Minh-Nguyen-CEAA/Optimal-Control-Of-A-Pesticide-Spray-Robot-Operating-In-A-Greenhouse/Data Calib/data2x2/UWB Noise Distribution.png

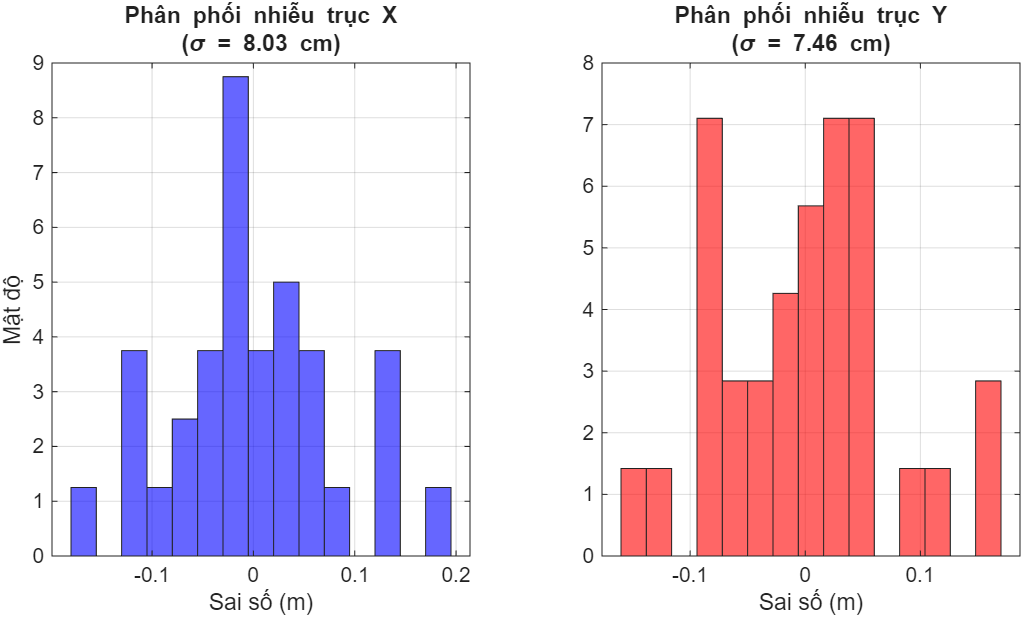
Data Calib/data2x2/UWB Noise Distribution.png
