Minh-Nguyen-CEAA/Optimal-Control-Of-A-Pesticide-Spray-Robot-Operating-In-A-Greenhouse/Slide.pdf

## ĐẠI HỌC QUỐC GIA THÀNH PHỐ HỒ CHÍ MINH TRƯỜNG ĐẠI HỌC BÁCH KHOA

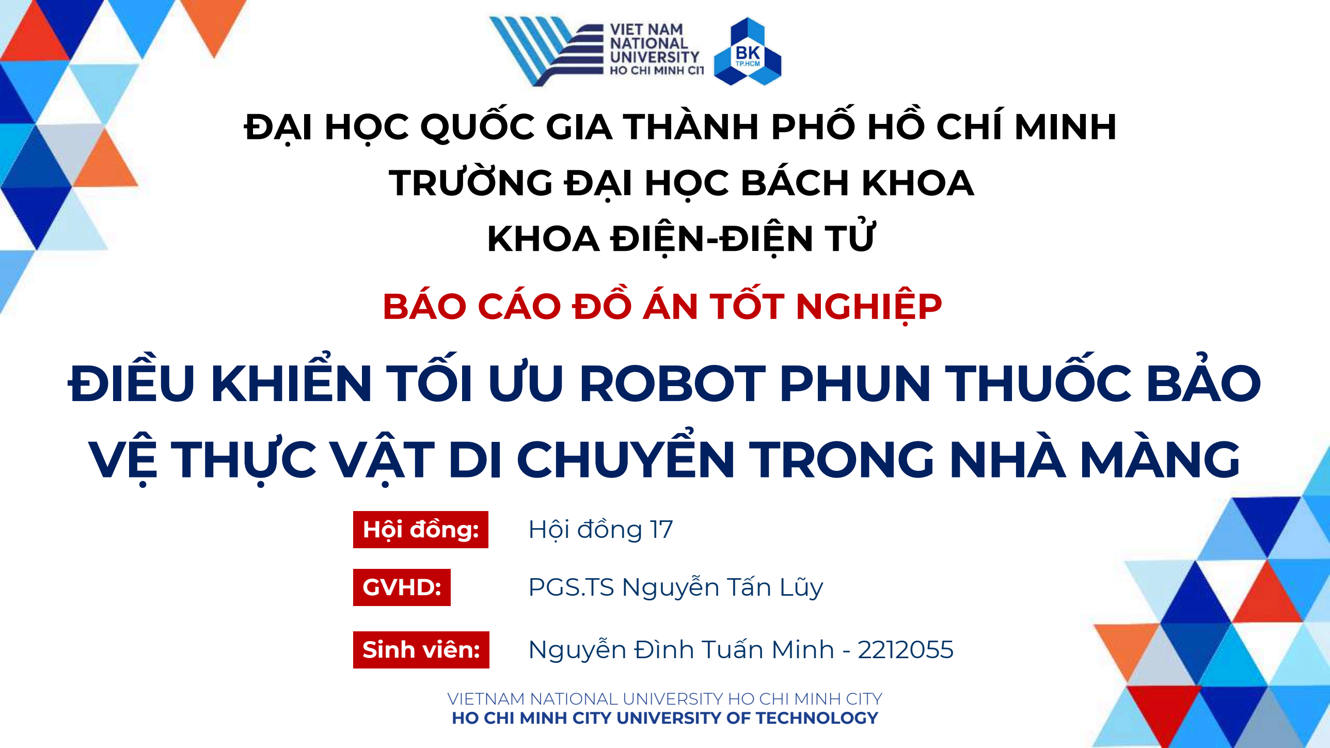
[picture p74: page 1]

VIETNAM NATIONAL UNIVERSITY HO CHI MINH CITY HO CHI MINH CITY UNIVERSITY OF TECHNOLOGY

# ĐIỀU KHIỂN TỐI ƯU ROBOT PHUN THUỐC BẢO VỆ THỰC VẬT DI CHUYỂN TRONG NHÀ MÀNG

## BÁO CÁO ĐỒ ÁN TỐT NGHIỆP

Sinh viên:

GVHD:

Nguyễn Đình Tuấn Minh - 2212055

PGS.TS Nguyễn Tấn Lũy

Hội đồng: Hội đồng 17

## KHOA ĐIỆN-ĐIỆN TỬ

## MỤC LỤC

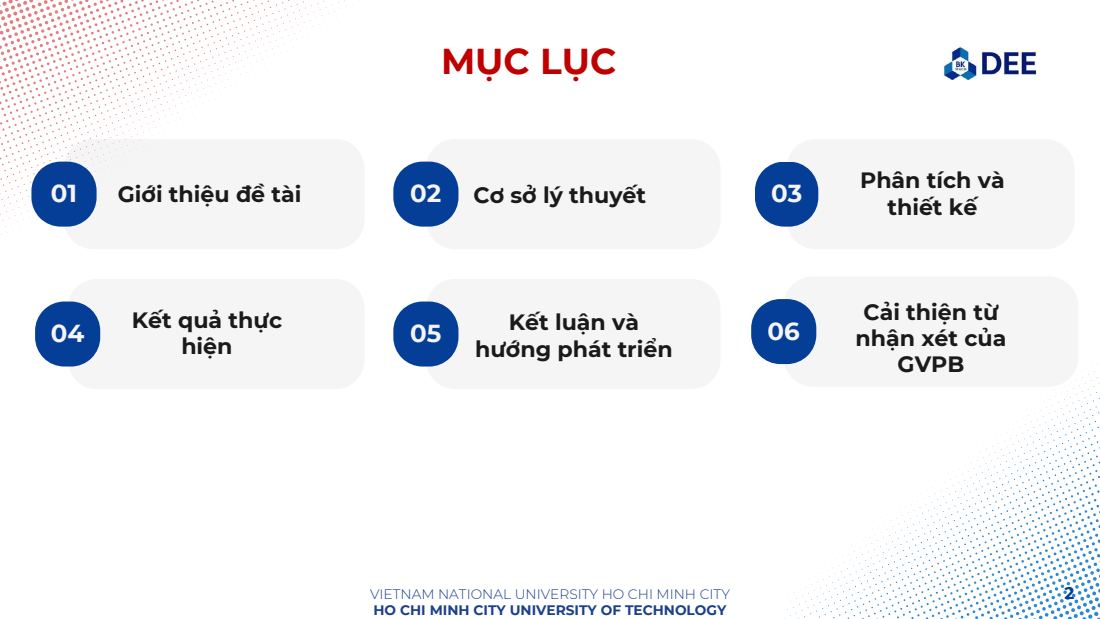
[picture p75: page 2]
Giới thiệu đề tài; Cơ sở lý thuyết; thiết kế

Phân tích và

Cải thiện từ
nhận xét của
GVPB

Kết quả thực
hiện

Kết luận và
hướng phát triển

VIETNAM NATIONAL UNIVERSITY HO CHI MINH CITY
HO CHI MINH CITY UNIVERSITY OF TECHNOLOGY

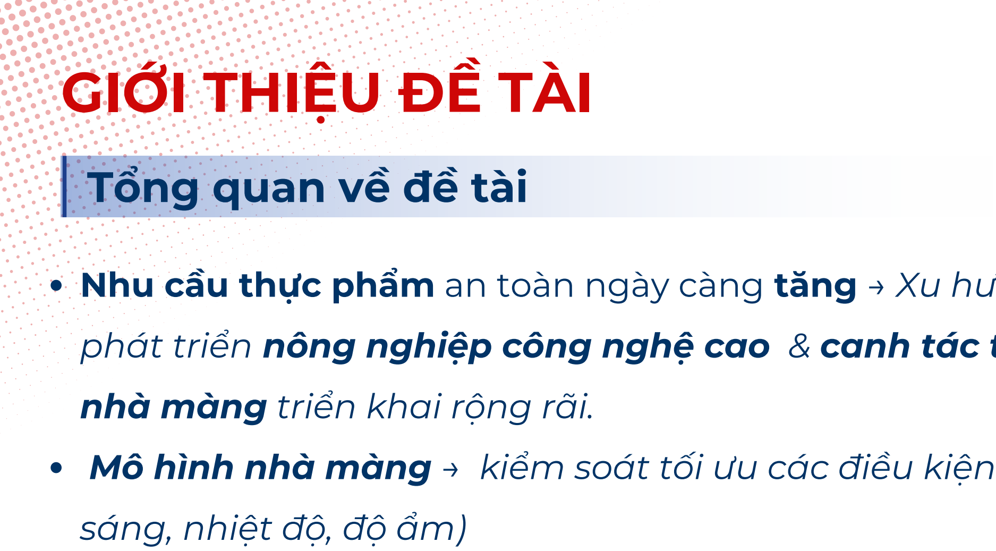
[picture p76: figure]
GIỚI THIỆU ĐỀ TÀI; nhà màng triển khai rộng rãi.; sáng, nhiệt độ, độ ẩm); Tổng quan về đề tài
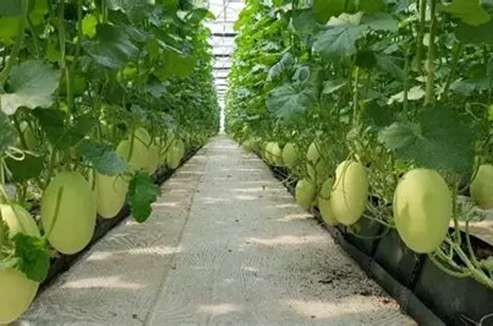
[picture p77: figure]

Nhu cầu thực phẩm an toàn ngày càng tăng → Xu hướng phát triển nông nghiệp công nghệ cao & canh tác trong

Mô hình nhà màng → kiểm soát tối ưu các điều kiện (ánh

Tăng năng suất và hạn chế sâu bệnh.
Thực trạng: công đoạn phun thuốc vẫn được thực hiện thủ công hoặc bán tự động
Tăng nguy cơ ngộ độc, bệnh,... cho người lao động

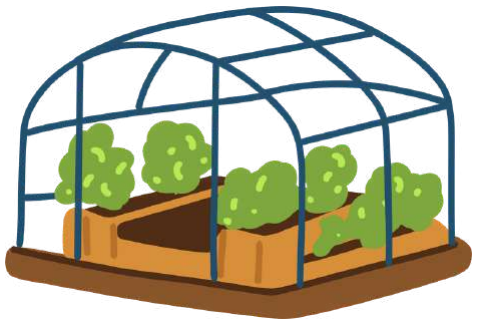
[picture p78: figure]
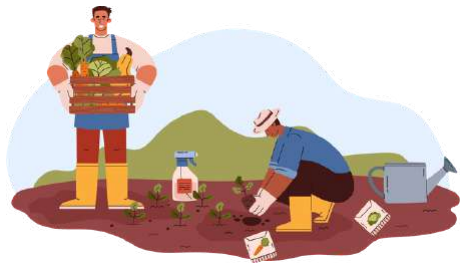
[picture p79: figure]

3

Hình 1. Mô hình nông nghiệp nhà màng tại Việt Nam
2-3lâ
̀
n
tỉ lệ công nhân trong
nhà màng bệnh so với
ngoài trời

30-50%

Tiết kiệm lượng thuốc

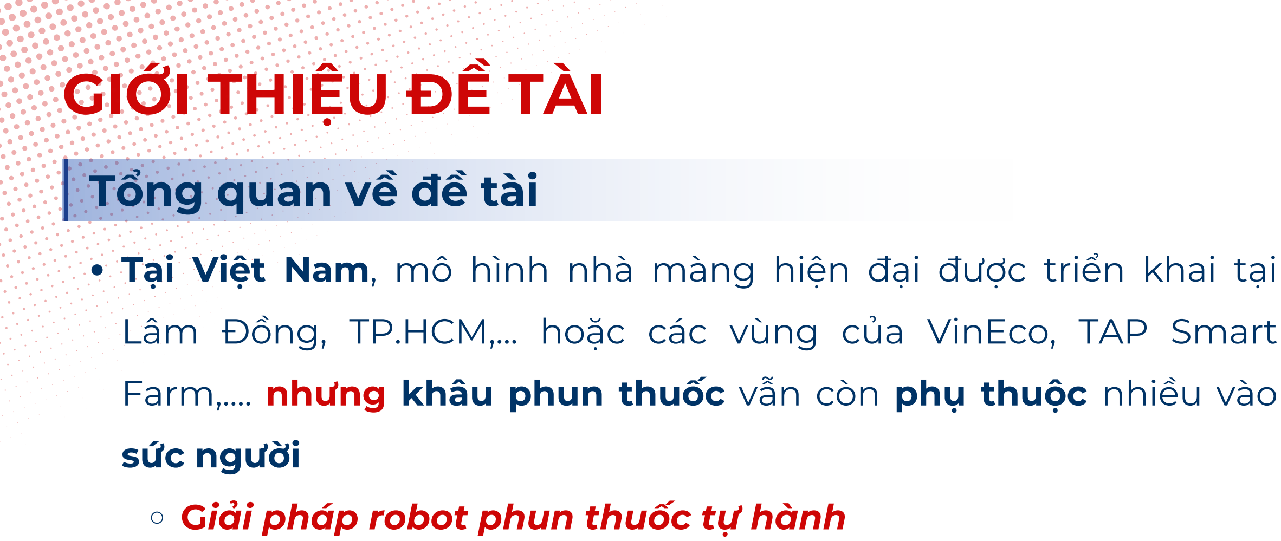
[picture p80: figure]
GIỚI THIỆU ĐỀ TÀI; Lâm Đồng, TP.HCM,... hoặc các; vùng của VinEco, TAP Smart; sức người Giải pháp robot phun thuốc tự hành; Tổng quan về đề tài

Tại Việt Nam, mô hình nhà màng hiện đại được triển khai tại

Farm,.... nhưng khâu phun thuốc vẫn còn phụ thuộc nhiều vào

Thách thức của robot trong nhà màng: Điều khiển và định vị chính xác khi tín hiệu GPS bị hạn chế và môi trường có nhiều nhiễu.

4

Hình 1. Mô hình nông nghiệp nhà màng tại Việt Nam

Đề tài tập trung xây dựng robot phun thuốc tự hành sử dụng kết hợp đa cảm biến (UWB, IMU, Encoder) và thuật toán Kalman mở rộng (EKF) nhằm nâng cao khả năng định vị và điều khiển.

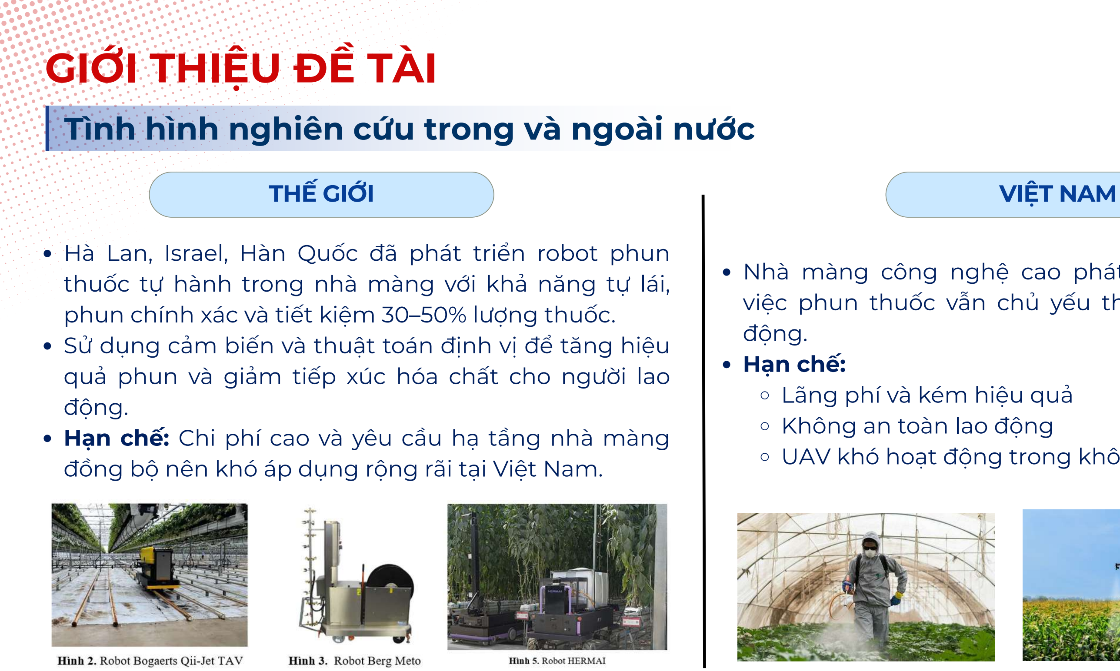
[picture p81: figure]
GIỚI THIỆU ĐỀ TÀI; THẾ GIỚI; VIỆT NAM; động. Hạn chế: Lãng phí và kém hiệu quả Không an toàn lao động; động.
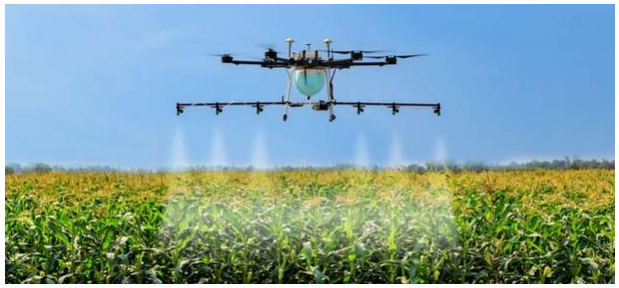
[picture p82: figure]
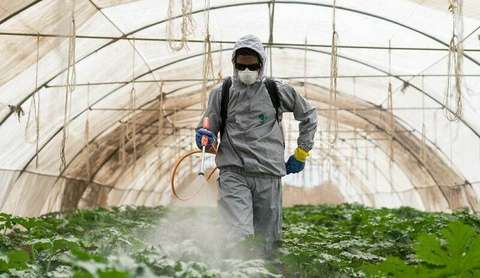
[picture p83: figure]

Nghiên cứu robot phun thuốc tự hành phù hợp điều kiện Việt Nam, ứng dụng thuật toán điều
khiển và định vị. | 5

Nhà màng công nghệ cao phát triển nhanh nhưng việc phun thuốc vẫn chủ yếu thủ công hoặc bán tự

UAV khó hoạt động trong không gian nhà màng.

Hà Lan, Israel, Hàn Quốc đã phát triển robot phun thuốc tự hành trong nhà màng với khả năng tự lái, phun chính xác và tiết kiệm 30–50% lượng thuốc.
Sử dụng cảm biến và thuật toán định vị để tăng hiệu quả phun và giảm tiếp xúc hóa chất cho người lao

Hạn chế: Chi phí cao và yêu cầu hạ tầng nhà màng đồng bộ nên khó áp dụng rộng rãi tại Việt Nam.

Tình hình nghiên cứu trong và ngoài nước

## GIỚI THIỆU ĐỀ TÀI

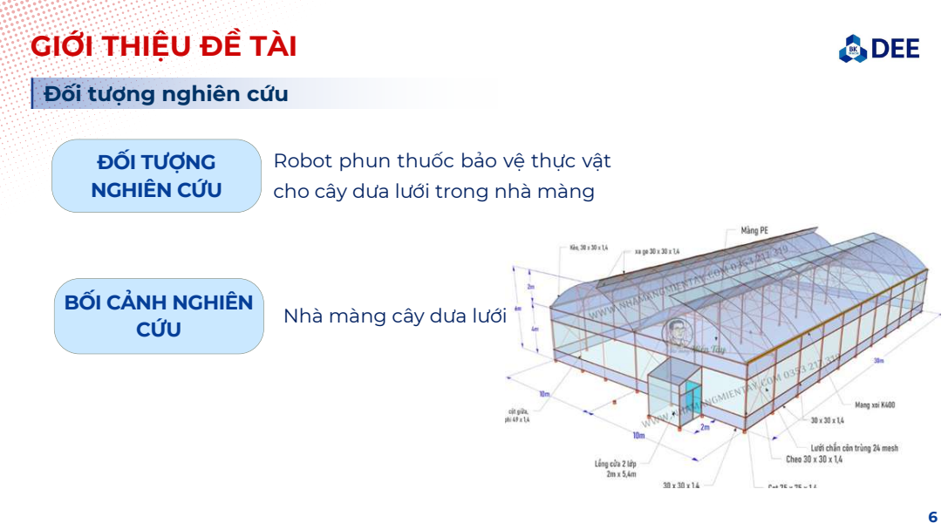
[picture p84: page 6]
ĐỐI TƯỢNG NGHIÊN CỨU

Đối tượng nghiên cứu

Robot phun thuốc bảo vệ thực vật
cho cây dưa lưới trong nhà màng

BỐI CẢNH NGHIÊN
CỨU

Nhà màng cây dưa lưới

## GIỚI THIỆU ĐỀ TÀI

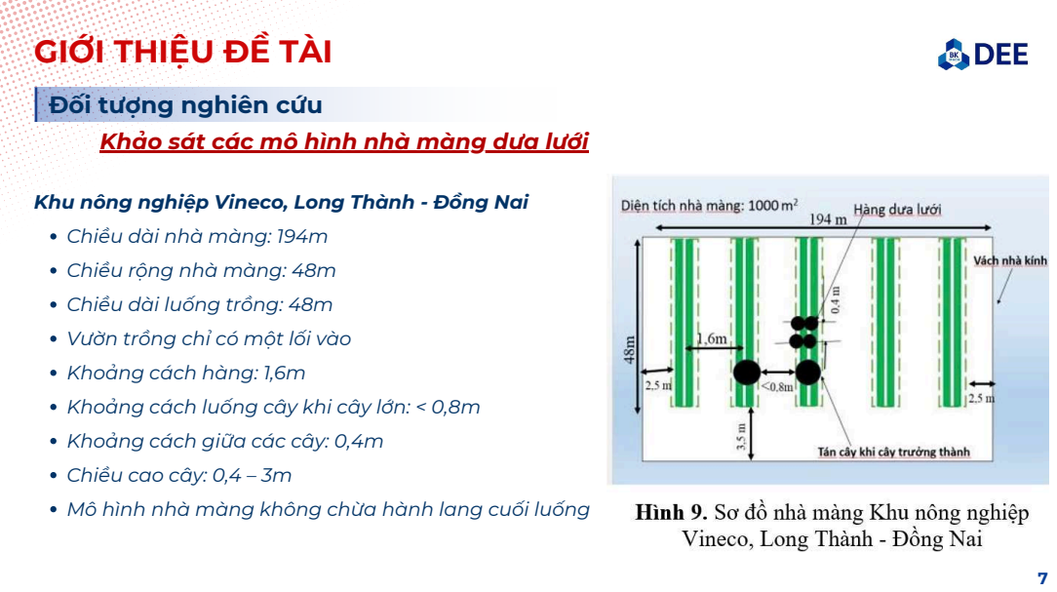
[picture p85: page 7]

Đối tượng nghiên cứu
Khảo sát các mô hình nhà màng dưa lưới

Khu nông nghiệp Vineco, Long Thành - Đồng Nai
Chiều dài nhà màng: 194m
Chiều rộng nhà màng: 48m
Chiều dài luống trồng: 48m
Vườn trồng chỉ có một lối vào
Khoảng cách hàng: 1,6m
Khoảng cách luống cây khi cây lớn: < 0,8m
Khoảng cách giữa các cây: 0,4m
Chiều cao cây: 0,4 – 3m
Mô hình nhà màng không chừa hành lang cuối luống

## GIỚI THIỆU ĐỀ TÀI

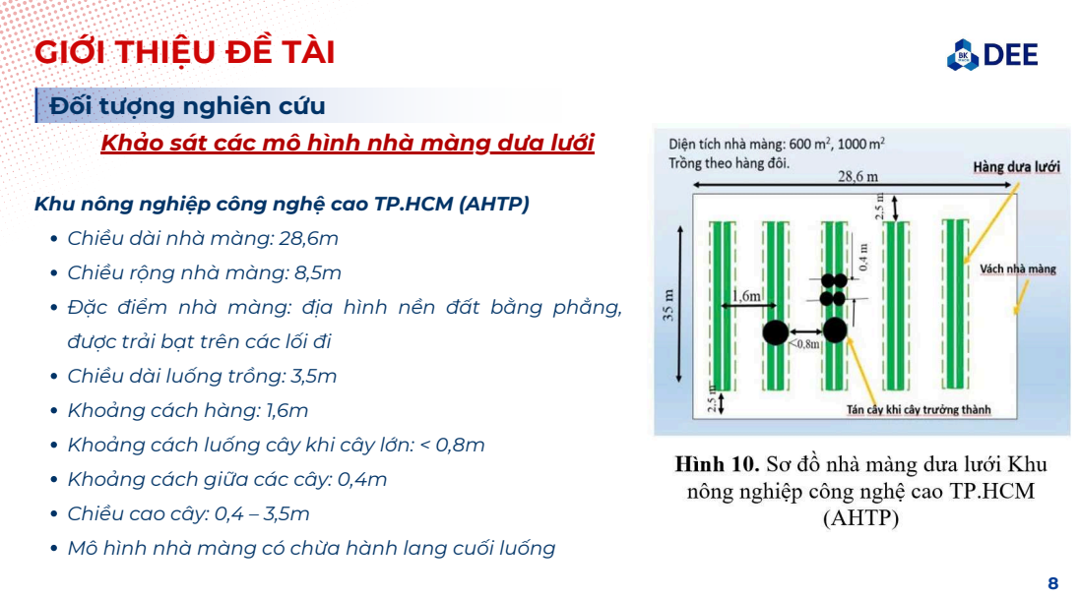
[picture p86: page 8]

Đối tượng nghiên cứu
Khảo sát các mô hình nhà màng dưa lưới

Khu nông nghiệp công nghệ cao TP.HCM (AHTP)
Chiều dài nhà màng: 28,6m
Chiều rộng nhà màng: 8,5m
Đặc điểm nhà màng: địa hình nền đất bằng phẳng,
được trải bạt trên các lối đi
Chiều dài luống trồng: 3,5m
Khoảng cách hàng: 1,6m
Khoảng cách luống cây khi cây lớn: < 0,8m
Khoảng cách giữa các cây: 0,4m
Chiều cao cây: 0,4 – 3,5m
Mô hình nhà màng có chừa hành lang cuối luống

## GIỚI THIỆU ĐỀ TÀI

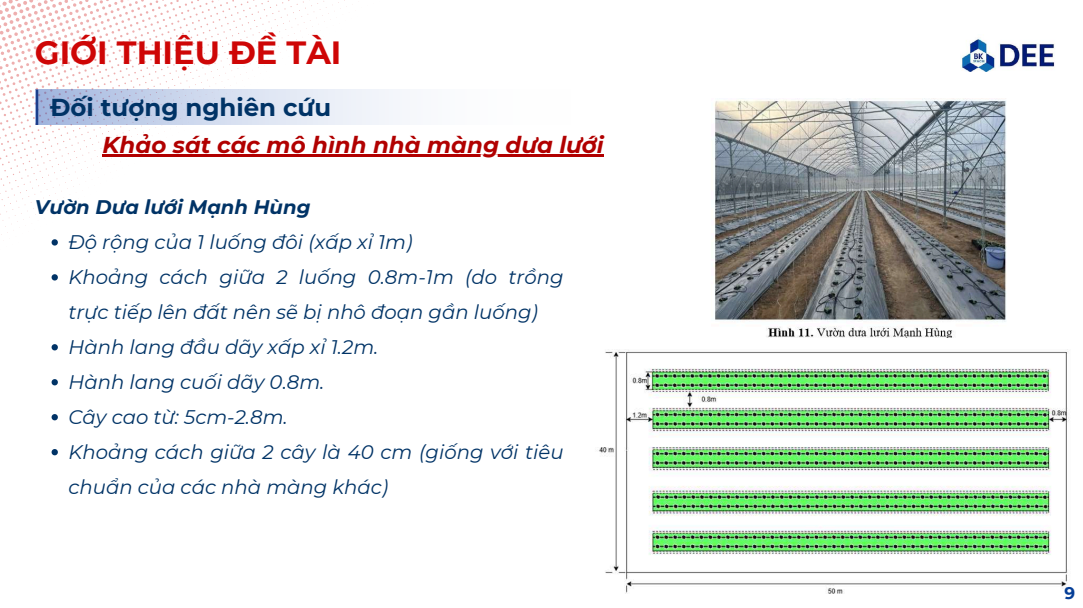
[picture p87: page 9]

Đối tượng nghiên cứu
Khảo sát các mô hình nhà màng dưa lưới

Vườn Dưa lưới Mạnh Hùng
Độ rộng của 1 luống đôi (xấp xỉ 1m)
Khoảng cách giữa 2 luống 0.8m-1m (do trồng
trực tiếp lên đất nên sẽ bị nhô đoạn gần luống)
Hành lang đầu dãy xấp xỉ 1.2m.
Hành lang cuối dãy 0.8m.
Cây cao từ: 5cm-2.8m.
Khoảng cách giữa 2 cây là 40 cm (giống với tiêu
chuẩn của các nhà màng khác)

## GIỚI THIỆU ĐỀ TÀI

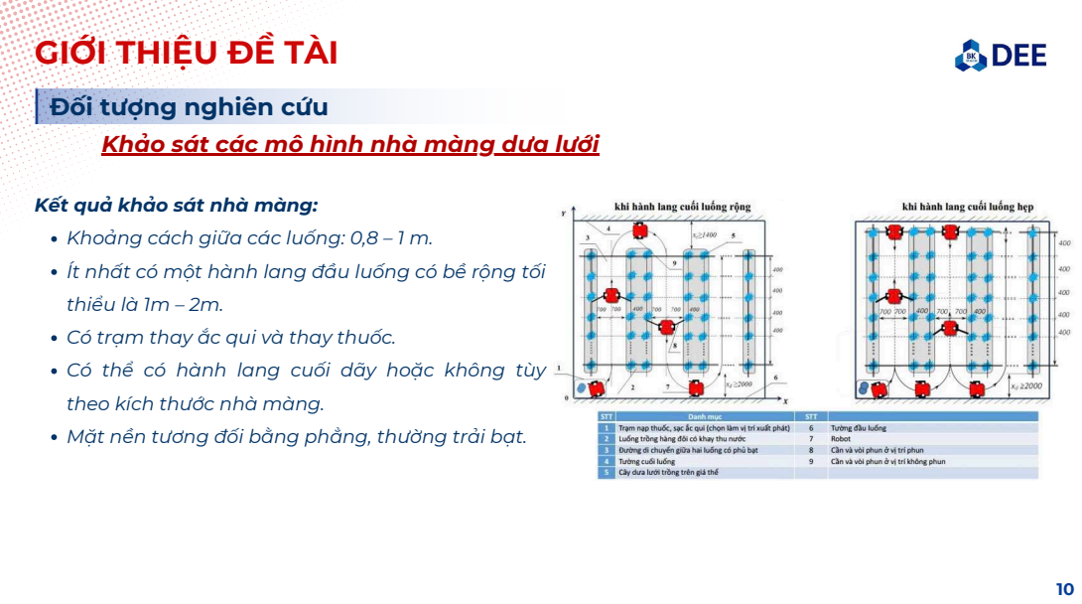
[picture p88: page 10]

Đối tượng nghiên cứu
Khảo sát các mô hình nhà màng dưa lưới

Kết quả khảo sát nhà màng:
Khoảng cách giữa các luống: 0,8 – 1 m.
Ít nhất có một hành lang đầu luống có bề rộng tối
thiểu là 1m – 2m.
Có trạm thay ắc qui và thay thuốc.
Có thể có hành lang cuối dãy hoặc không tùy
theo kích thước nhà màng.
Mặt nền tương đối bằng phẳng, thường trải bạt.

11

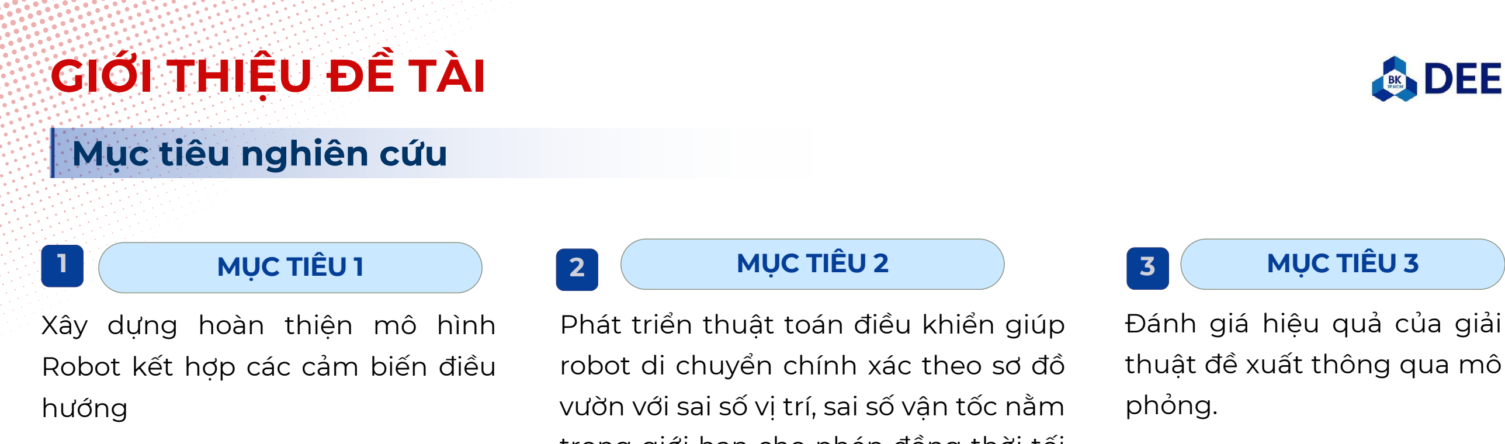
[picture p89: figure]
GIỚI THIỆU ĐỀ TÀI; Xây dựng hoàn thiện mô hình Robot kết hợp các cảm biến điều hướng; Phát triển thuật toán điều khiển giúp robot di chuyển chính xác theo sơ đồ; Đánh giá hiệu quả của giải thuật đề xuất thông qua mô phỏng.; MỤC TIÊU 1; MỤC TIÊU 2; MỤC TIÊU 3; Mục tiêu nghiên cứu

vườn với sai số vị trí, sai số vận tốc nằm trong giới hạn cho phép đồng thời tối ưu hóa năng lượng và bền vững.

4
Phát triển thuật toán định vị dựa trên tổng hợp dữ liệu cảm biến từ Encoder, IMU, UWB thông qua bộ lọc Kalman mở rộng (EKF) cho Robot.

5

Kết hợp bộ lọc EKF và giải thuật điều khiển và thực
nghiệm.
MỤC TIÊU 4 | MỤC TIÊU 5

## GIỚI THIỆU ĐỀ TÀI

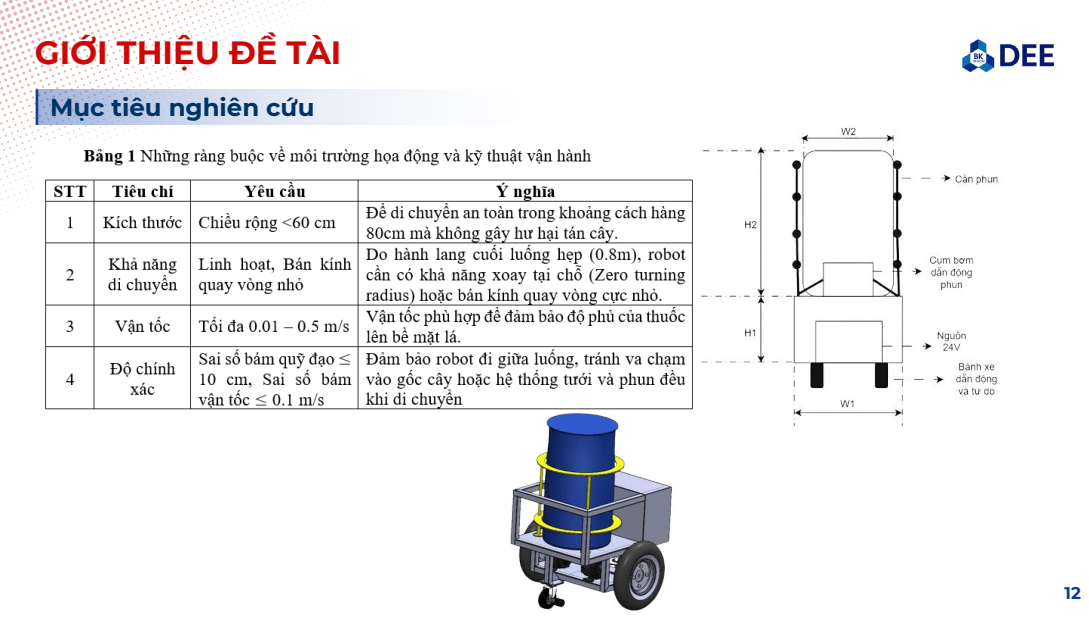
[picture p90: page 12]

Mục tiêu nghiên cứu

## GIỚI THIỆU ĐỀ TÀI

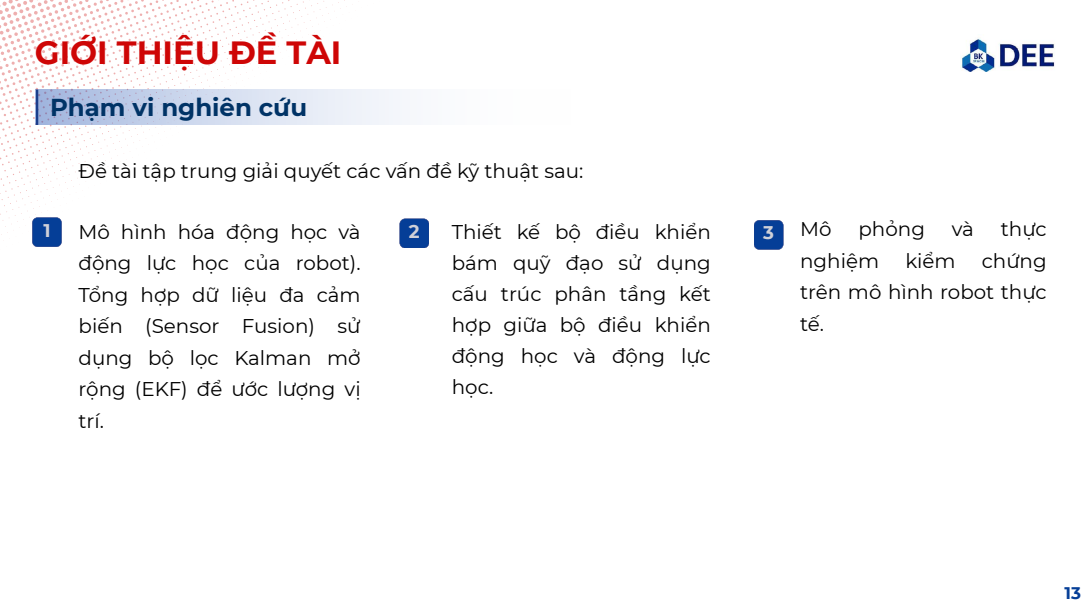
[picture p91: page 13]
Mô hình hóa động học và

Phạm vi nghiên cứu

Đề tài tập trung giải quyết các vấn đề kỹ thuật sau:

động lực học của robot).
Tổng hợp dữ liệu đa cảm
biến (Sensor Fusion) sử
dụng bộ lọc Kalman mở
rộng (EKF) để ước lượng vị
trí.

Thiết kế bộ điều khiển
bám quỹ đạo sử dụng
cấu trúc phân tầng kết
hợp giữa bộ điều khiển
động học và động lực
học.

Mô phỏng và thực
nghiệm kiểm chứng
trên mô hình robot thực

## MÔ HÌNH PHI TUYẾN WMR

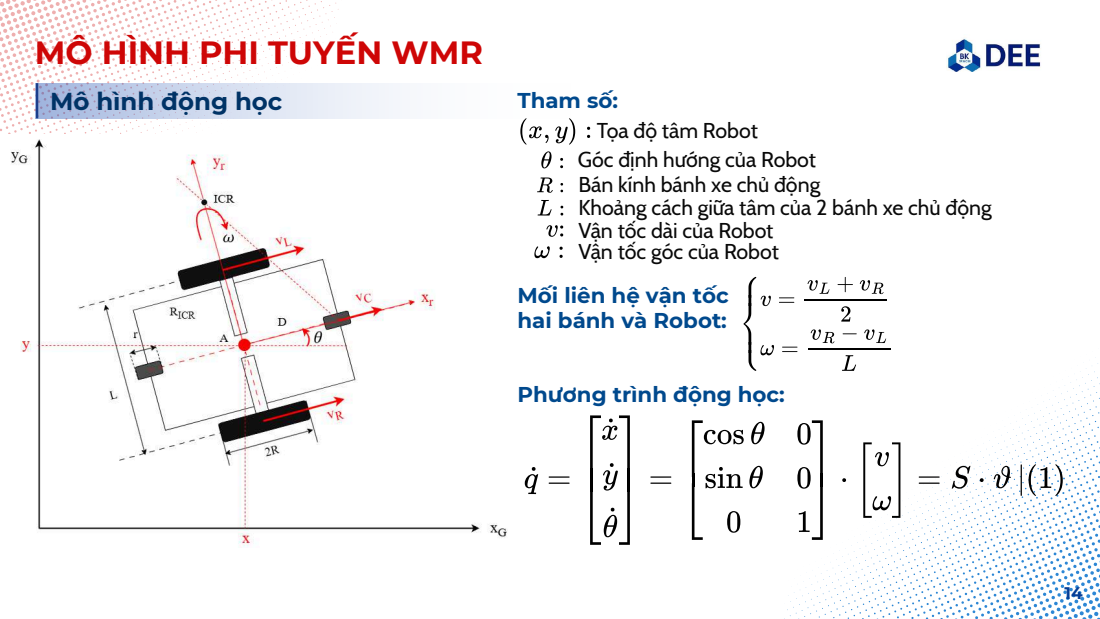
[picture p92: page 14]
Mô hình động học; Tham số:

Tọa độ tâm Robot
Góc định hướng của Robot
Bán kính bánh xe chủ động
Khoảng cách giữa tâm của 2 bánh xe chủ động
Vận tốc dài của Robot
Vận tốc góc của Robot
Mối liên hệ vận tốc
hai bánh và Robot:

Phương trình động học:

## MÔ HÌNH PHI TUYẾN WMR

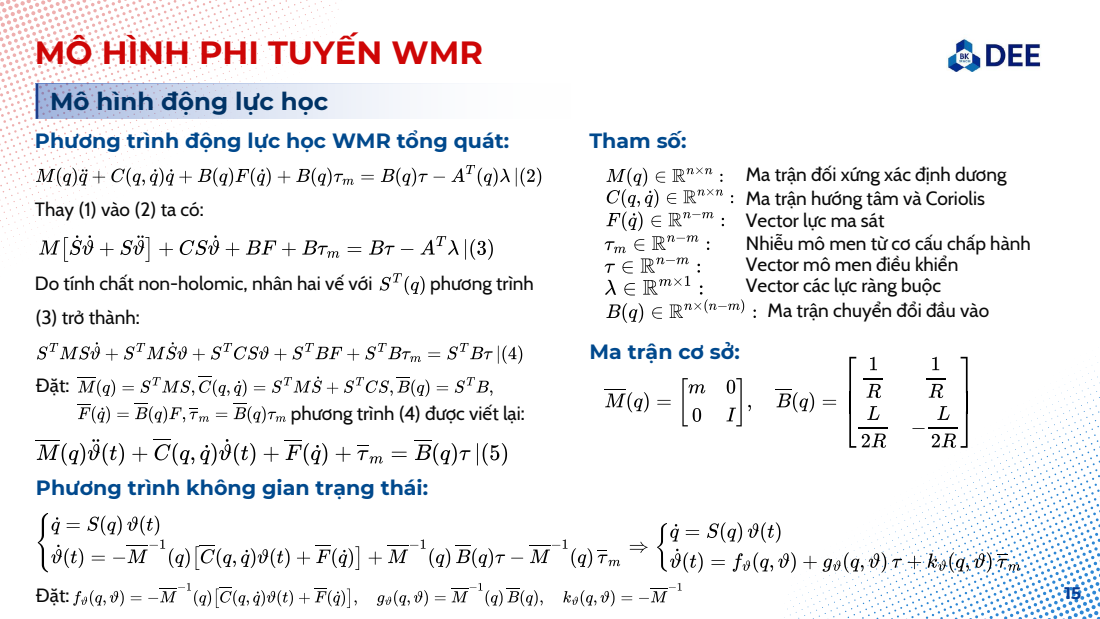
[picture p93: page 15]
Tham số:; phương trình; Đặt:

Mô hình động lực học
Phương trình động lực học WMR tổng quát:

Ma trận đối xứng xác định dương
Ma trận hướng tâm và Coriolis
Vector lực ma sát
Nhiễu mô men từ cơ cấu chấp hành
Vector mô men điều khiển
Vector các lực ràng buộc
Ma trận chuyển đổi đầu vào

Thay (1) vào (2) ta có:

Do tính chất non-holomic, nhân hai vế với
(3) trở thành:

Ma trận cơ sở:

phương trình (4) được viết lại:

Phương trình không gian trạng thái:

## BỘ ĐIỀU KHIỂN ĐỘNG HỌC KANAYAMAN

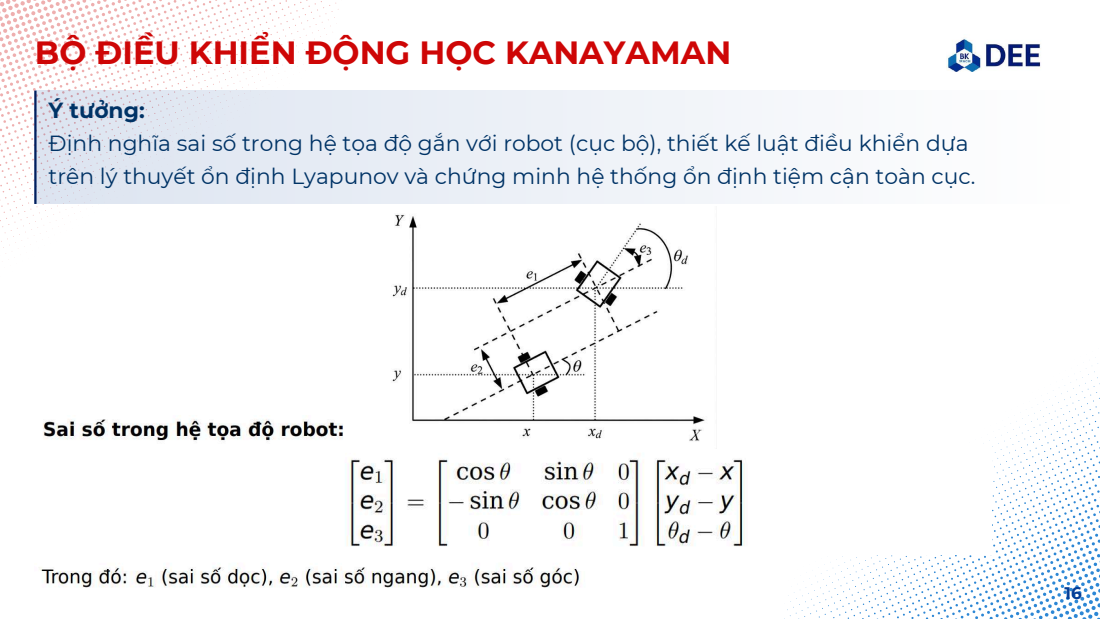
[picture p94: page 16]

Ý tưởng:
Định nghĩa sai số trong hệ tọa độ gắn với robot (cục bộ), thiết kế luật điều khiển dựa
trên lý thuyết ổn định Lyapunov và chứng minh hệ thống ổn định tiệm cận toàn cục.

## BỘ ĐIỀU KHIỂN ĐỘNG HỌC KANAYAMAN

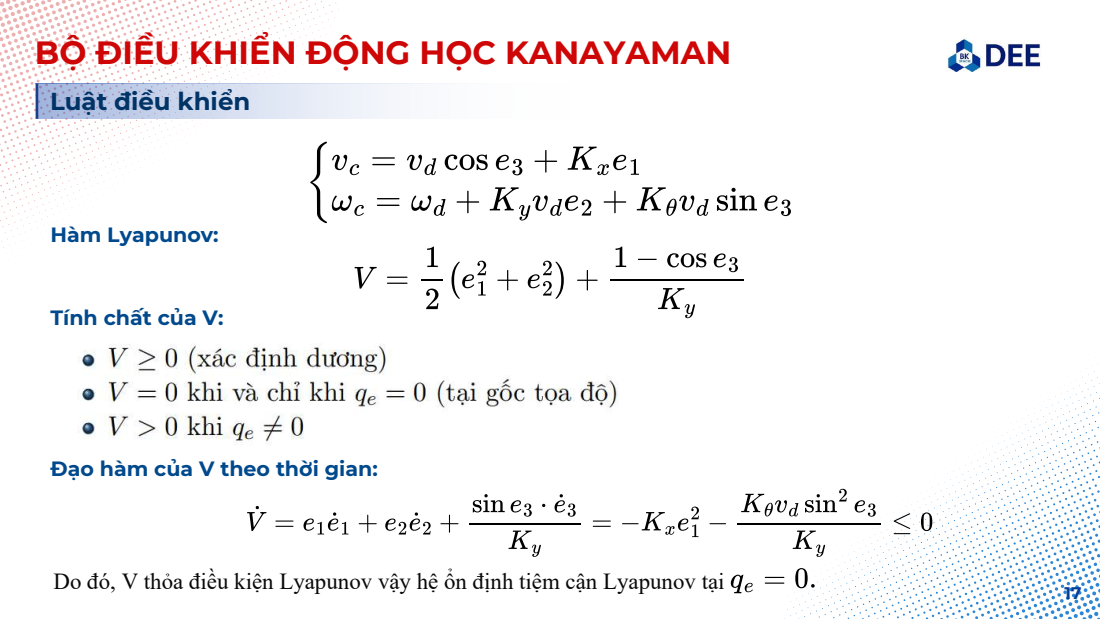
[picture p95: page 17]
Hàm Lyapunov:

Luật điều khiển

Tính chất của V:

Đạo hàm của V theo thời gian:

17 Do đó, V thỏa điều kiện Lyapunov vậy hệ ổn định tiệm cận Lyapunov tại

## HỌC CỦNG CỐ TRONG ĐIỀU KHIỂN THÍCH NGHI BỀN VỮNG

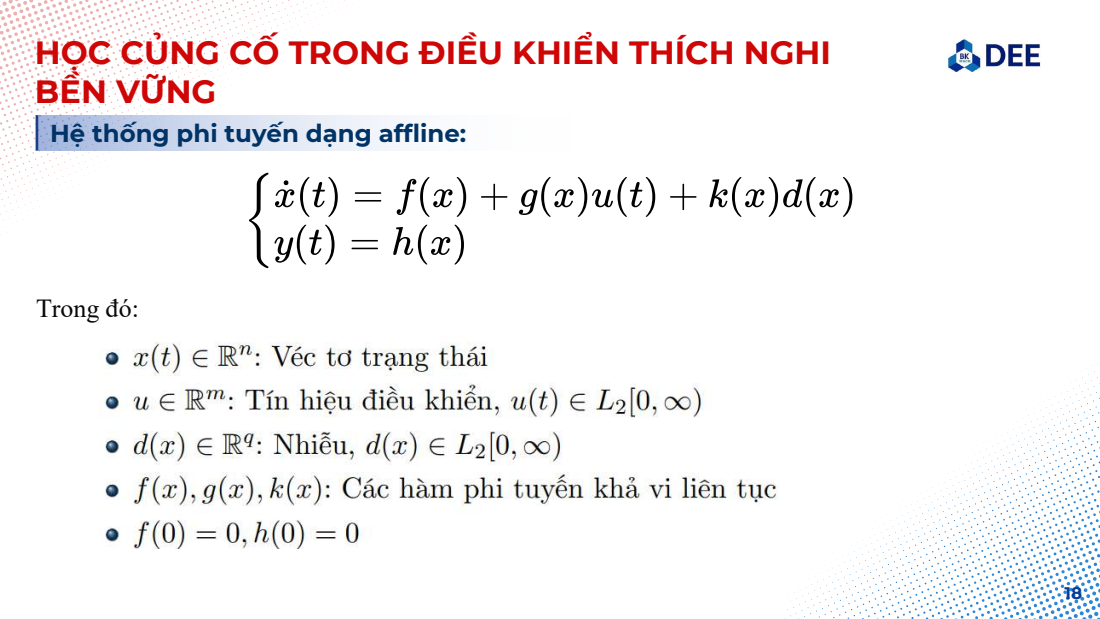
[picture p96: page 18]
Trong đó:

Hệ thống phi tuyến dạng affline:

## HỌC CỦNG CỐ TRONG ĐIỀU KHIỂN THÍCH NGHI BỀN VỮNG

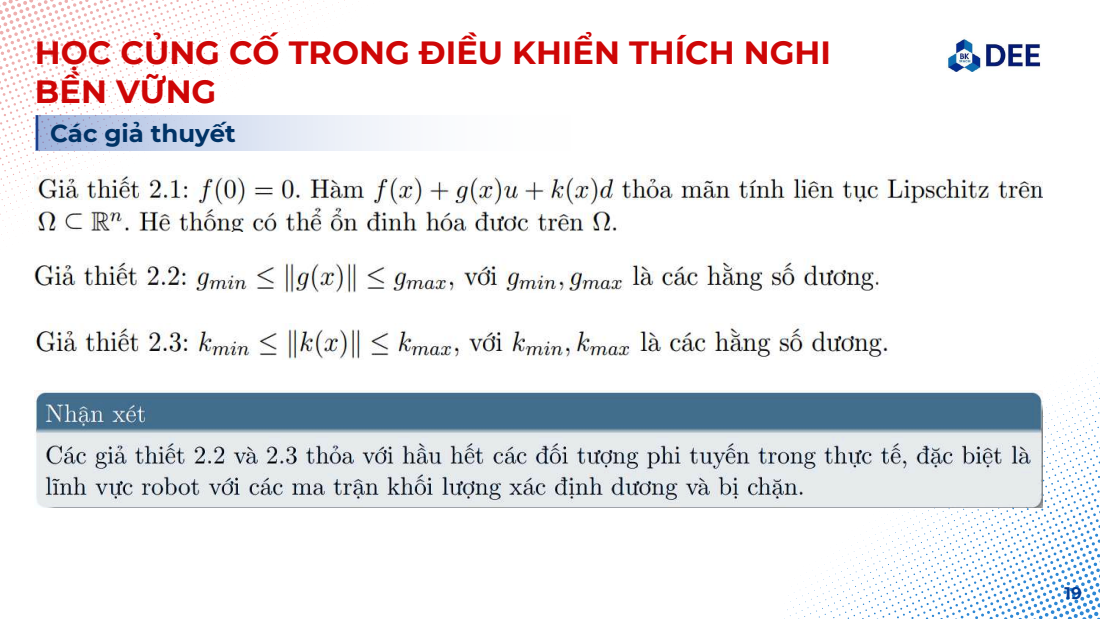
[picture p97: page 19]

Các giả thuyết

## HỌC CỦNG CỐ TRONG ĐIỀU KHIỂN THÍCH NGHI BỀN VỮNG

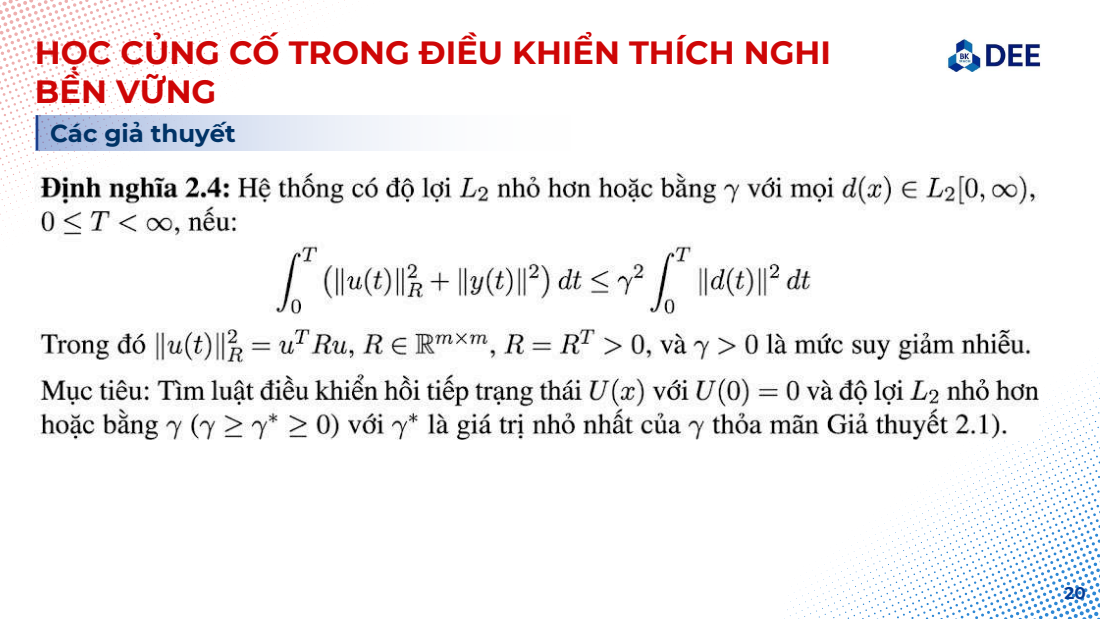
[picture p98: page 20]

Các giả thuyết

## HỌC CỦNG CỐ TRONG ĐIỀU KHIỂN THÍCH NGHI BỀN VỮNG

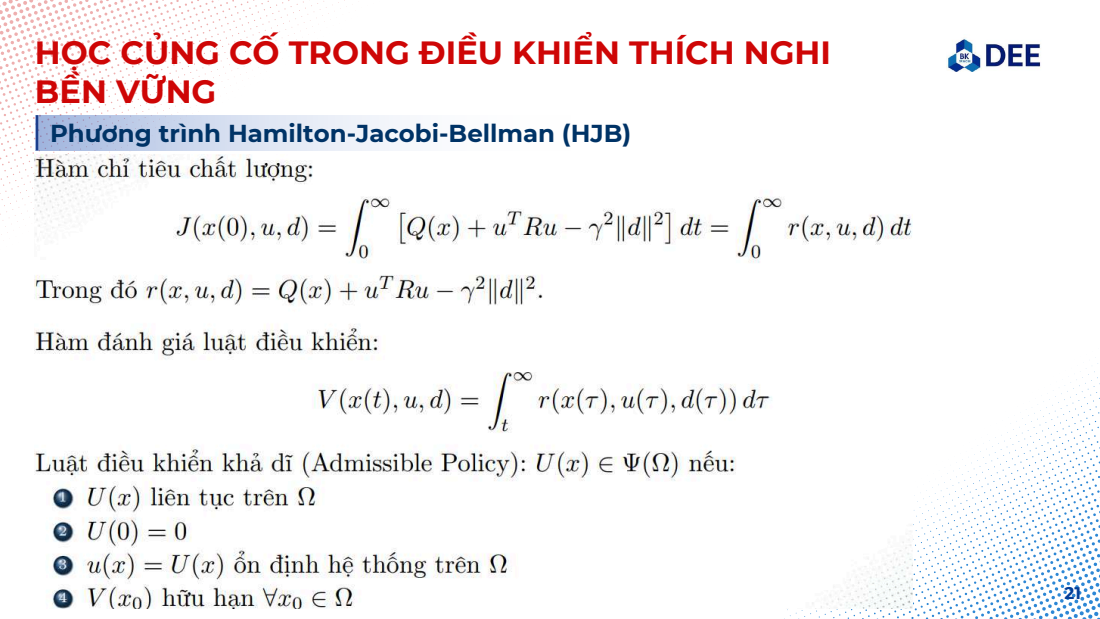
[picture p99: page 21]

Phương trình Hamilton-Jacobi-Bellman (HJB)

## HỌC CỦNG CỐ TRONG ĐIỀU KHIỂN THÍCH NGHI BỀN VỮNG

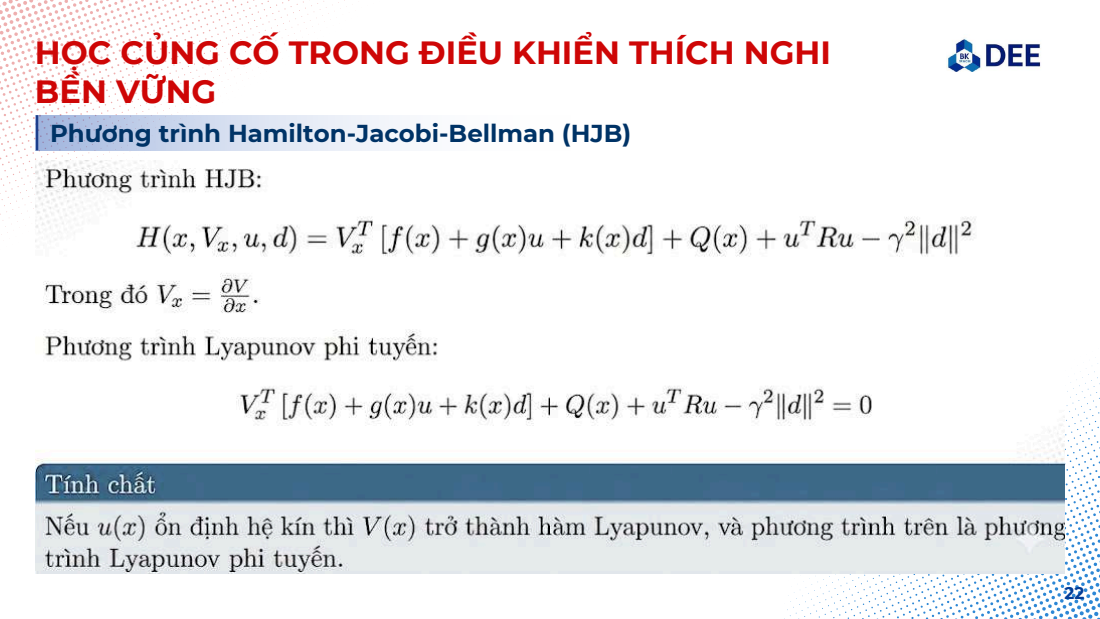
[picture p100: page 22]

Phương trình Hamilton-Jacobi-Bellman (HJB)

## HỌC CỦNG CỐ TRONG ĐIỀU KHIỂN THÍCH NGHI BỀN VỮNG

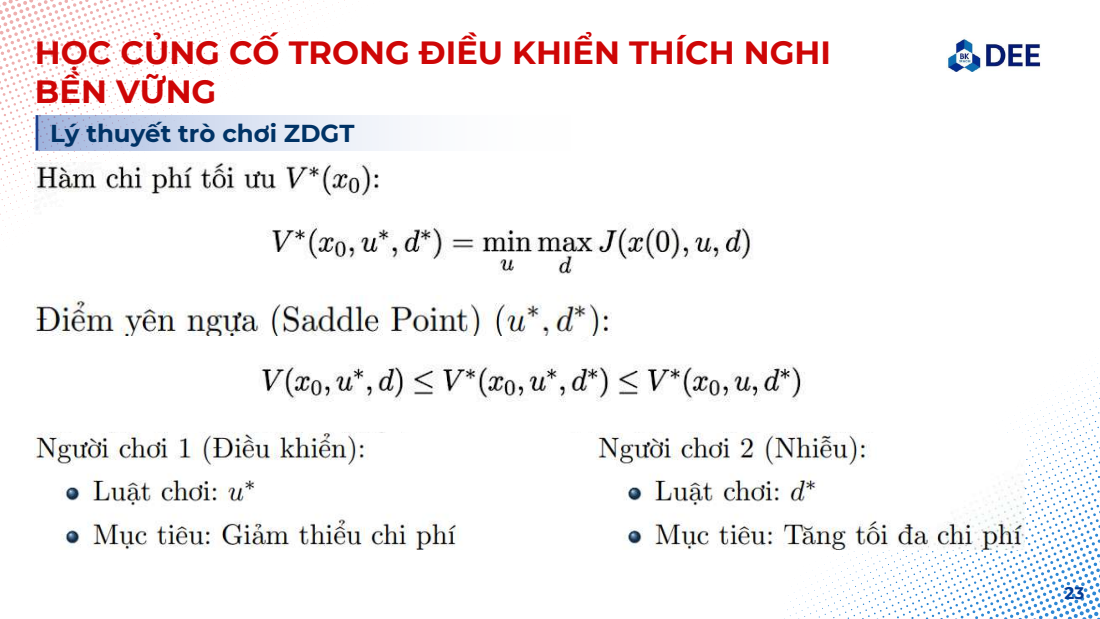
[picture p101: page 23]

Lý thuyết trò chơi ZDGT

## HỌC CỦNG CỐ TRONG ĐIỀU KHIỂN THÍCH NGHI BỀN VỮNG

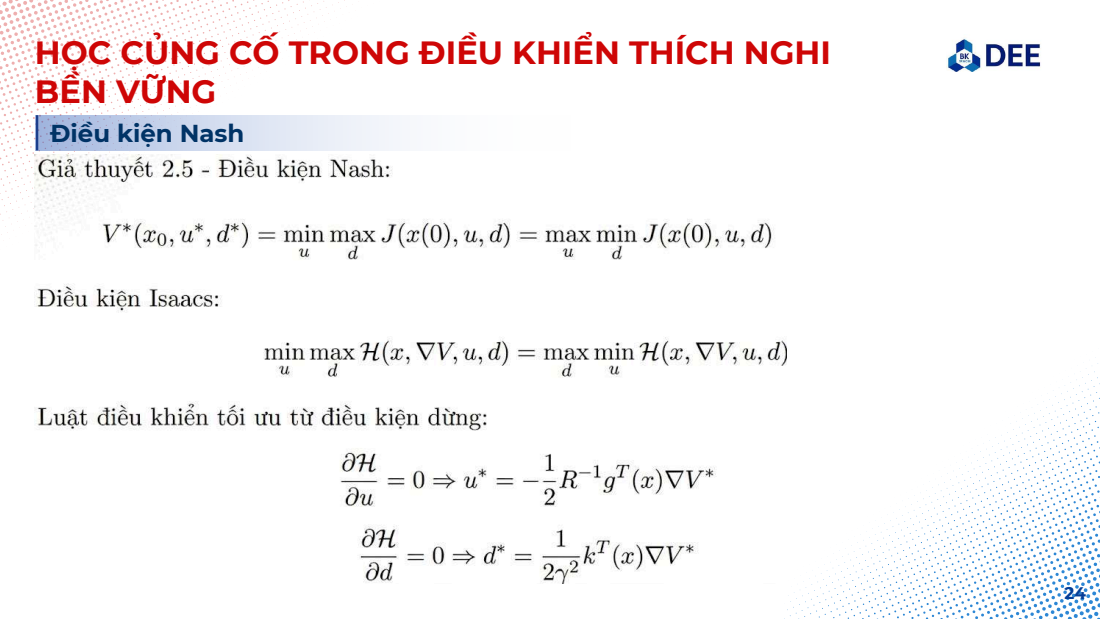
[picture p102: page 24]

Điều kiện Nash

## HỌC CỦNG CỐ TRONG ĐIỀU KHIỂN THÍCH NGHI BỀN VỮNG

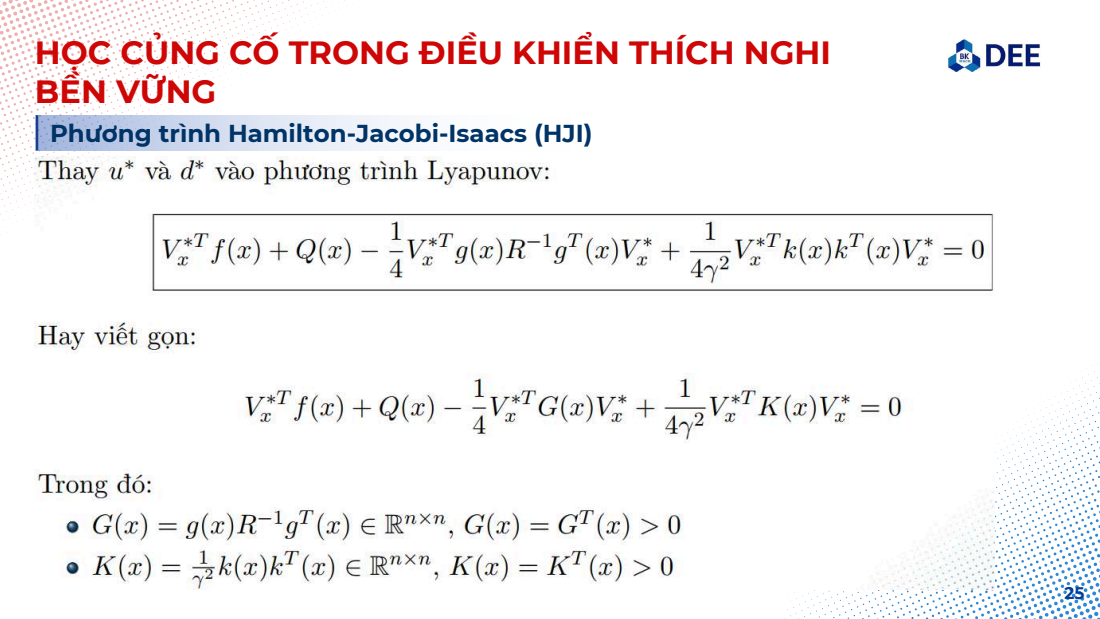
[picture p103: page 25]

Phương trình Hamilton-Jacobi-Isaacs (HJI)

## HỌC CỦNG CỐ TRONG ĐIỀU KHIỂN THÍCH NGHI BỀN VỮNG

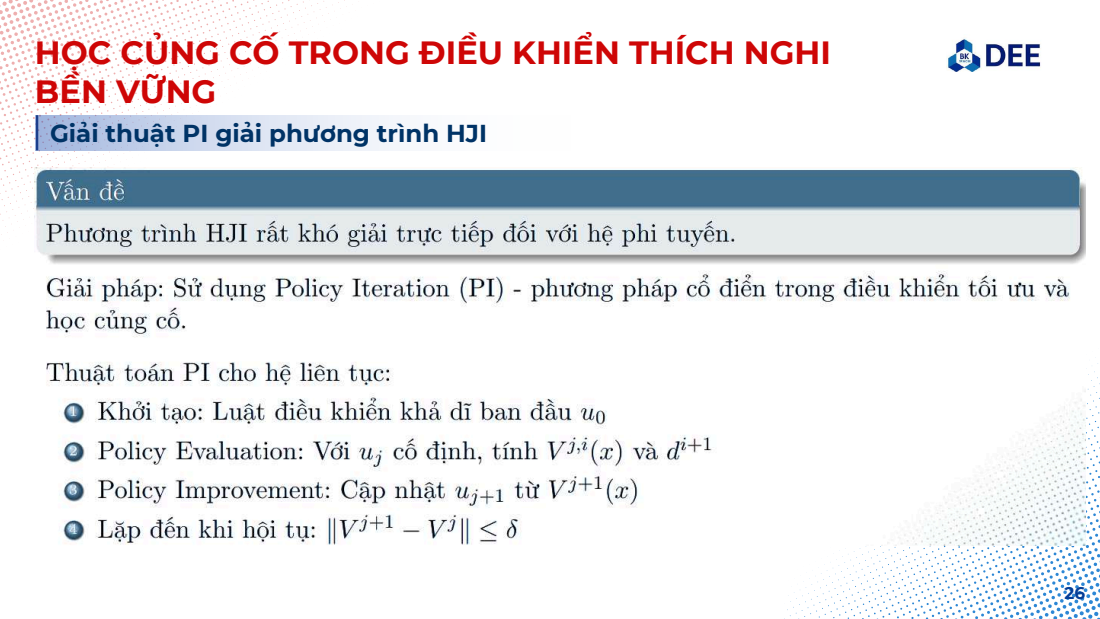
[picture p104: page 26]

Giải thuật PI giải phương trình HJI

## HỌC CỦNG CỐ TRONG ĐIỀU KHIỂN THÍCH NGHI BỀN VỮNG

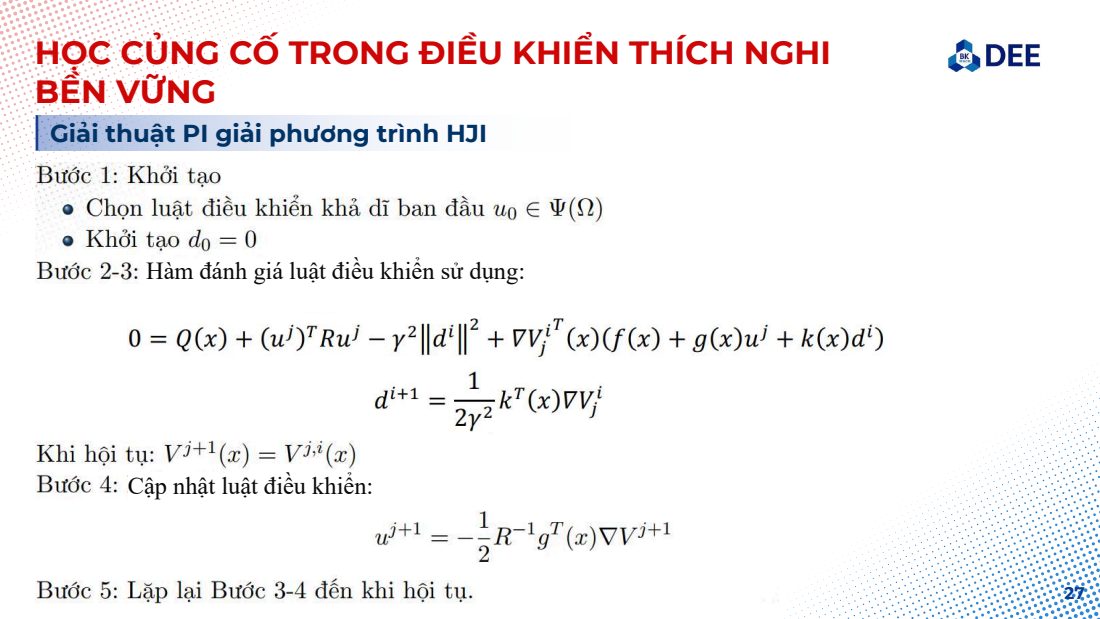
[picture p105: page 27]

Giải thuật PI giải phương trình HJI

Hàm đánh giá luật điều khiển sử dụng:

Cập nhật luật điều khiển:

## HỌC CỦNG CỐ TRONG ĐIỀU KHIỂN THÍCH NGHI BỀN VỮNG

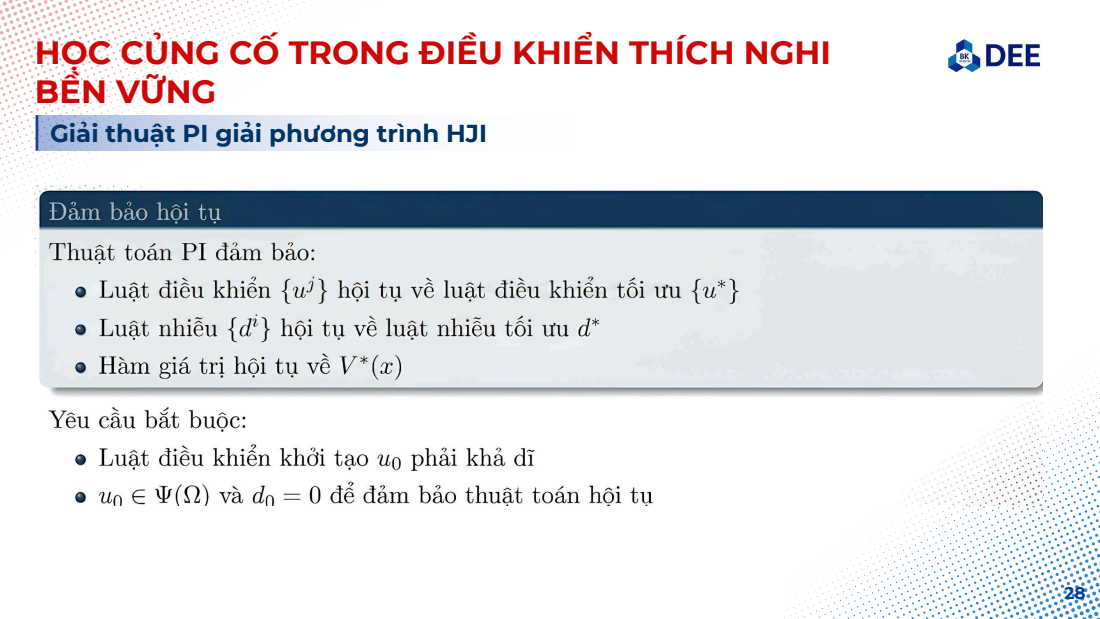
[picture p106: page 28]

Giải thuật PI giải phương trình HJI

## HỌC CỦNG CỐ TRONG ĐIỀU KHIỂN THÍCH NGHI BỀN VỮNG

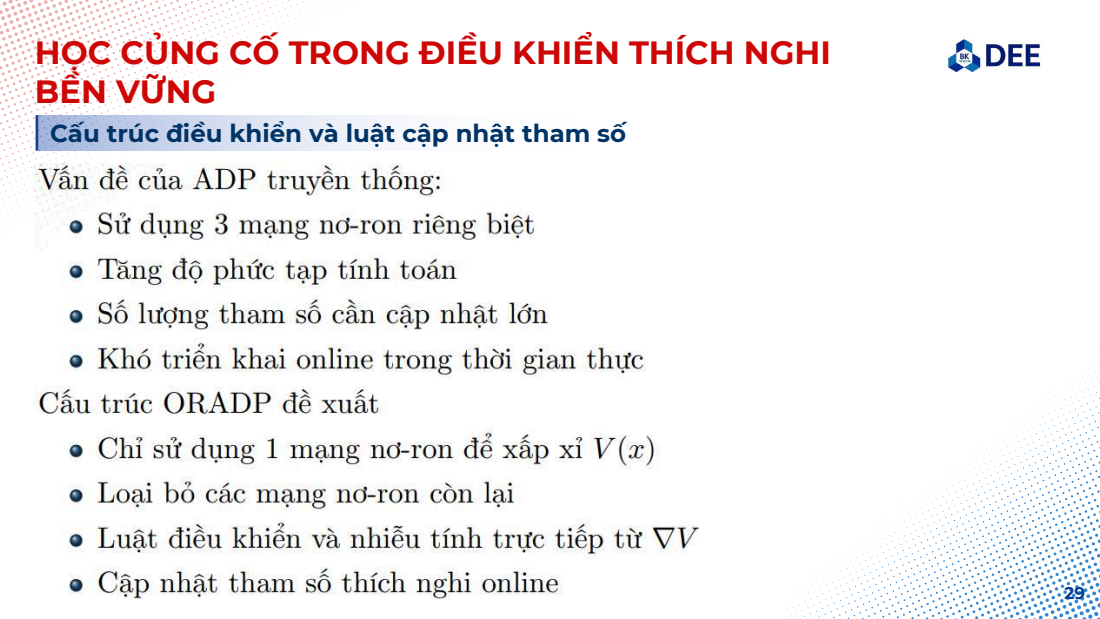
[picture p107: page 29]
sau

Cấu trúc điều khiển và luật cập nhật tham số

## HỌC CỦNG CỐ TRONG ĐIỀU KHIỂN THÍCH NGHI BỀN VỮNG

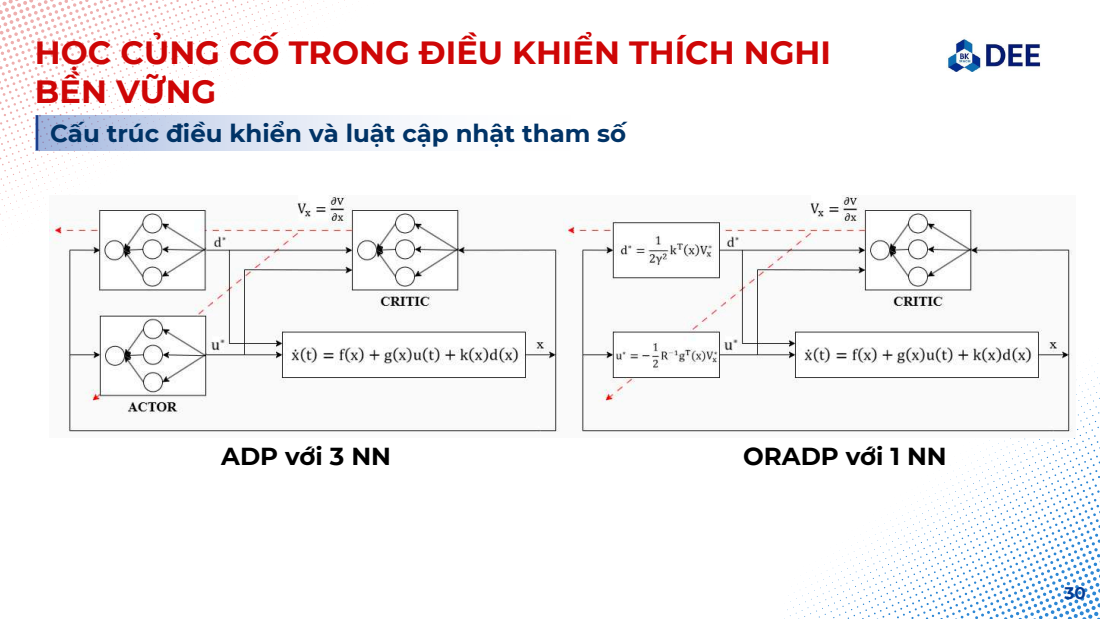
[picture p108: page 30]
ADP với 3 NN; ORADP với 1 NN

Cấu trúc điều khiển và luật cập nhật tham số

## HỌC CỦNG CỐ TRONG ĐIỀU KHIỂN THÍCH NGHI BỀN VỮNG

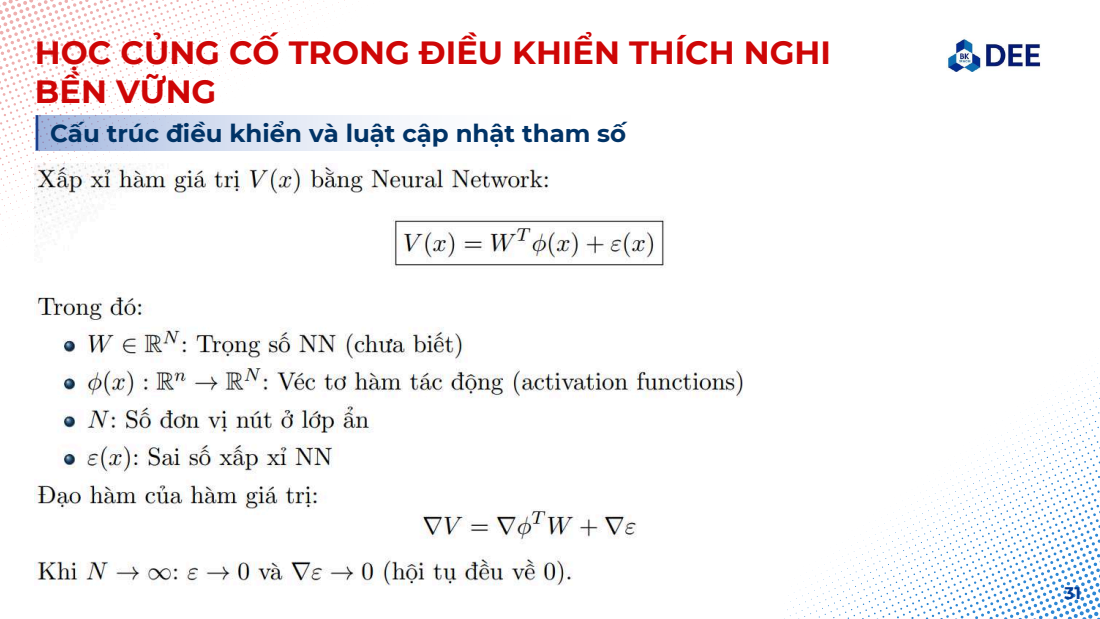
[picture p109: page 31]

Cấu trúc điều khiển và luật cập nhật tham số

## HỌC CỦNG CỐ TRONG ĐIỀU KHIỂN THÍCH NGHI BỀN VỮNG

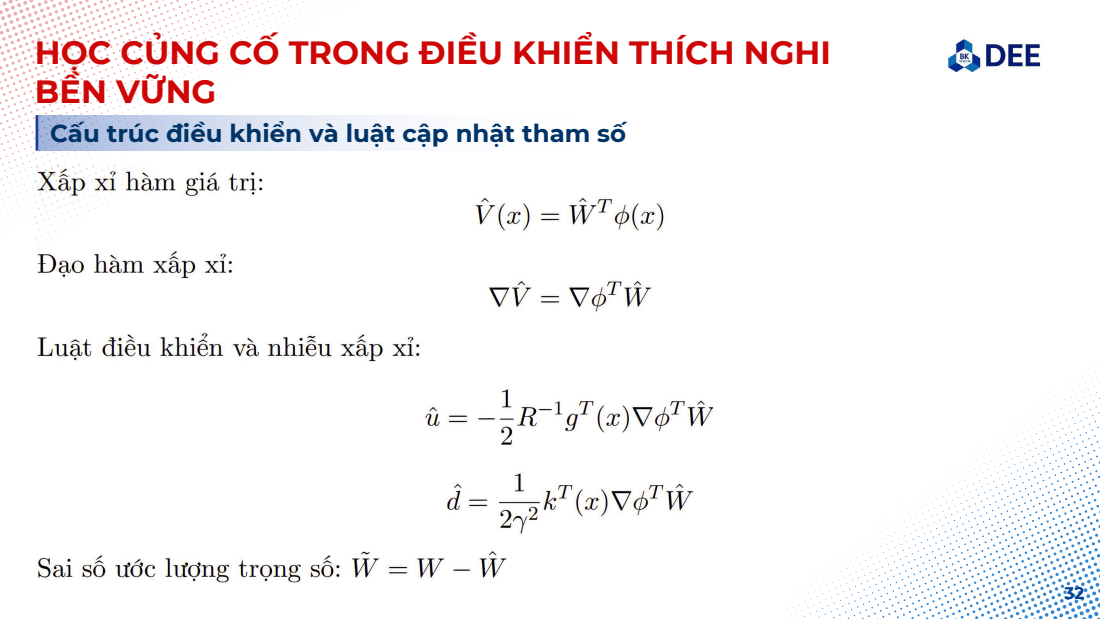
[picture p110: page 32]

Cấu trúc điều khiển và luật cập nhật tham số

## HỌC CỦNG CỐ TRONG ĐIỀU KHIỂN THÍCH NGHI BỀN VỮNG

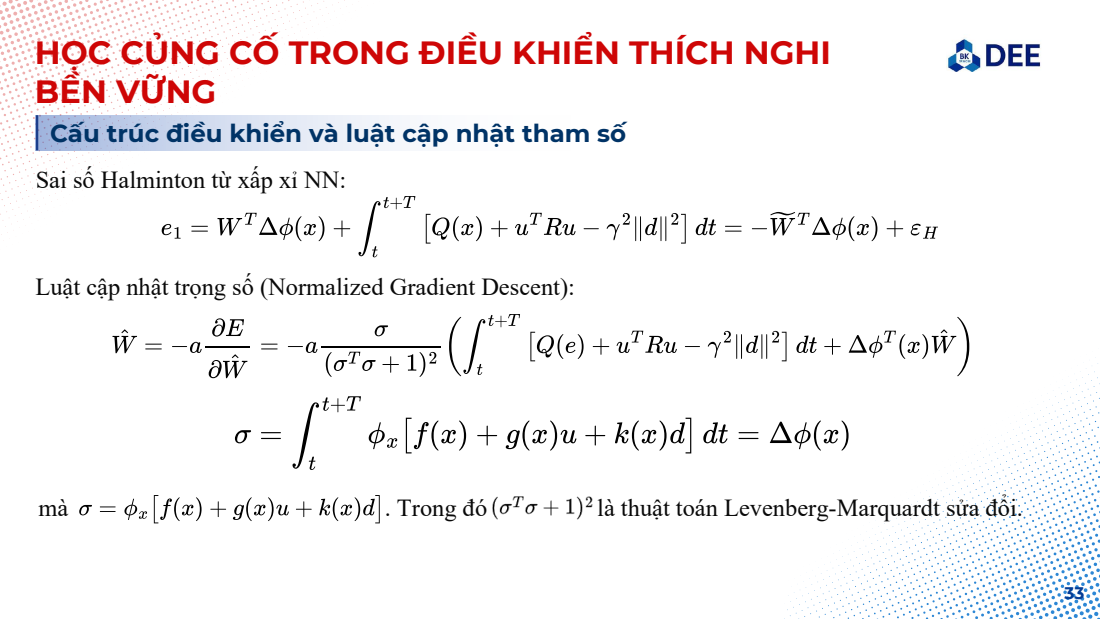
[picture p111: page 33]
. Trong đó; là thuật toán Levenberg-Marquardt sửa đổi.

Cấu trúc điều khiển và luật cập nhật tham số
Sai số Halminton từ xấp xỉ NN:

Luật cập nhật trọng số (Normalized Gradient Descent):

## HỌC CỦNG CỐ TRONG ĐIỀU KHIỂN THÍCH NGHI BỀN VỮNG

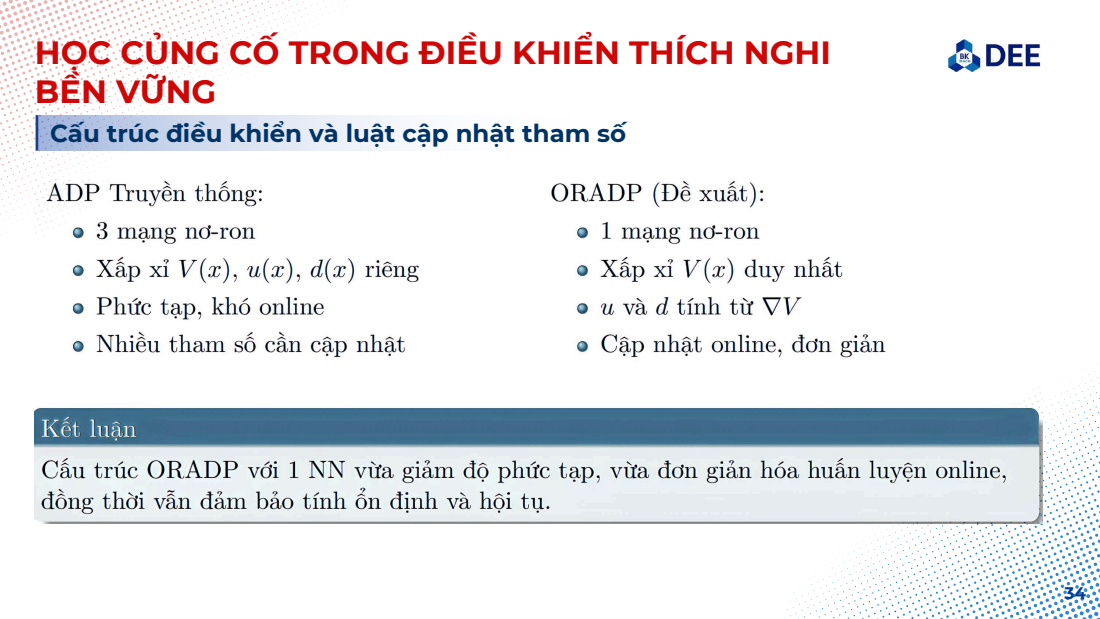
[picture p112: page 34]

Cấu trúc điều khiển và luật cập nhật tham số

## BỘ LỌC KALMAN MỞ RỘNG (EKF)

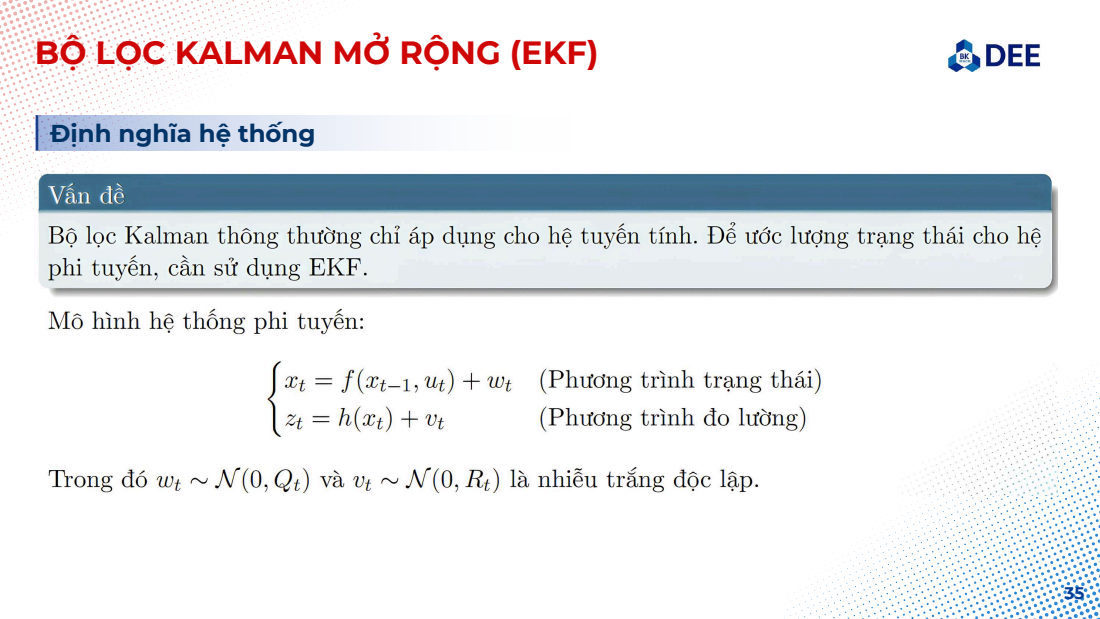
[picture p113: page 35]

Định nghĩa hệ thống

## BỘ LỌC KALMAN MỞ RỘNG (EKF)

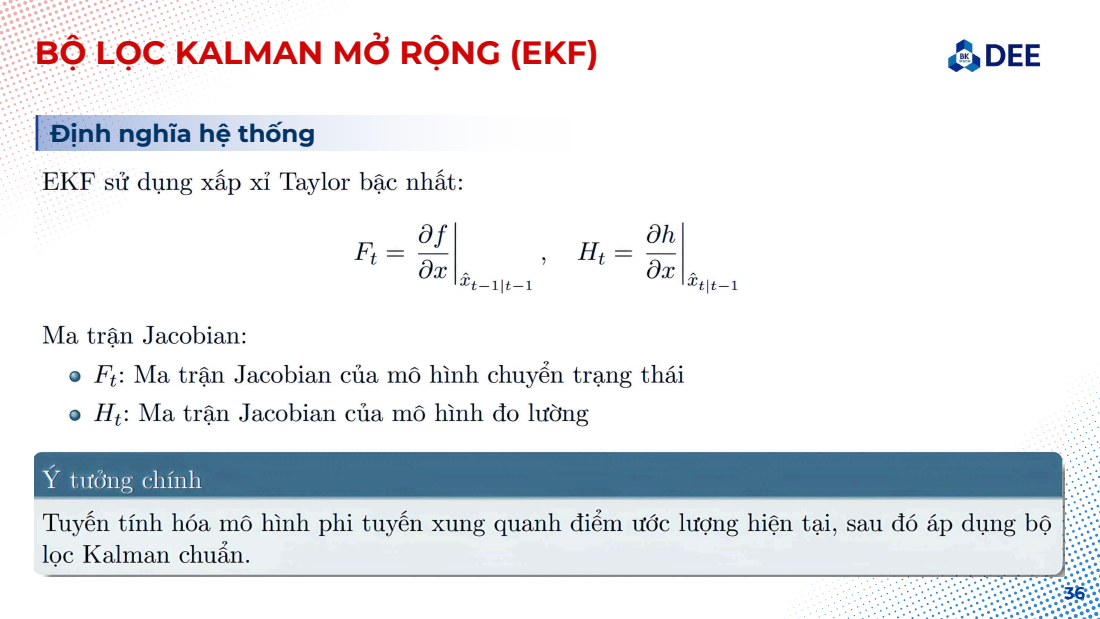
[picture p114: page 36]

Định nghĩa hệ thống

## BỘ LỌC KALMAN MỞ RỘNG (EKF)

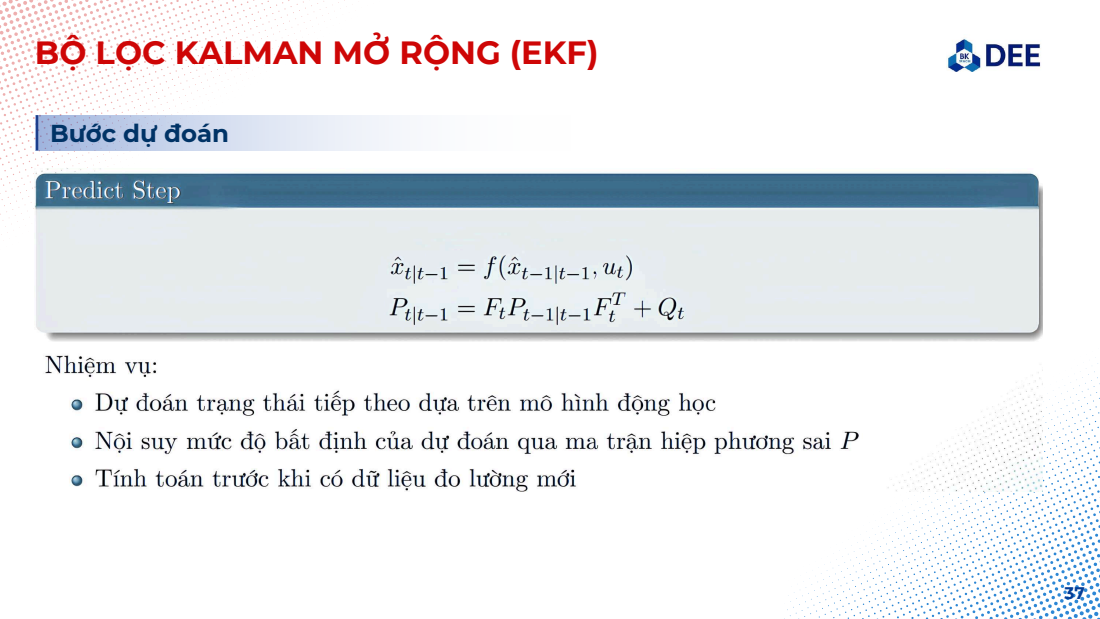
[picture p115: page 37]

Bước dự đoán

## BỘ LỌC KALMAN MỞ RỘNG (EKF)

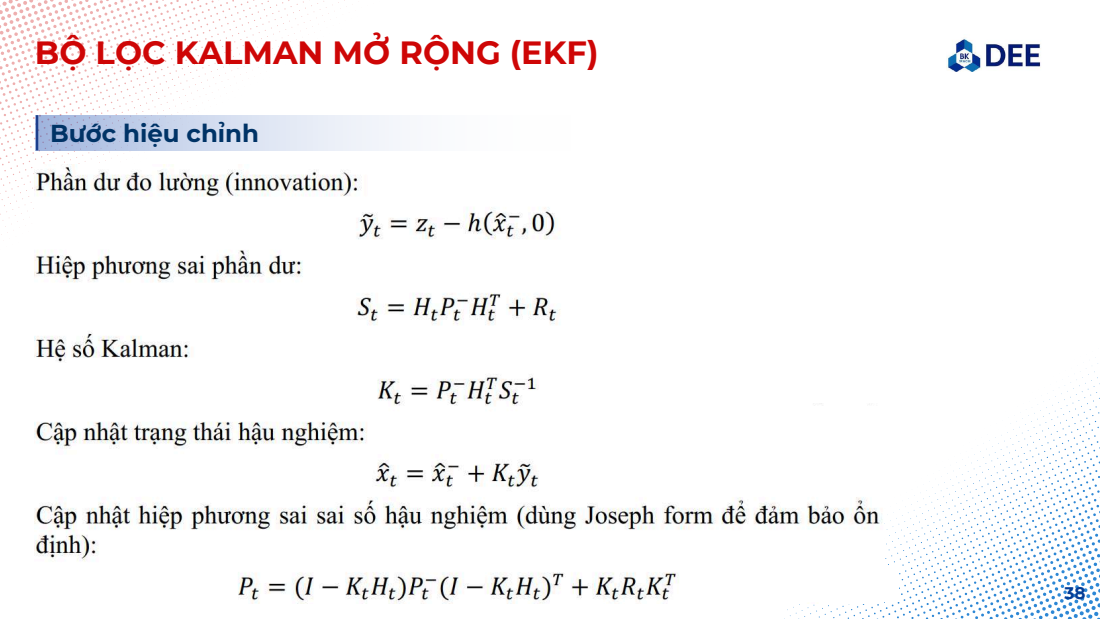
[picture p116: page 38]

Bước hiệu chỉnh

## THIẾT KẾ VÀ PHÂN TÍCH

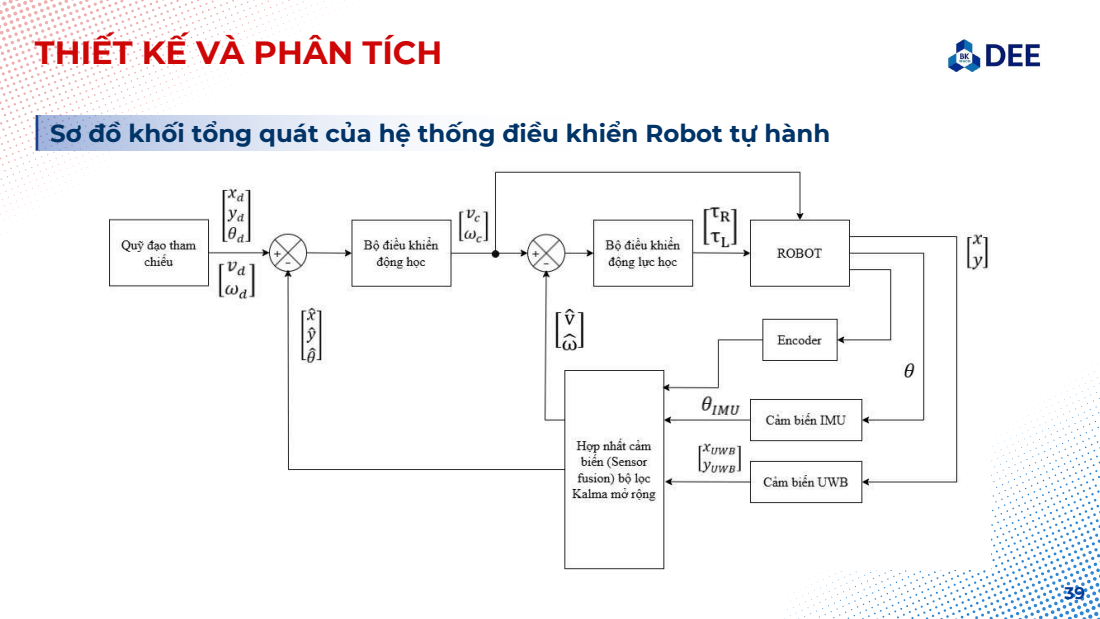
[picture p117: page 39]

Sơ đồ khối tổng quát của hệ thống điều khiển Robot tự hành

## THIẾT KẾ VÀ PHÂN TÍCH

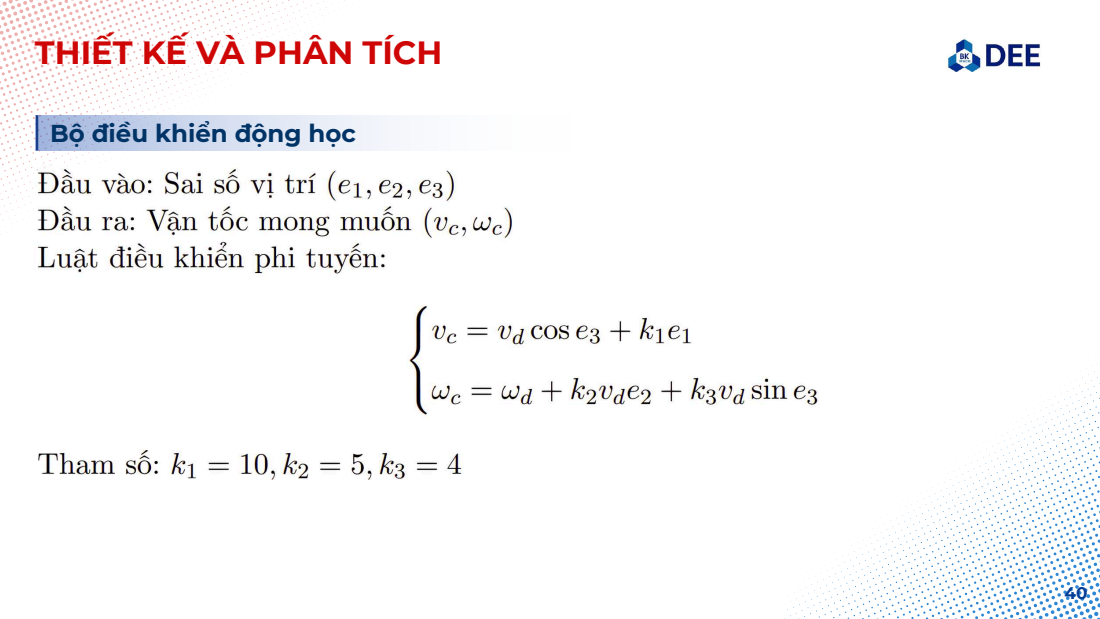
[picture p118: page 40]

Bộ điều khiển động học

## THIẾT KẾ VÀ PHÂN TÍCH

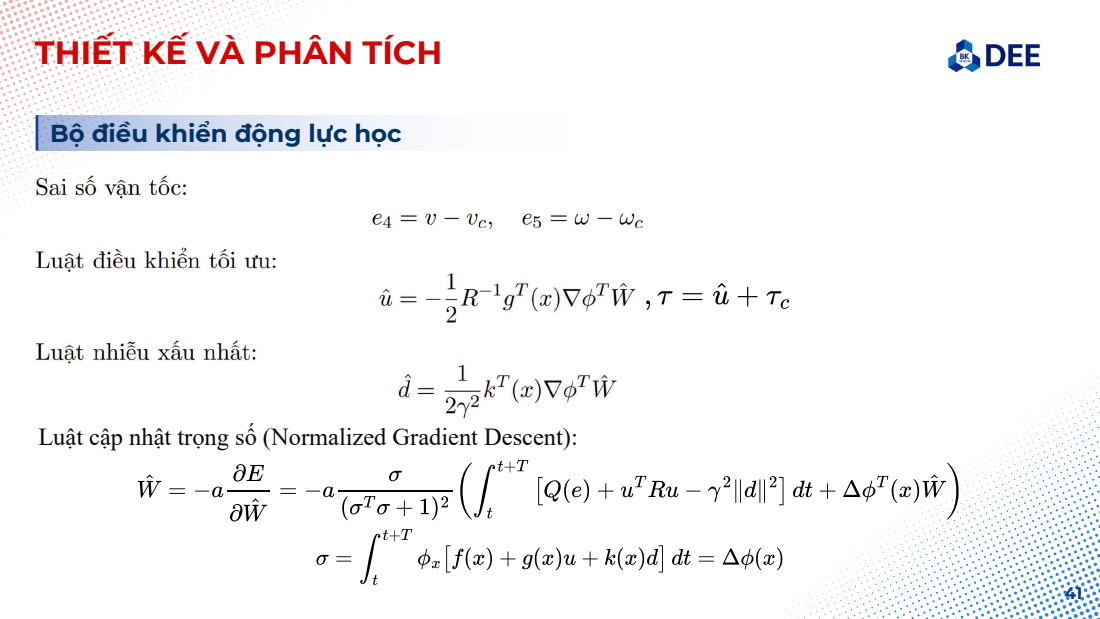
[picture p119: page 41]

Bộ điều khiển động lực học

Luật cập nhật trọng số (Normalized Gradient Descent):

## THIẾT KẾ VÀ PHÂN TÍCH

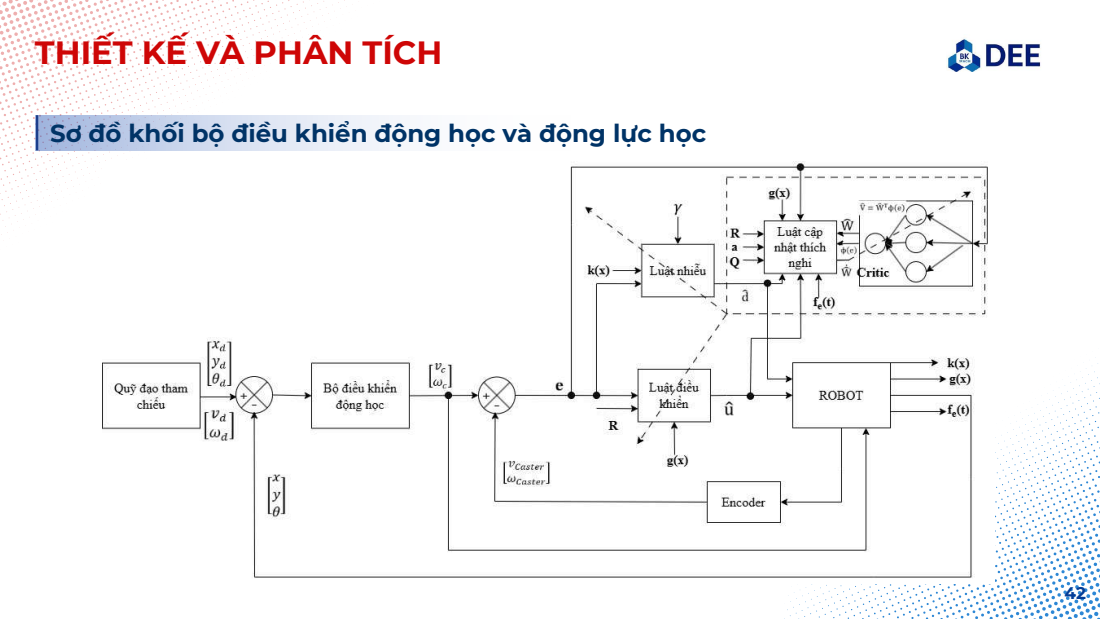
[picture p120: page 42]

Sơ đồ khối bộ điều khiển động học và động lực học

## THIẾT KẾ VÀ PHÂN TÍCH

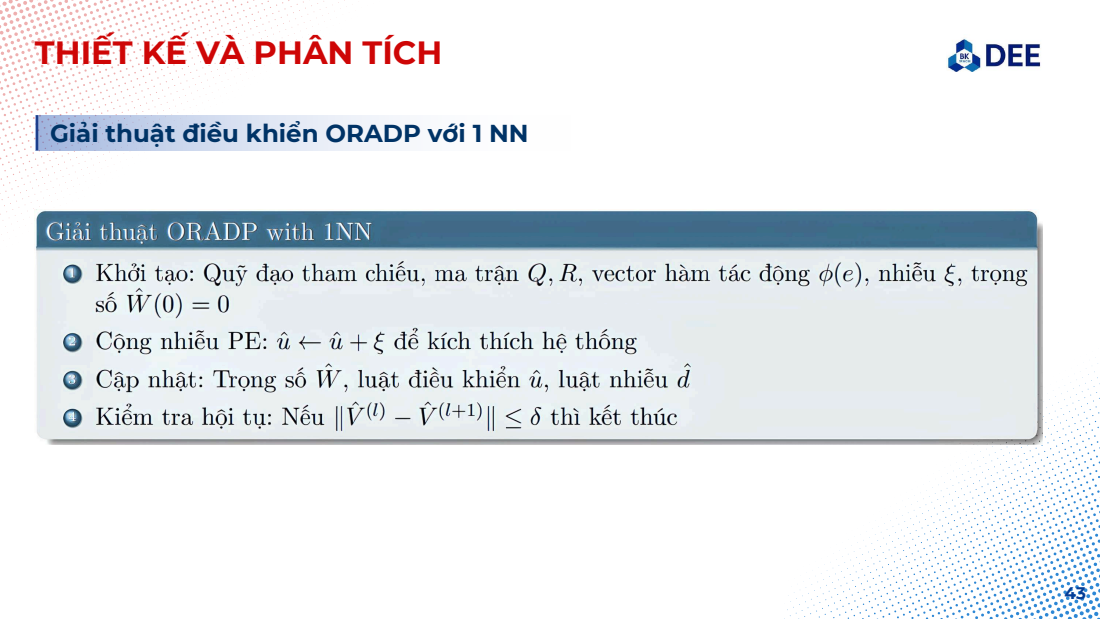
[picture p121: page 43]

Giải thuật điều khiển ORADP với 1 NN

## THIẾT KẾ VÀ PHÂN TÍCH

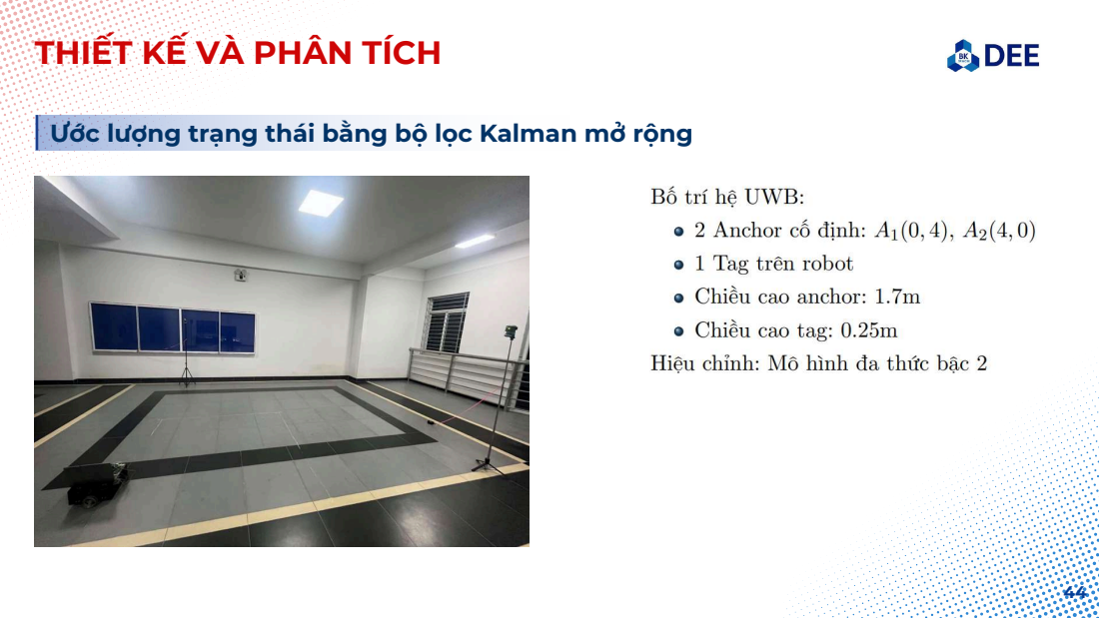
[picture p122: page 44]

Ước lượng trạng thái bằng bộ lọc Kalman mở rộng

## THIẾT KẾ VÀ PHÂN TÍCH

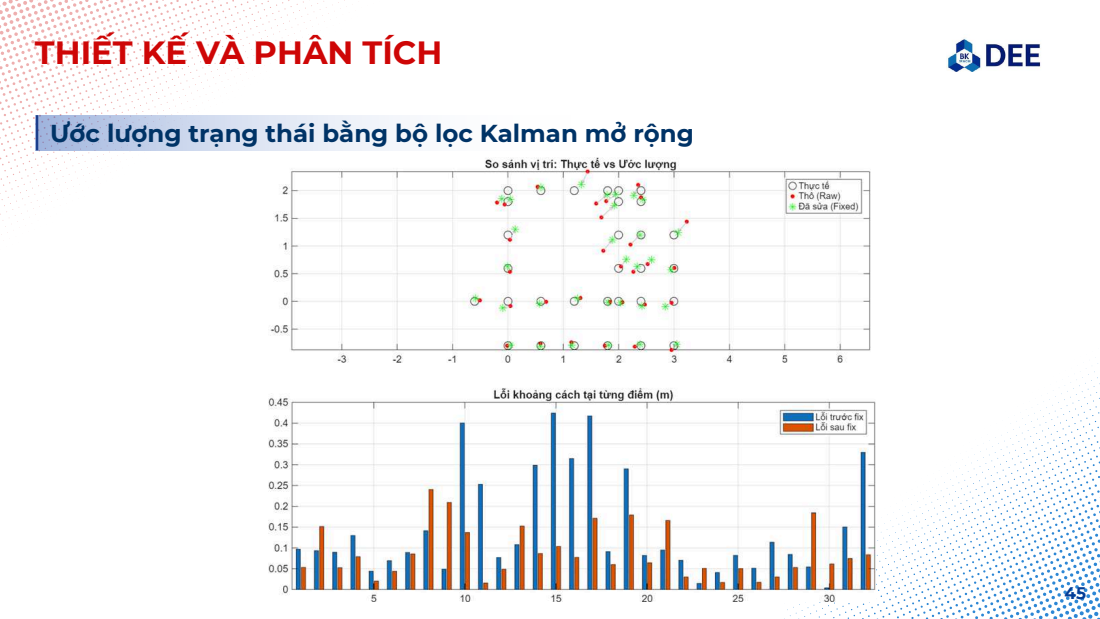
[picture p123: page 45]

Ước lượng trạng thái bằng bộ lọc Kalman mở rộng

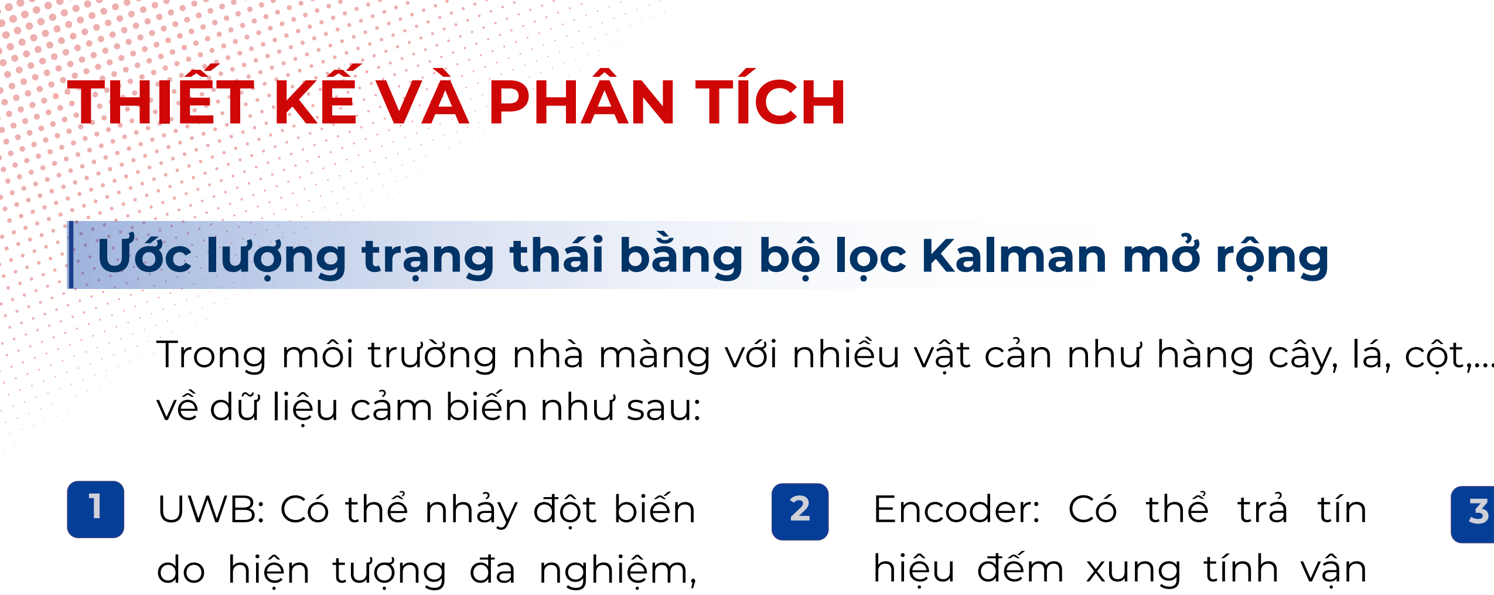
[picture p124: figure]
THIẾT KẾ VÀ PHÂN TÍCH; Encoder: Có thể trả tín hiệu đếm xung tính vận; UWB: Có thể nhảy đột biến; do hiện tượng đa nghiệm,; về dữ liệu cảm biến như sau:

Ước lượng trạng thái bằng bộ lọc Kalman mở rộng

46

tốc sai khi bánh xe trượt
trên bề mặt nhà màng
(bề mặt bạt phủ trên đất
ẩm, lá rụng, dễ trơn sau
khi mưa).

che khuất bởi các vật cản
gây nhiễu, mất tín hiệu tạm thời.

Trong môi trường nhà màng với nhiều vật cản như hàng cây, lá, cột,…điều này gây ra các vấn đề

Cảm biến vận tốc góc:
Có thể nhảy (vọt lố) do
phần cứng, va chạm hay
do rung động cơ học
trong quá trình di
chuyển.

## THIẾT KẾ VÀ PHÂN TÍCH

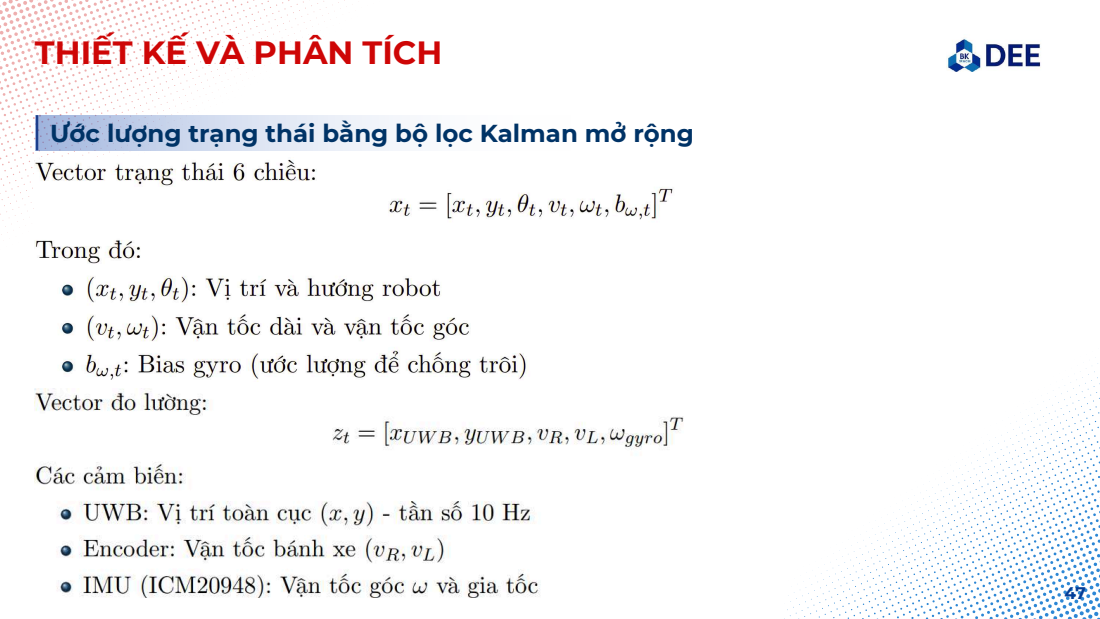
[picture p125: page 47]

Ước lượng trạng thái bằng bộ lọc Kalman mở rộng

## BỘ LỌC KALMAN MỞ RỘNG (EKF)

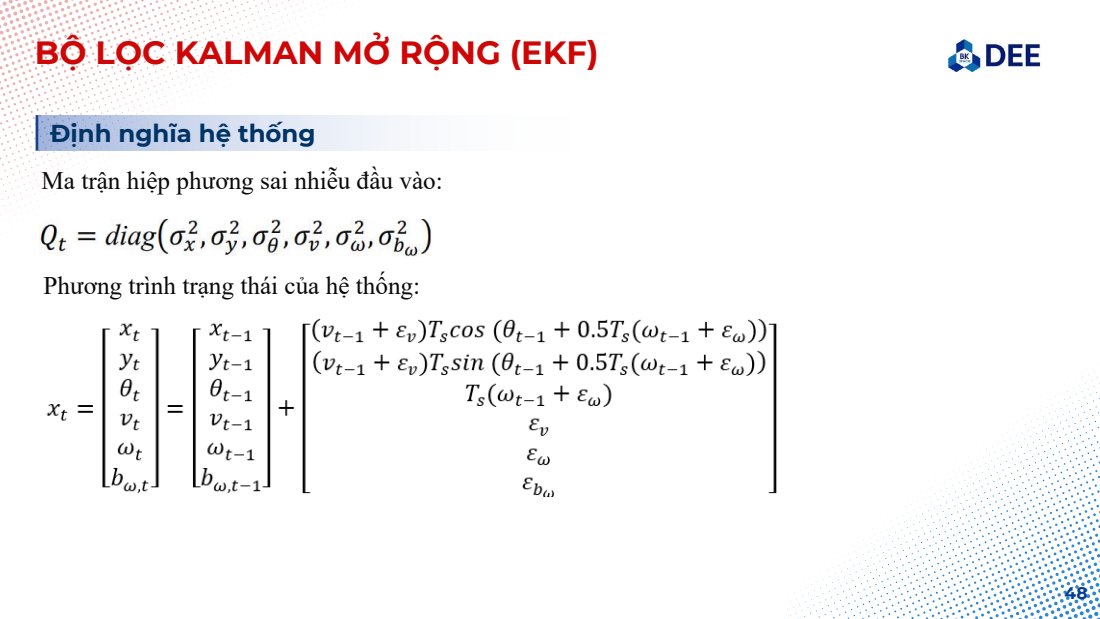
[picture p126: page 48]

Định nghĩa hệ thống
Ma trận hiệp phương sai nhiễu đầu vào:

Phương trình trạng thái của hệ thống:

## BỘ LỌC KALMAN MỞ RỘNG (EKF)

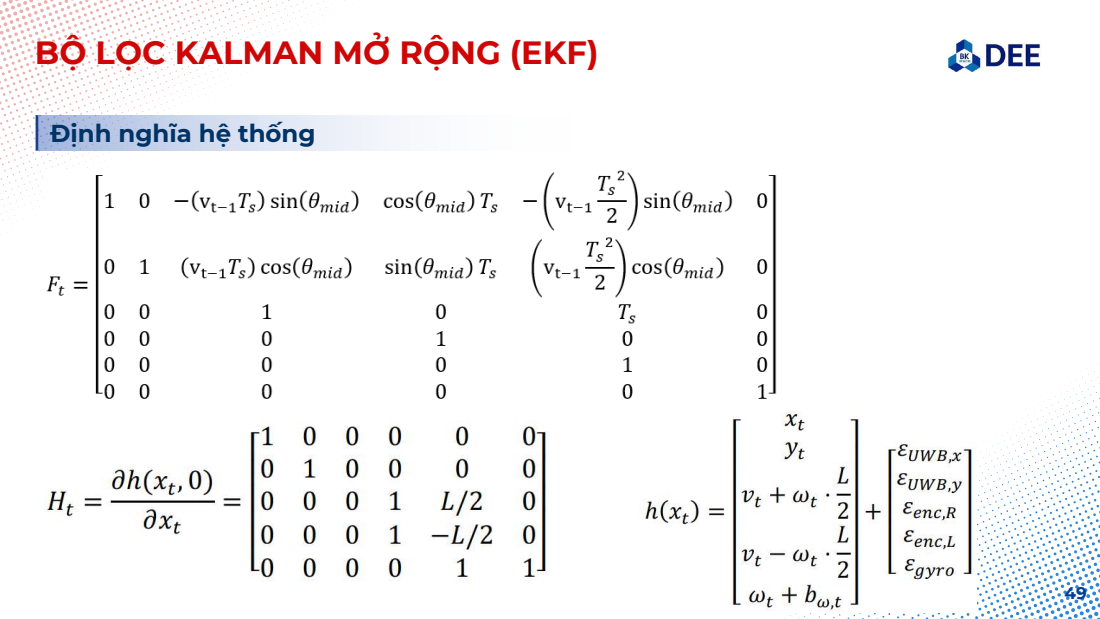
[picture p127: page 49]

Định nghĩa hệ thống

## BỘ LỌC KALMAN MỞ RỘNG (EKF)

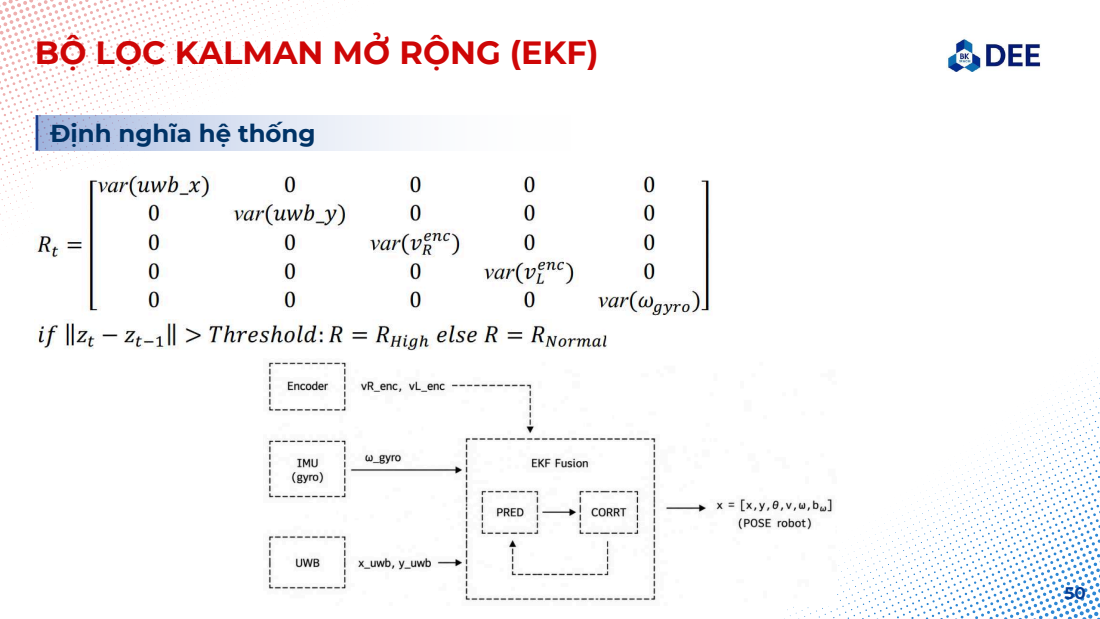
[picture p128: page 50]

Định nghĩa hệ thống

## PHÂN TÍCH VÀ THIẾT KẾ

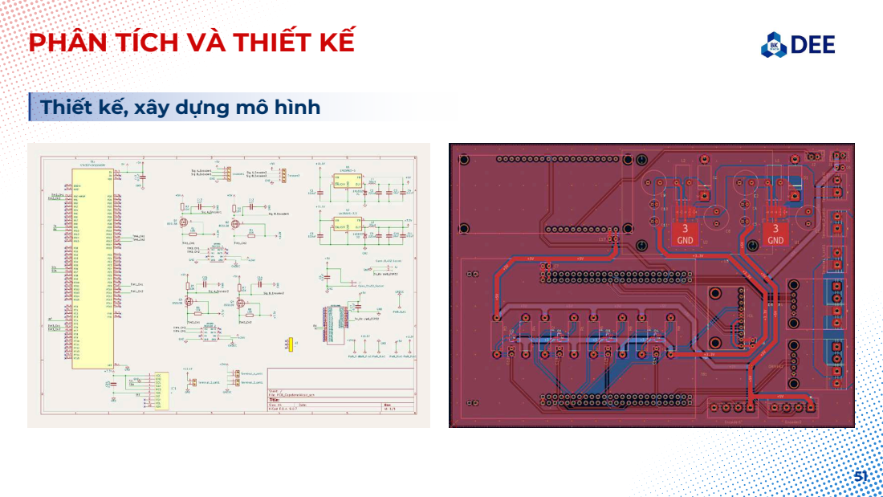
[picture p129: page 51]

Thiết kế, xây dựng mô hình

## PHÂN TÍCH VÀ THIẾT KẾ

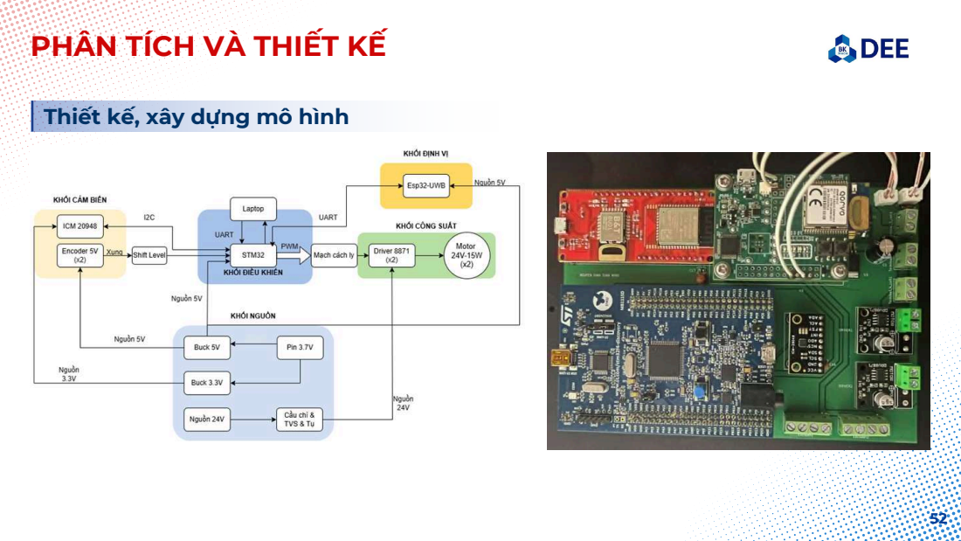
[picture p130: page 52]

Thiết kế, xây dựng mô hình

## PHÂN TÍCH VÀ THIẾT KẾ

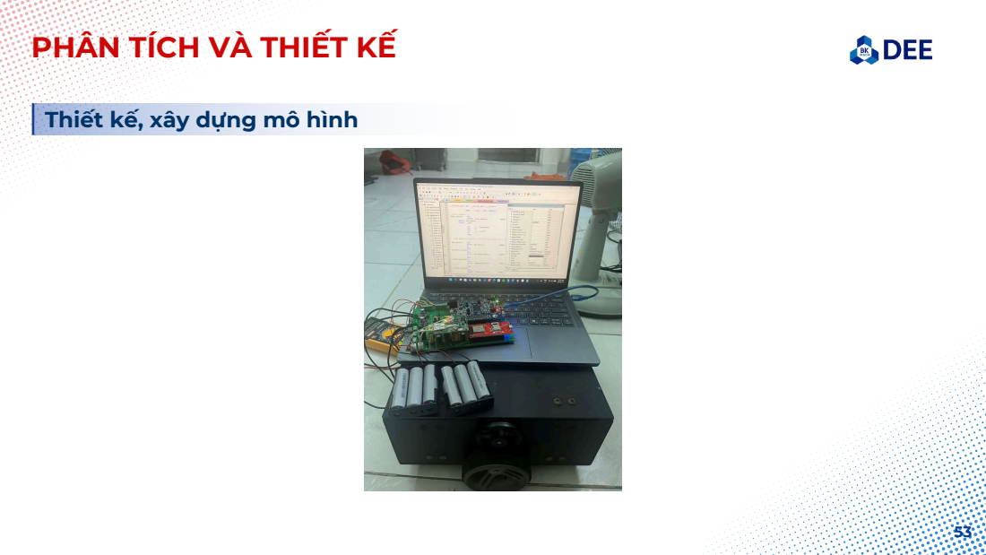
[picture p131: page 53]

Thiết kế, xây dựng mô hình

## PHÂN TÍCH VÀ THIẾT KẾ

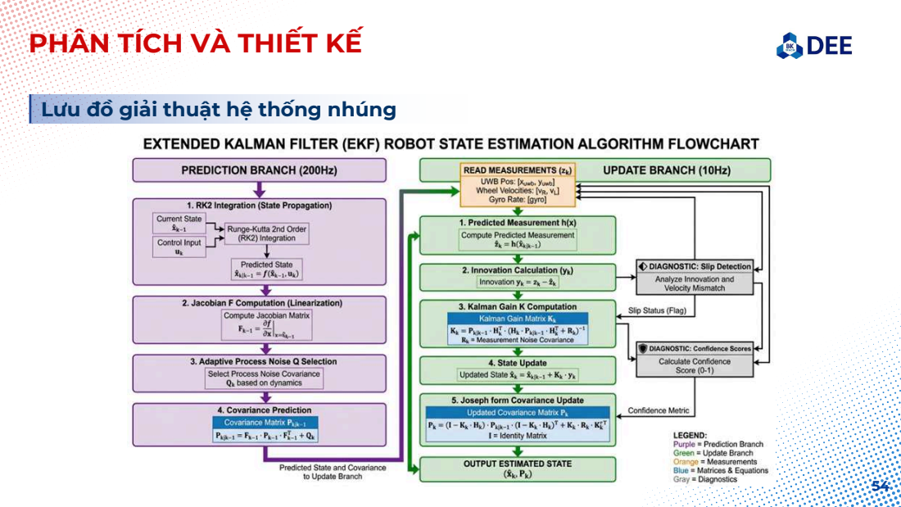
[picture p132: page 54]

Lưu đồ giải thuật hệ thống nhúng

## PHÂN TÍCH VÀ THIẾT KẾ

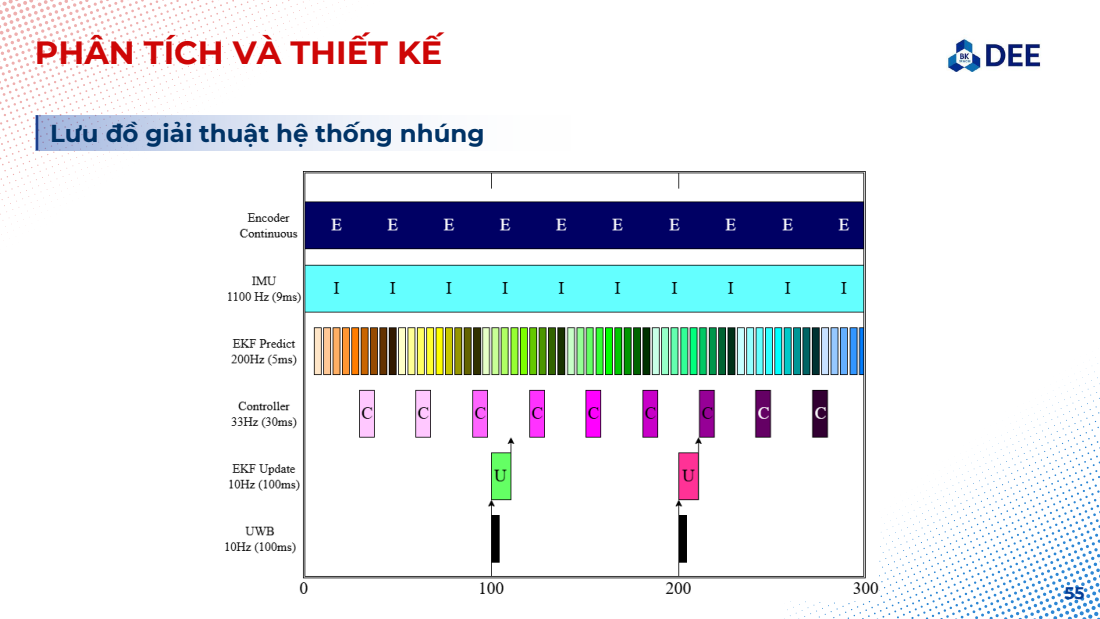
[picture p133: page 55]

Lưu đồ giải thuật hệ thống nhúng

## PHÂN TÍCH VÀ THIẾT KẾ

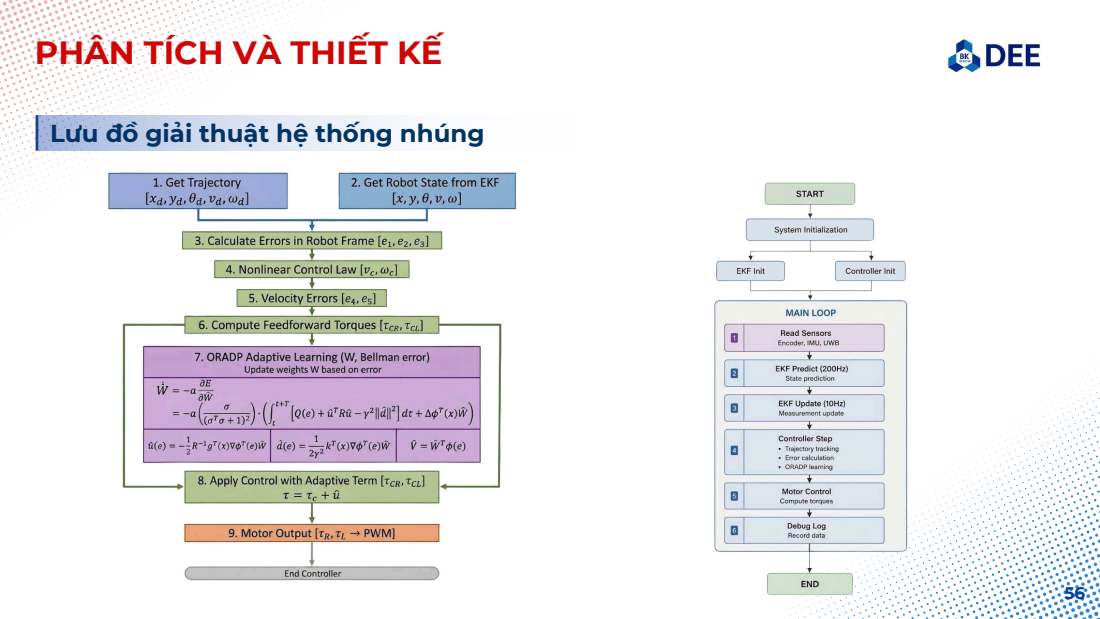
[picture p134: page 56]

Lưu đồ giải thuật hệ thống nhúng

## KẾT QUẢ THỰC HIỆN

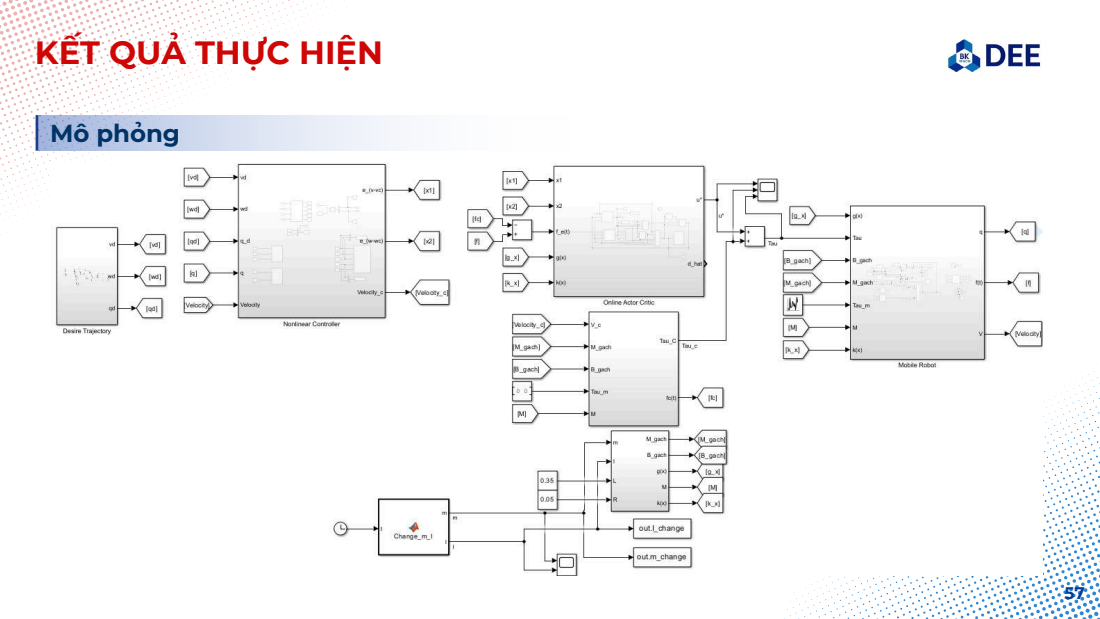
[picture p135: page 57]
Mô phỏng

## KẾT QUẢ THỰC HIỆN

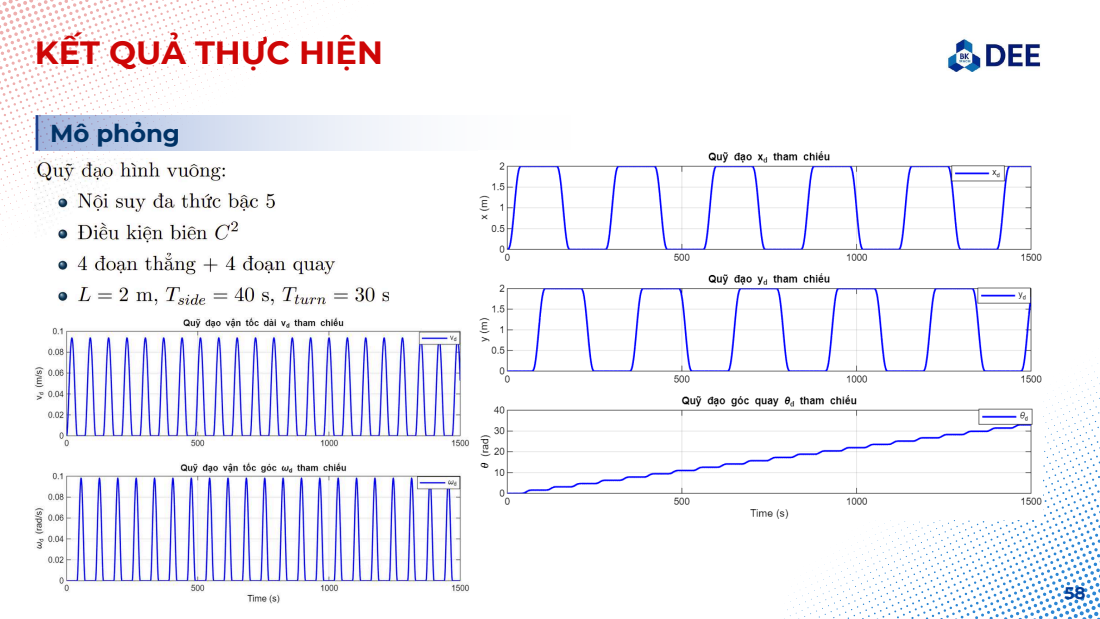
[picture p136: page 58]
Mô phỏng

## KẾT QUẢ THỰC HIỆN

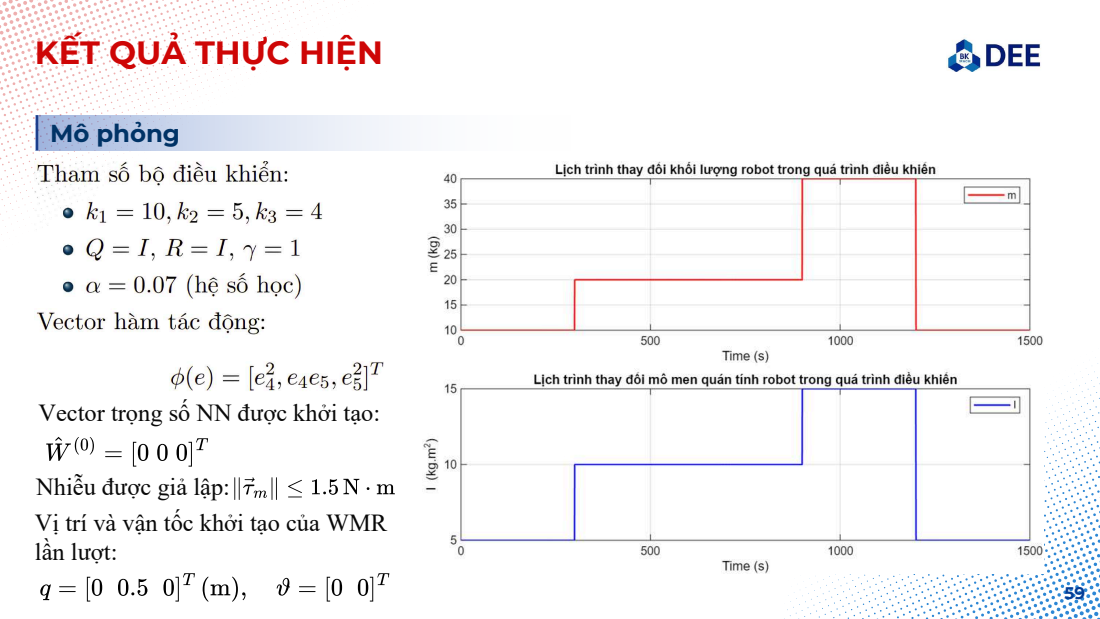
[picture p137: page 59]
Mô phỏng

Vector trọng số NN được khởi tạo:

Nhiễu được giả lập:
Vị trí và vận tốc khởi tạo của WMR
lần lượt:

## KẾT QUẢ THỰC HIỆN

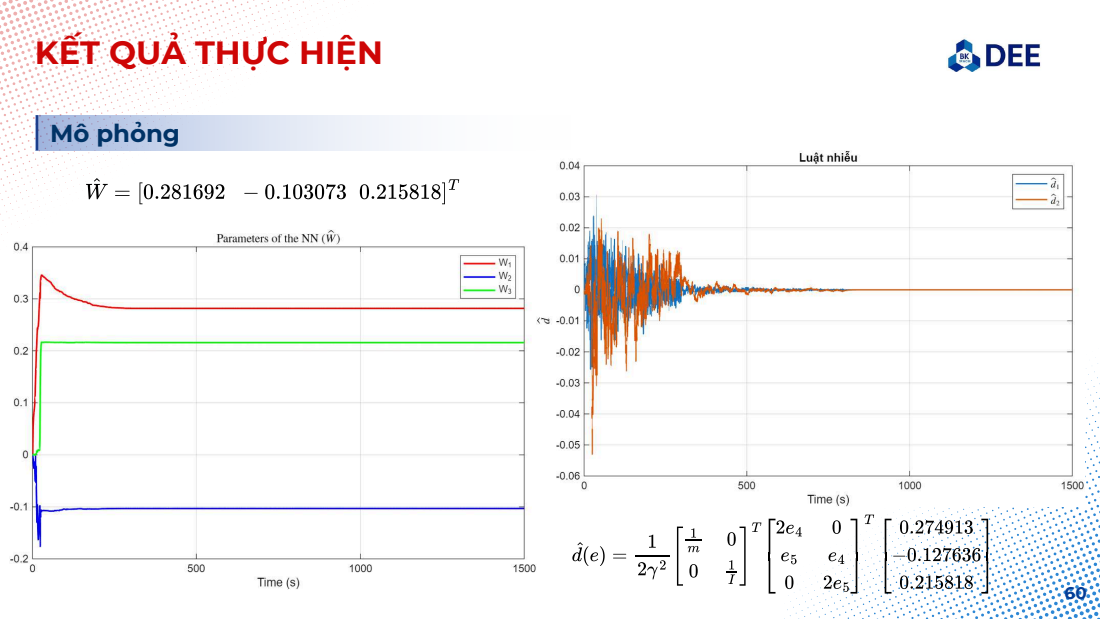
[picture p138: page 60]
Mô phỏng

## KẾT QUẢ THỰC HIỆN

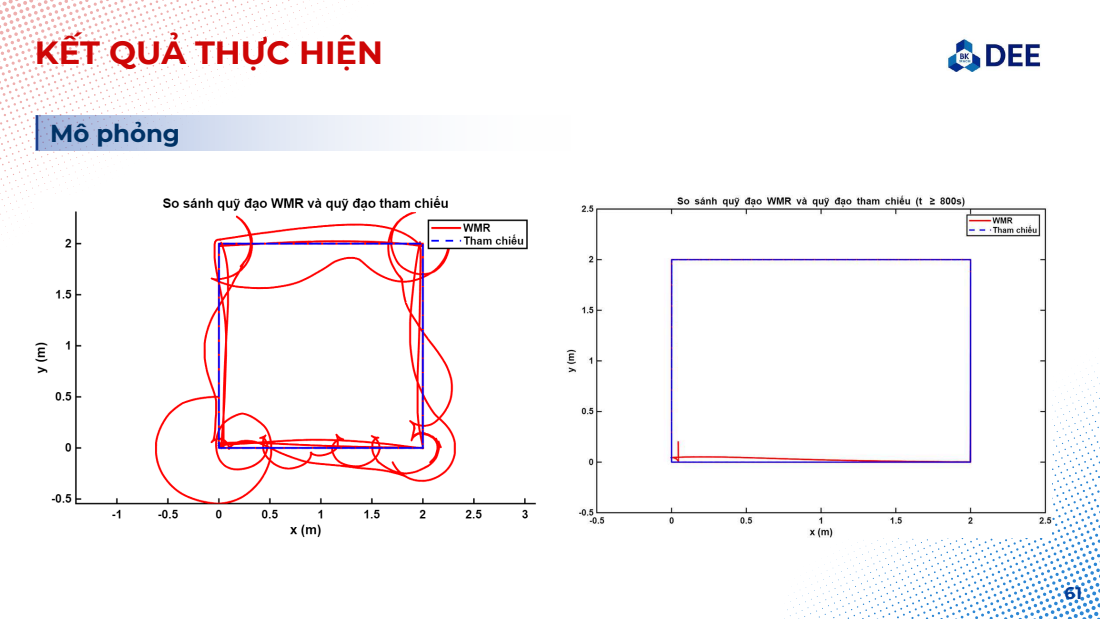
[picture p139: page 61]
Mô phỏng

## KẾT QUẢ THỰC HIỆN

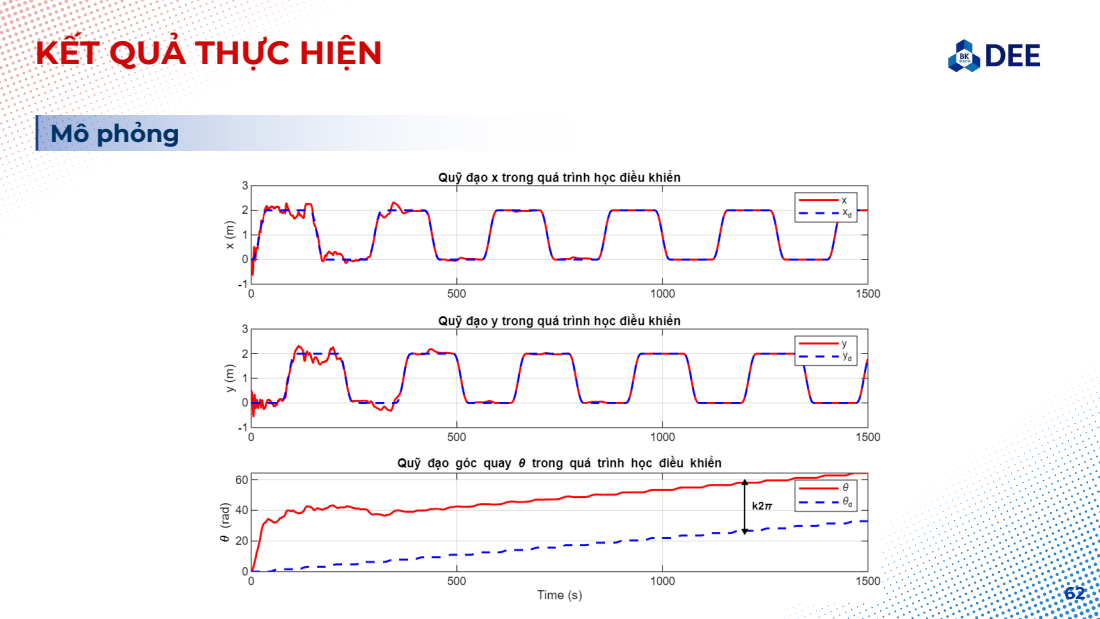
[picture p140: page 62]
Mô phỏng

## KẾT QUẢ THỰC HIỆN

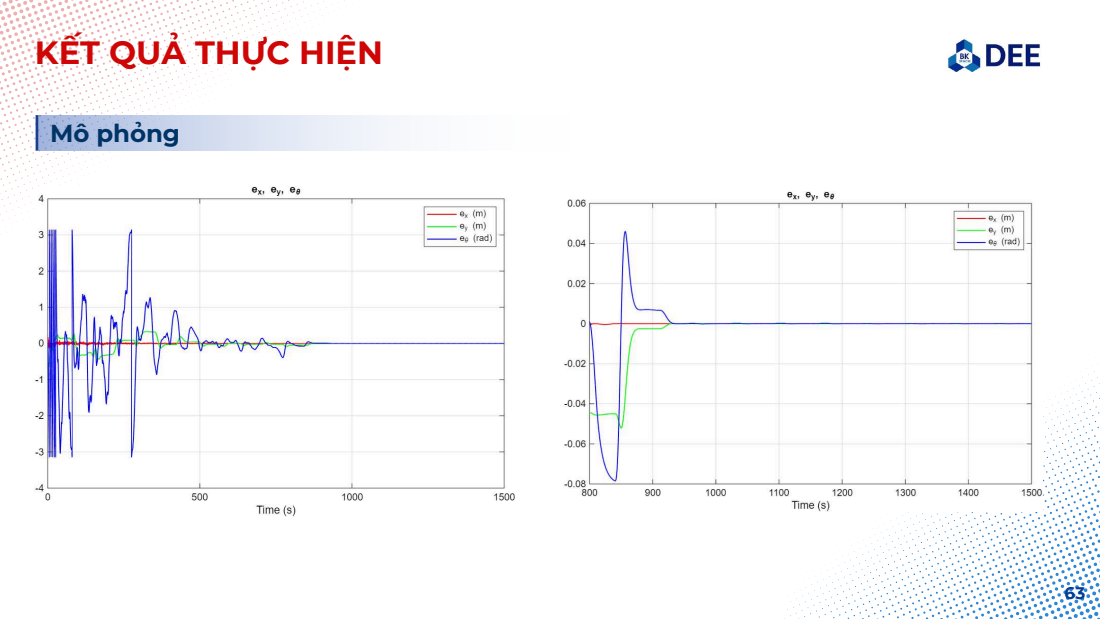
[picture p141: page 63]
Mô phỏng

## KẾT QUẢ THỰC HIỆN

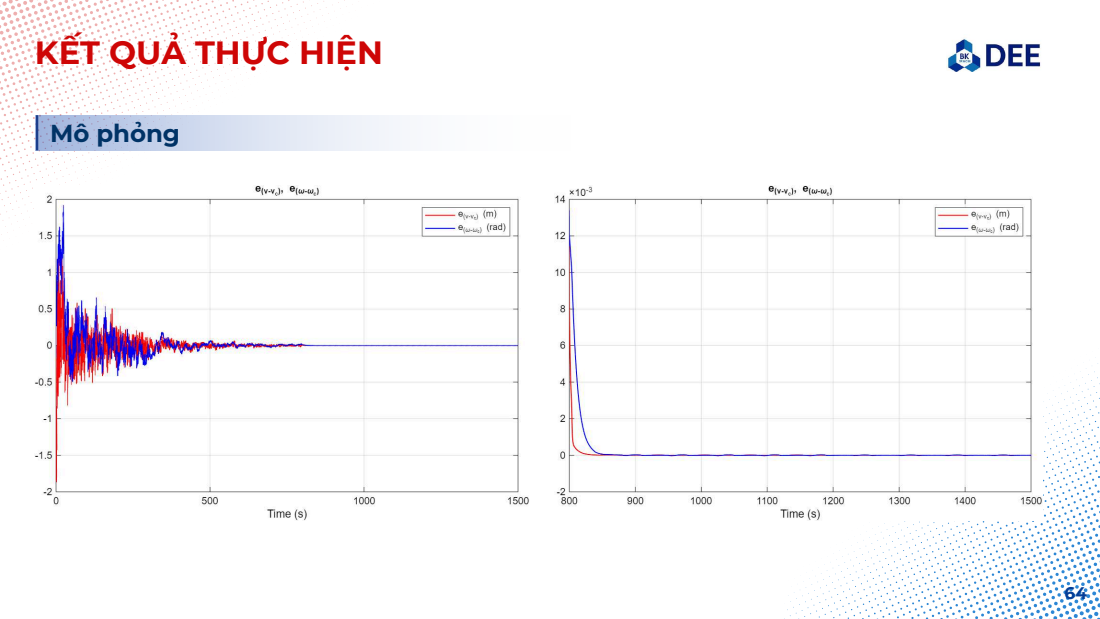
[picture p142: page 64]
Mô phỏng

## KẾT QUẢ THỰC HIỆN

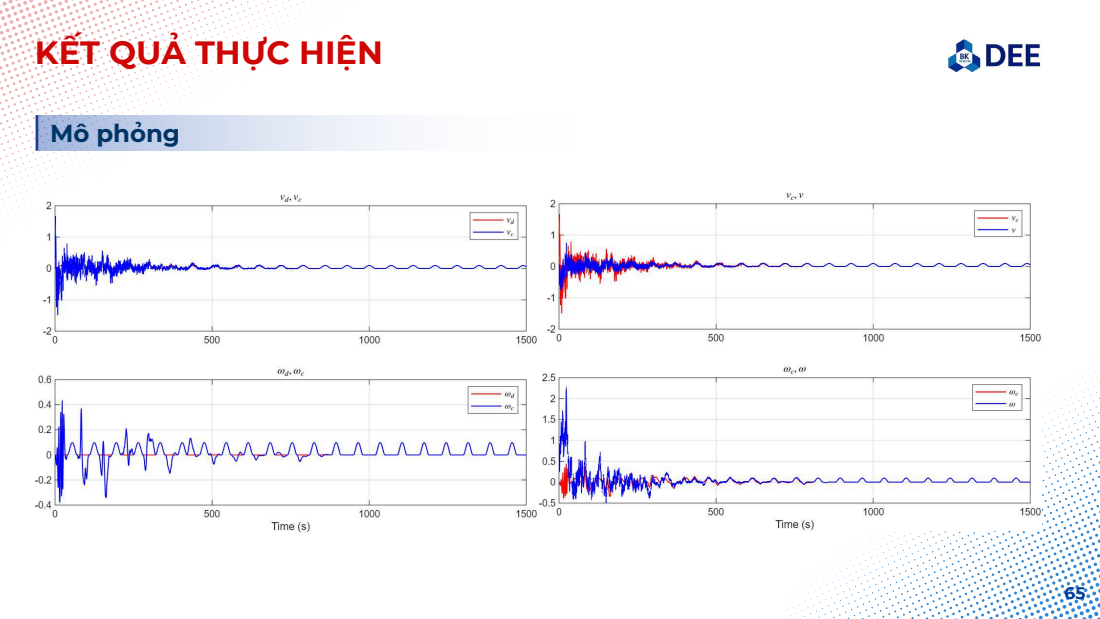
[picture p143: page 65]
Mô phỏng

## KẾT QUẢ THỰC HIỆN

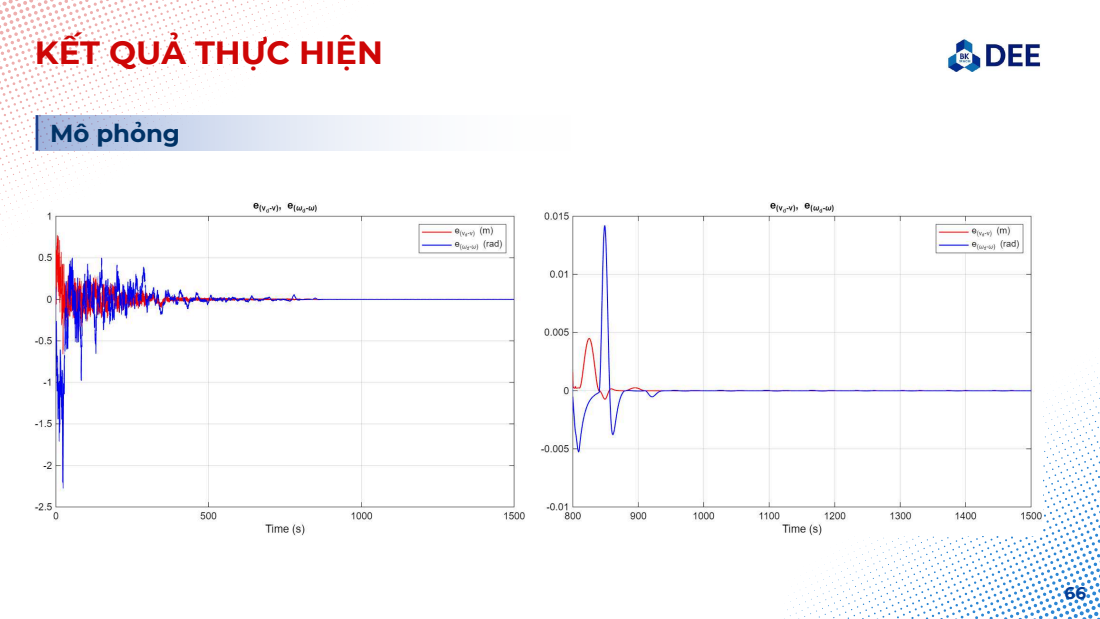
[picture p144: page 66]
Mô phỏng

## KẾT QUẢ THỰC HIỆN

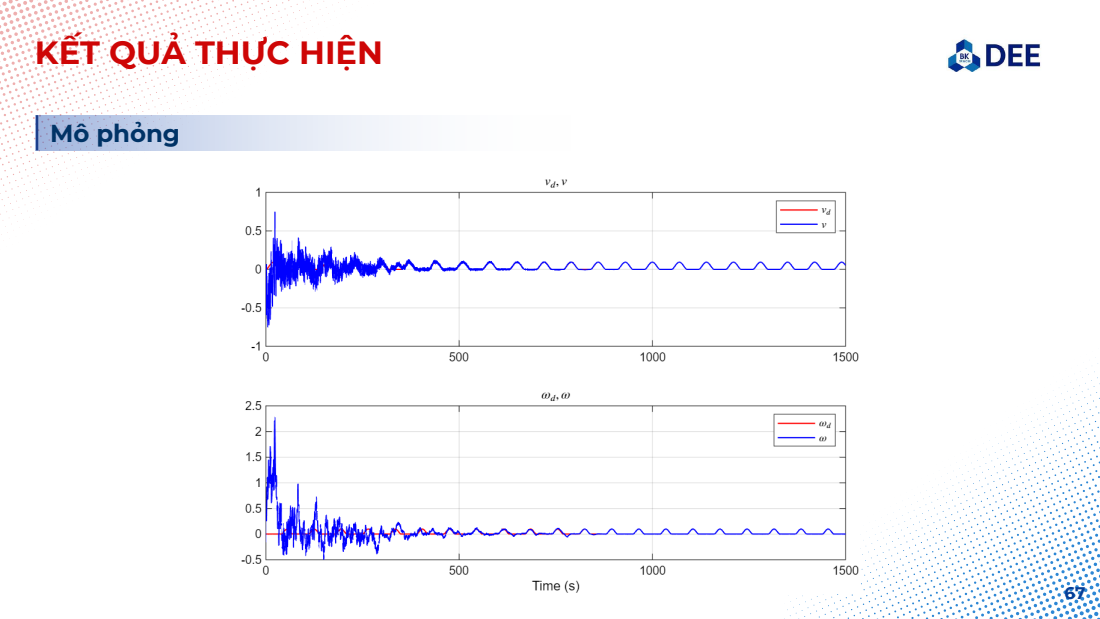
[picture p145: page 67]
Mô phỏng

## KẾT QUẢ THỰC HIỆN

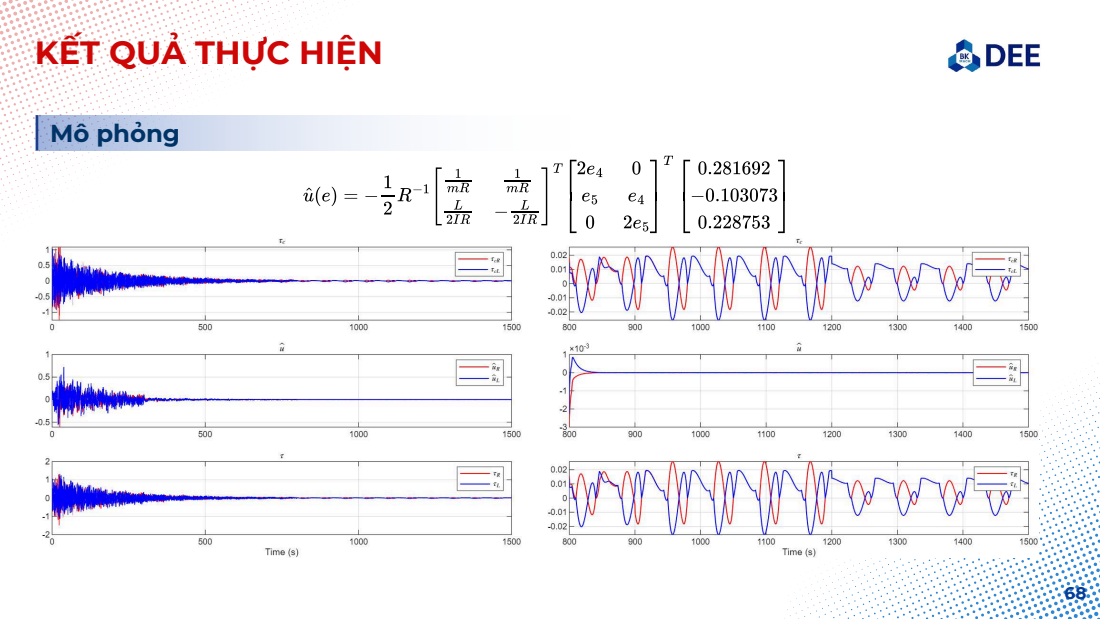
[picture p146: page 68]
Mô phỏng

## KẾT QUẢ THỰC HIỆN

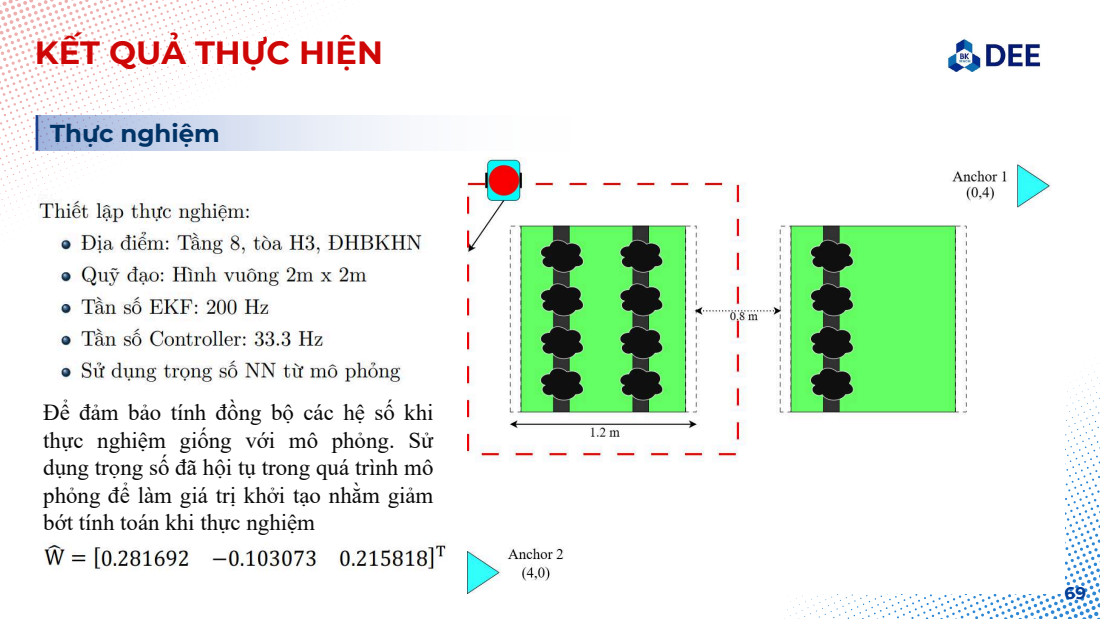
[picture p147: page 69]
Thực nghiệm

Để đảm bảo tính đồng bộ các hệ số khi
thực nghiệm giống với mô phỏng. Sử
dụng trọng số đã hội tụ trong quá trình mô
phỏng để làm giá trị khởi tạo nhằm giảm
bớt tính toán khi thực nghiệm

## KẾT QUẢ THỰC HIỆN

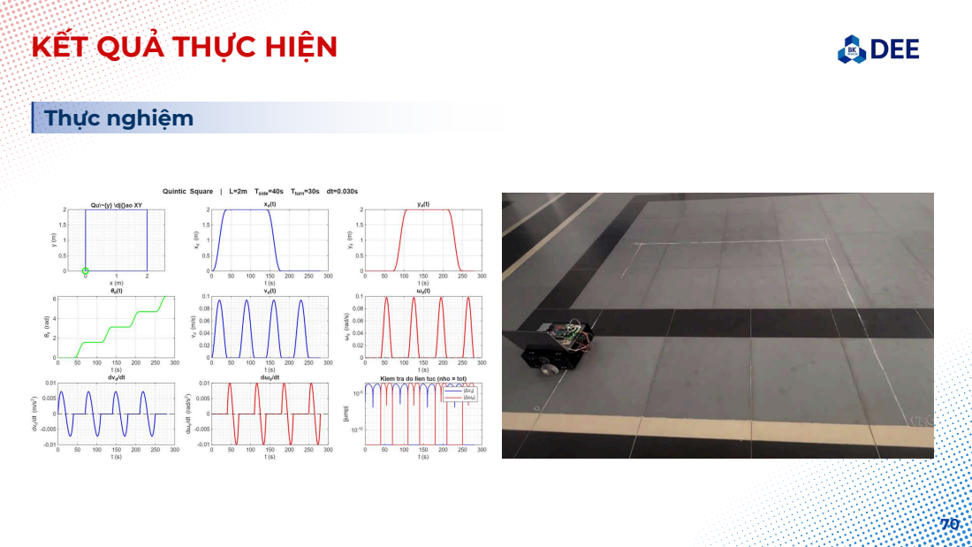
[picture p148: page 70]
Thực nghiệm

## KẾT QUẢ THỰC HIỆN

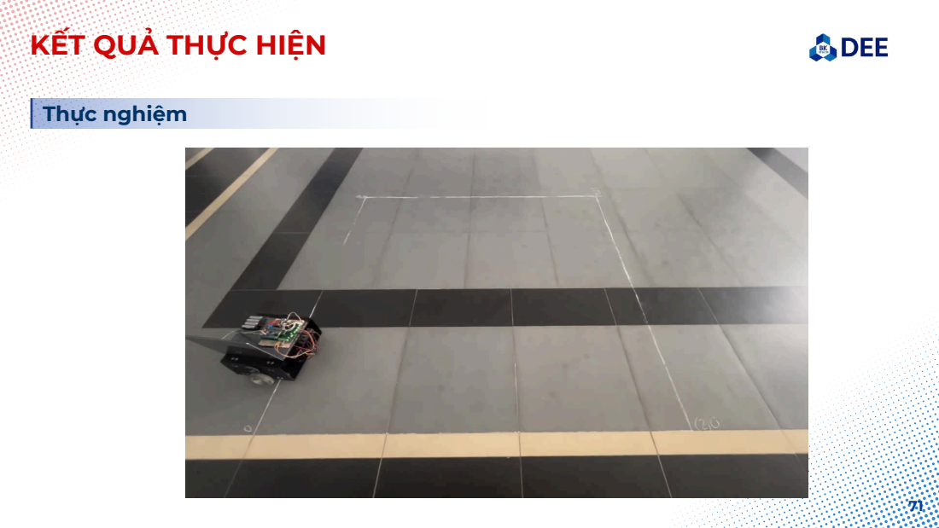
[picture p149: page 71]
Thực nghiệm

## KẾT QUẢ THỰC HIỆN

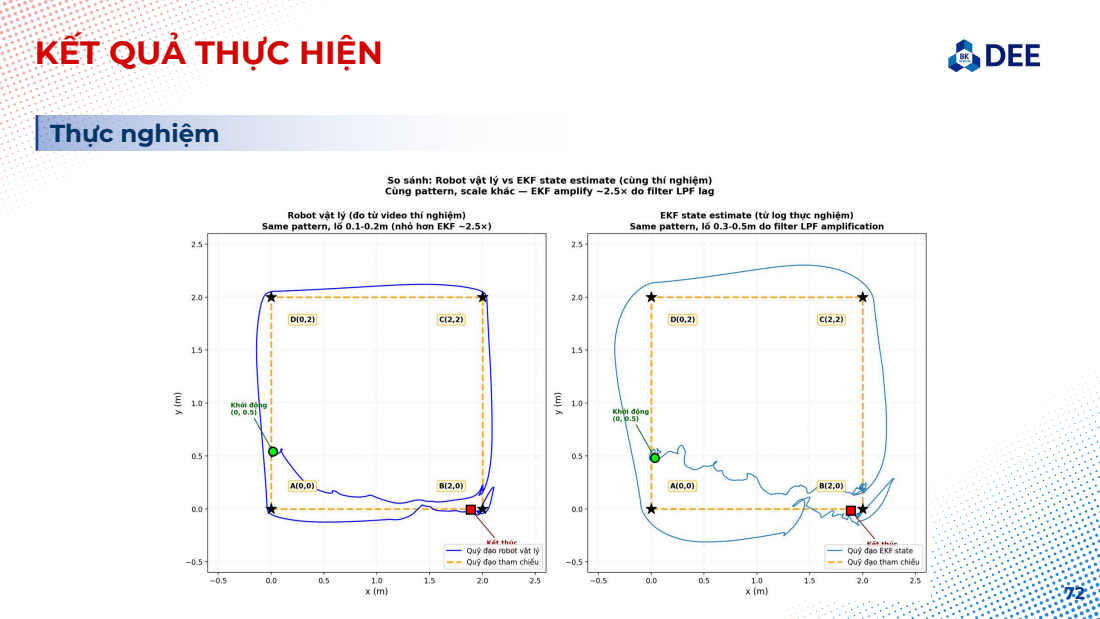
[picture p150: page 72]
Thực nghiệm

## KẾT QUẢ THỰC HIỆN

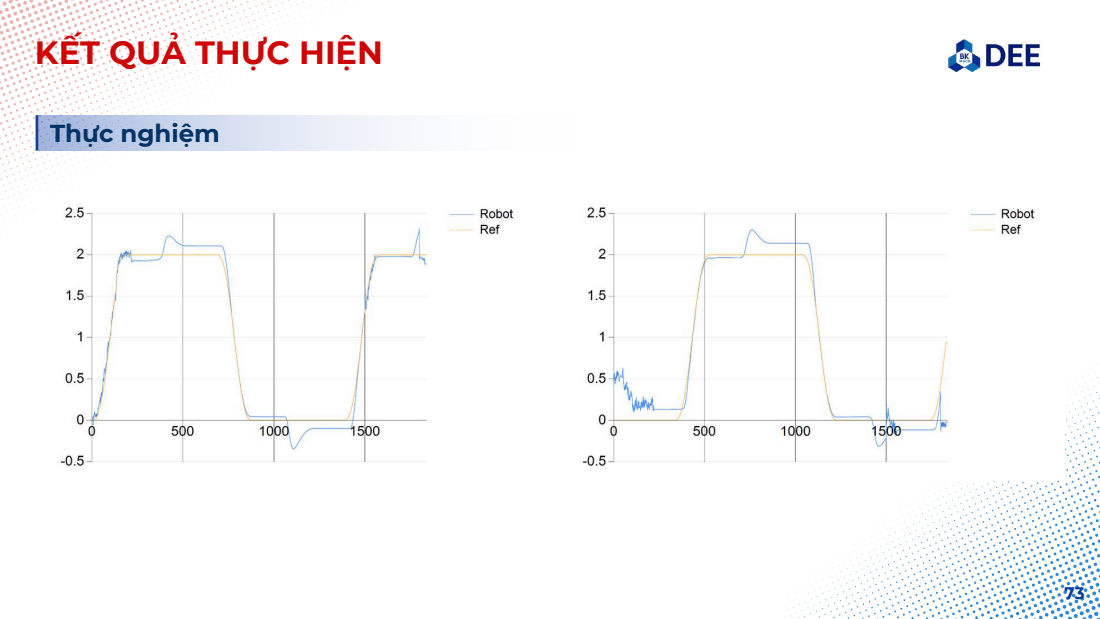
[picture p151: page 73]
Thực nghiệm

## KẾT QUẢ THỰC HIỆN

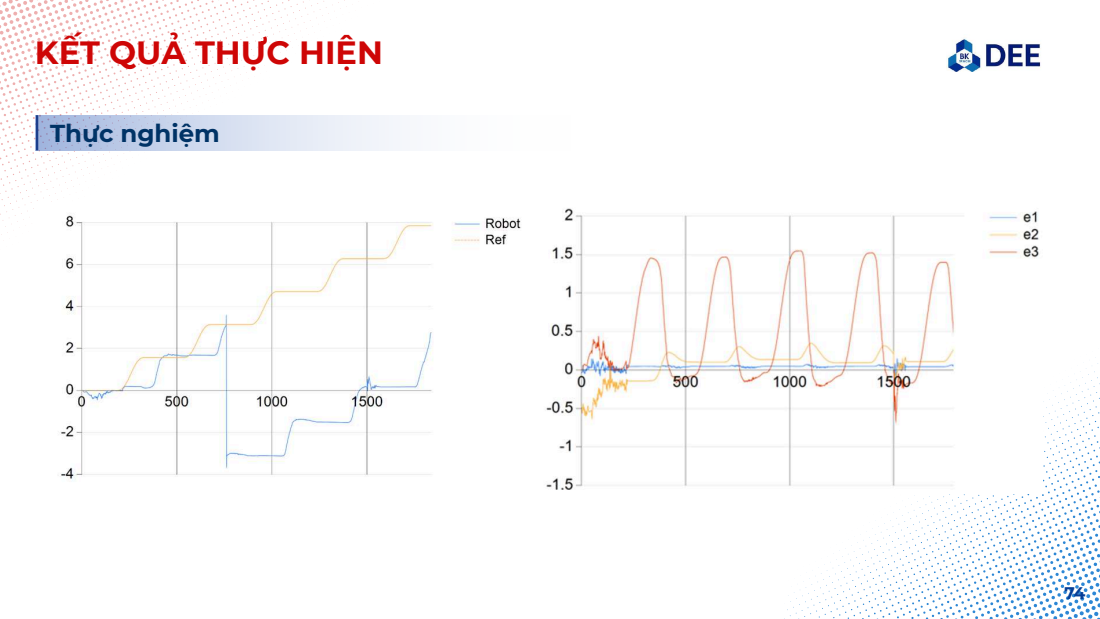
[picture p152: page 74]
Thực nghiệm

## KẾT QUẢ THỰC HIỆN

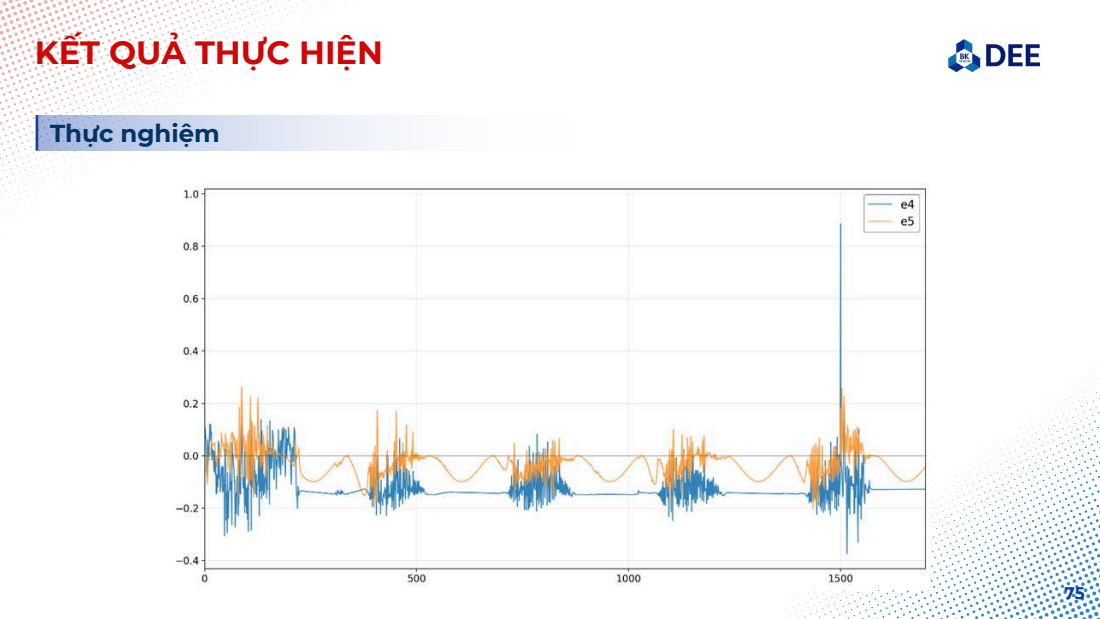
[picture p153: page 75]
Thực nghiệm

## KẾT QUẢ THỰC HIỆN

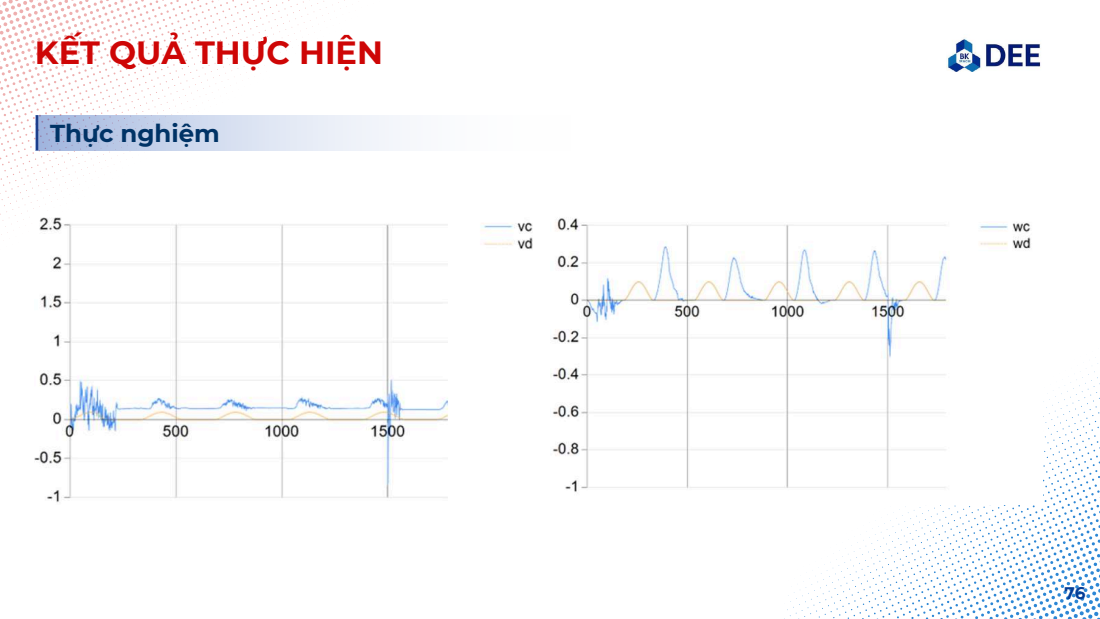
[picture p154: page 76]
Thực nghiệm

## KẾT QUẢ THỰC HIỆN

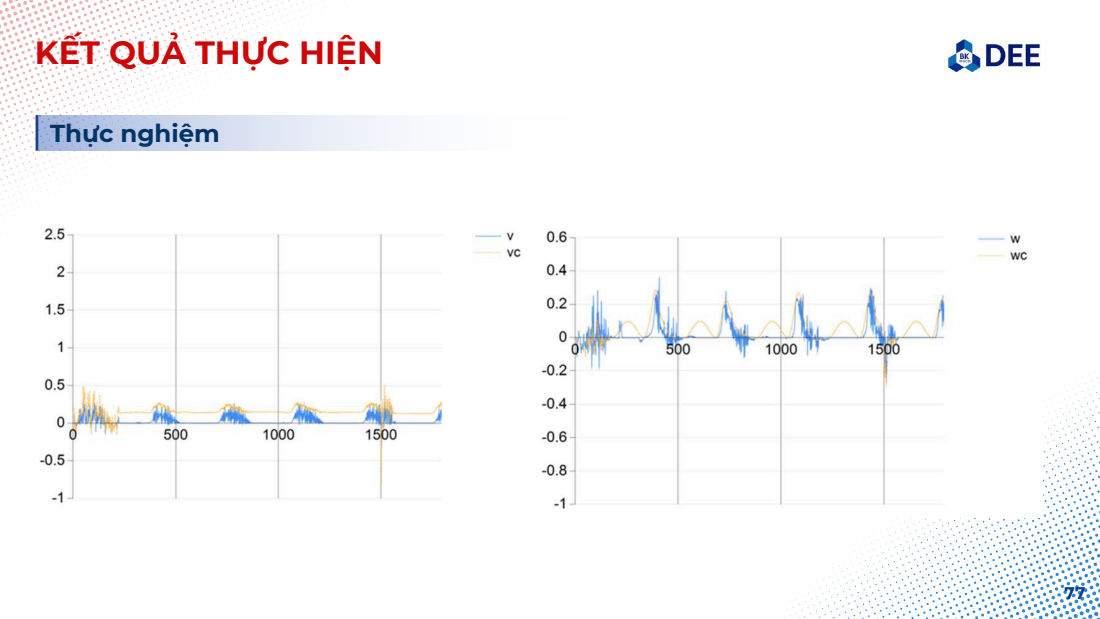
[picture p155: page 77]
Thực nghiệm

## KẾT QUẢ THỰC HIỆN

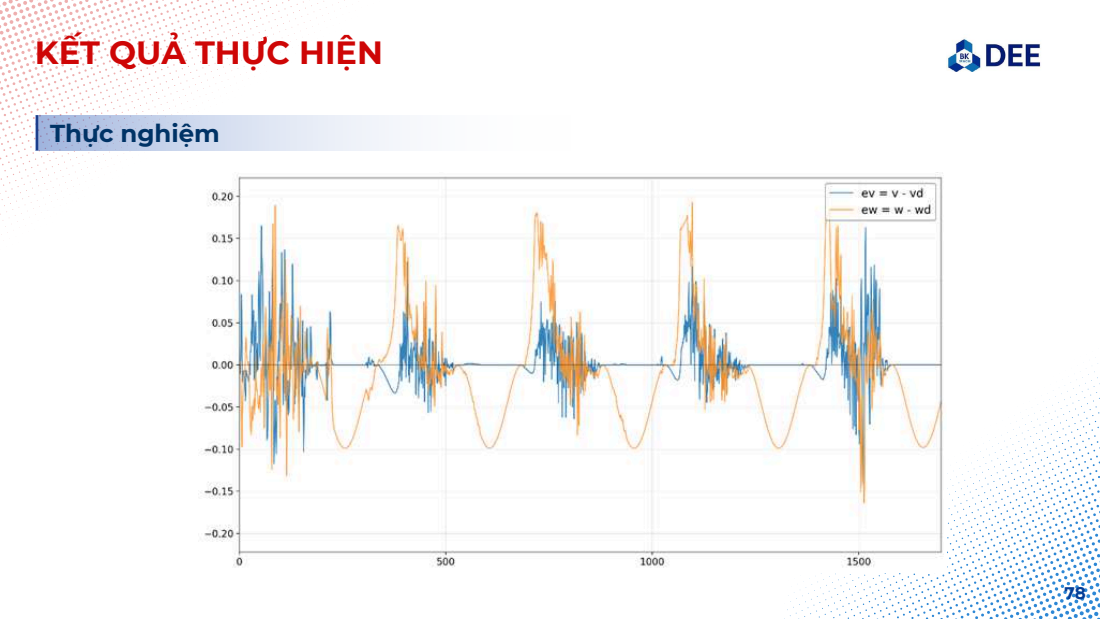
[picture p156: page 78]
Thực nghiệm

## KẾT QUẢ THỰC HIỆN

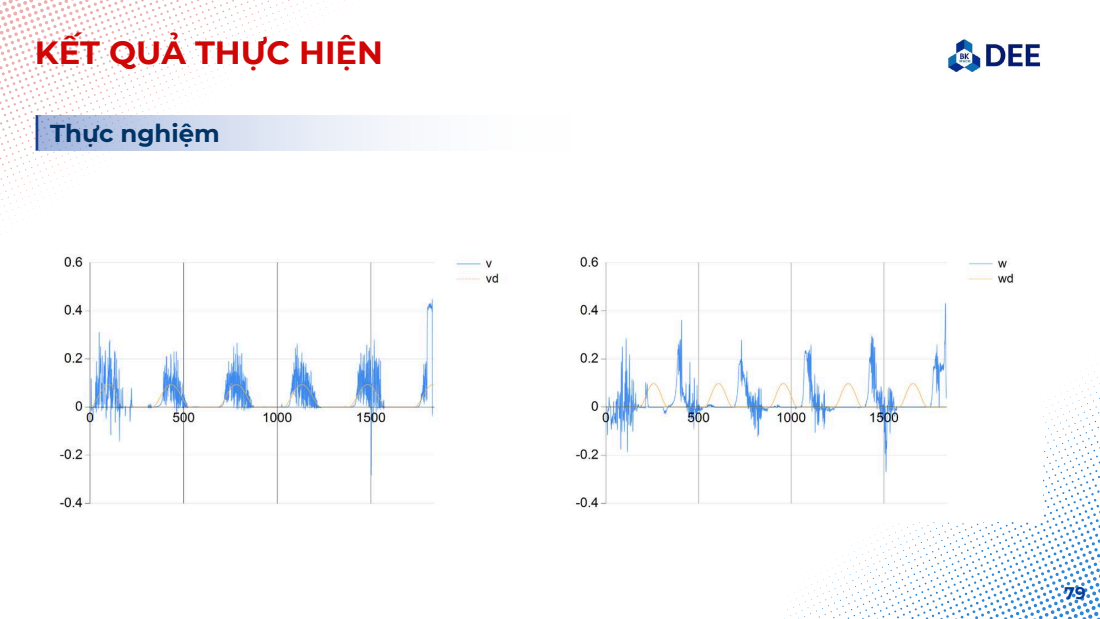
[picture p157: page 79]
Thực nghiệm

## KẾT QUẢ THỰC HIỆN

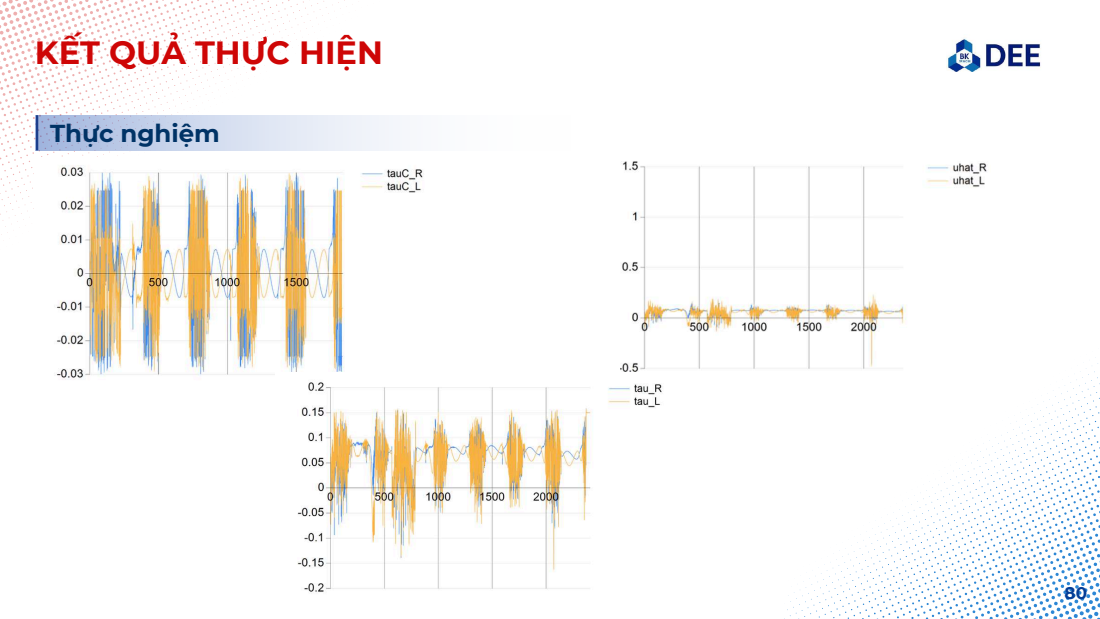
[picture p158: page 80]
Thực nghiệm

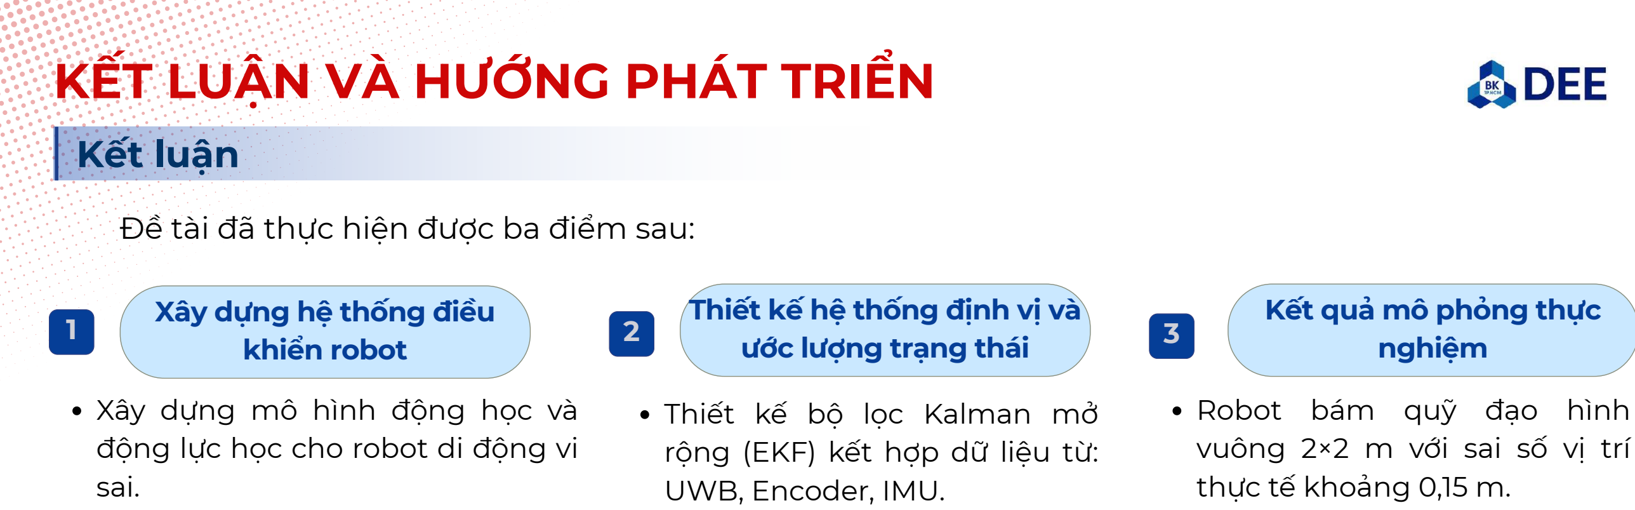
[picture p159: figure]
KẾT LUẬN VÀ HƯỚNG PHÁT TRIỂN; Kết luận; Thiết kế bộ lọc Kalman mở rộng (EKF) kết hợp dữ liệu từ: UWB, Encoder, IMU.; Xây dựng mô hình động học và động lực học cho robot di động vi sai.; Đề tài đã thực hiện được ba điểm sau:; Xây dựng hệ thống điều khiển robot; Thiết kế hệ thống định vị và ước lượng trạng thái; Kết quả mô phỏng thực nghiệm; Robot bám quỹ đạo hình vuông 2×2 m với sai số vị trí thực tế khoảng 0,15 m.

81

Hệ thống UWB chỉ sử dụng 2 anchor giúp giảm chi phí lắp đặt.
EKF giúp:
Tăng độ chính xác định vị, Giảm ảnh hưởng nhiễu và
trôi cảm biến,
Xử lý trường hợp mất dữ
liệu cảm biến.

Đề xuất kiến trúc điều khiển phân tầng gồm:
Bộ điều khiển Kanayama dùng để bám quỹ đạo.
Bộ điều khiển ORADP giúp
robot thích nghi với thay đổi tải trọng và nhiễu môi trường. Bộ điều khiển có khả năng tối ưu năng lượng và tăng độ bền vững khi hoạt động thực tế.

Vận tốc robot bám tốt vận tốc tham chiếu dù có nhiễu thực tế.
Kết quả cho thấy hệ thống
hoạt động ổn định, có tính thích nghi và khả năng ứng dụng trong nhà màng nông
nghiệp.

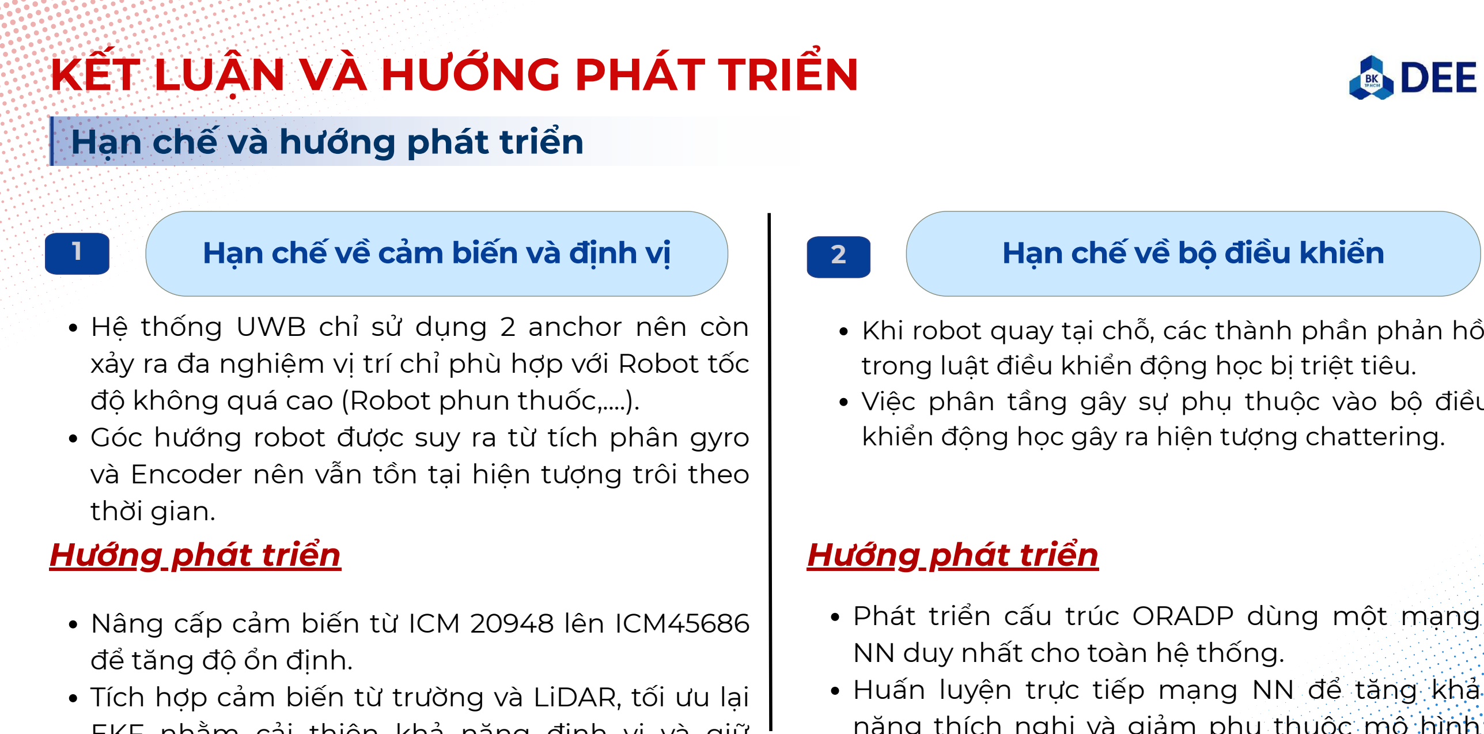
[picture p160: figure]
KẾT LUẬN VÀ HƯỚNG PHÁT TRIỂN; Hạn chế và hướng phát triển; thời gian. Hướng phát triển; để tăng độ ổn định.; Hướng phát triển; Phát triển cấu trúc ORADP dùng một mạng NN duy nhất cho toàn hệ thống.

Khi robot quay tại chỗ, các thành phần phản hồi trong luật điều khiển động học bị triệt tiêu.

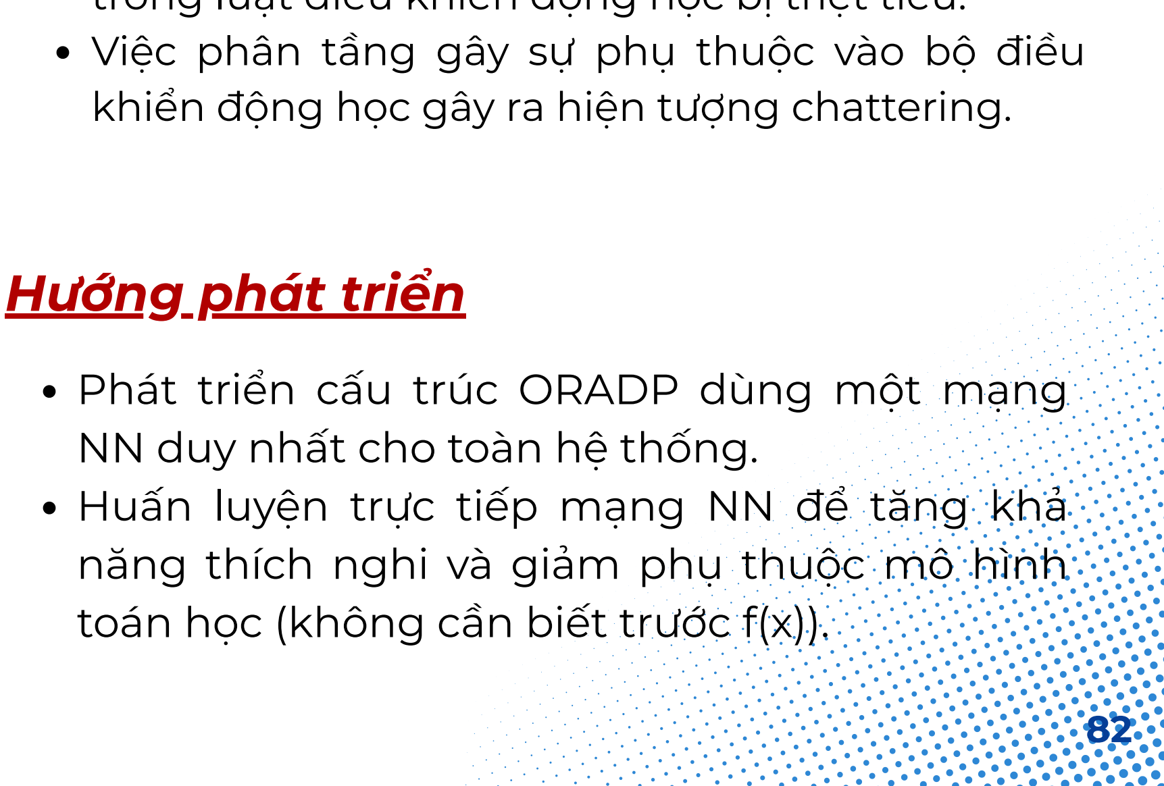
[picture p161: figure]
toán học (không cần biết trước f(x)).

Việc phân tầng gây sự phụ thuộc vào bộ điều khiển động học gây ra hiện tượng chattering.

Hệ thống UWB chỉ sử dụng 2 anchor nên còn xảy ra đa nghiệm vị trí chỉ phù hợp với Robot tốc độ không quá cao (Robot phun thuốc,....).
Góc hướng robot được suy ra từ tích phân gyro và Encoder nên vẫn tồn tại hiện tượng trôi theo
Hạn chế về cảm biến và định vị | Hạn chế về bộ điều khiển

Nâng cấp cảm biến từ ICM 20948 lên ICM45686

Tích hợp cảm biến từ trường và LiDAR, tối ưu lại EKF nhằm cải thiện khả năng định vị và giữ robot di chuyển chính giữa luống cây.

Huấn luyện trực tiếp mạng NN để tăng khả năng thích nghi và giảm phụ thuộc mô hình

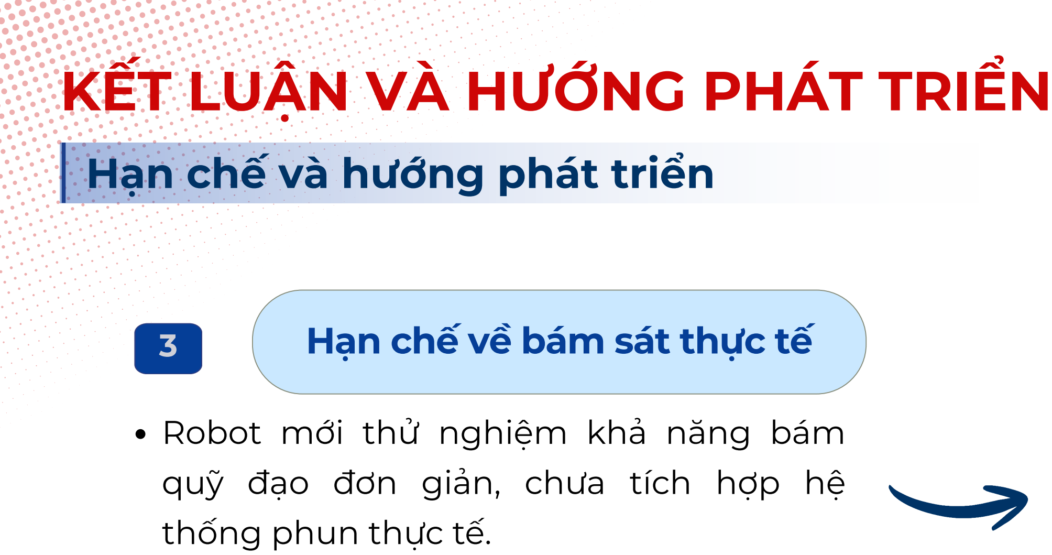
[picture p162: figure]
KẾT LUẬN VÀ HƯỚNG PHÁT TRIỂN; Hạn chế và hướng phát triển; 3 Hạn chế về bám sát thực tế; Robot mới thử nghiệm khả năng bám; quỹ đạo đơn giản, chưa tích; hợp hệ; thống phun thực tế.

Chưa đánh giá trong môi trường nhà màng phức tạp có vật cản hoặc nhiều luống cây.

Hướng phát triển

Tích hợp bơm điện tử và van điện từ cho

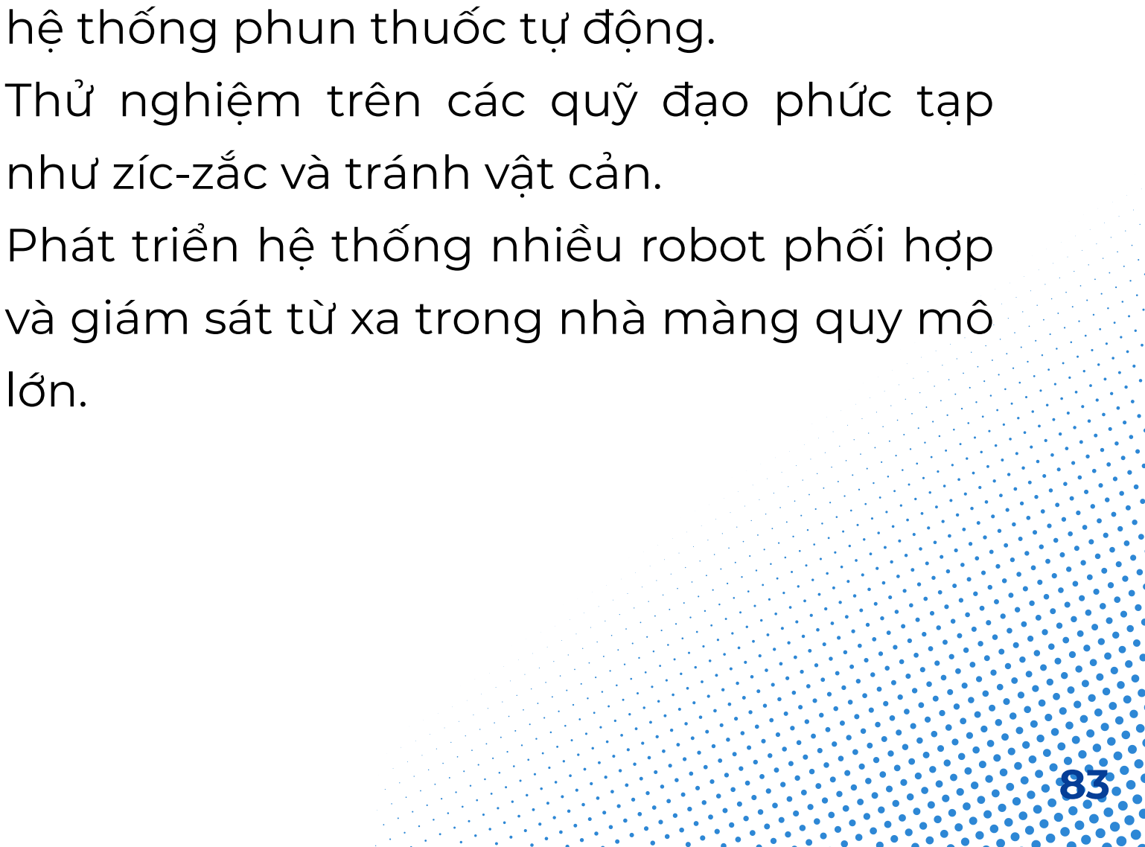
[picture p163: figure]
hệ thống phun thuốc tự động. Thử nghiệm trên các quỹ đạo phức tạp như zíc-zắc và tránh vật cản.; và giám sát từ xa trong nhà màng quy mô lớn.

Phát triển hệ thống nhiều robot phối hợp

## NHỮNG CẢI THIỆN TỪ GỢI Ý CỦA GVPB

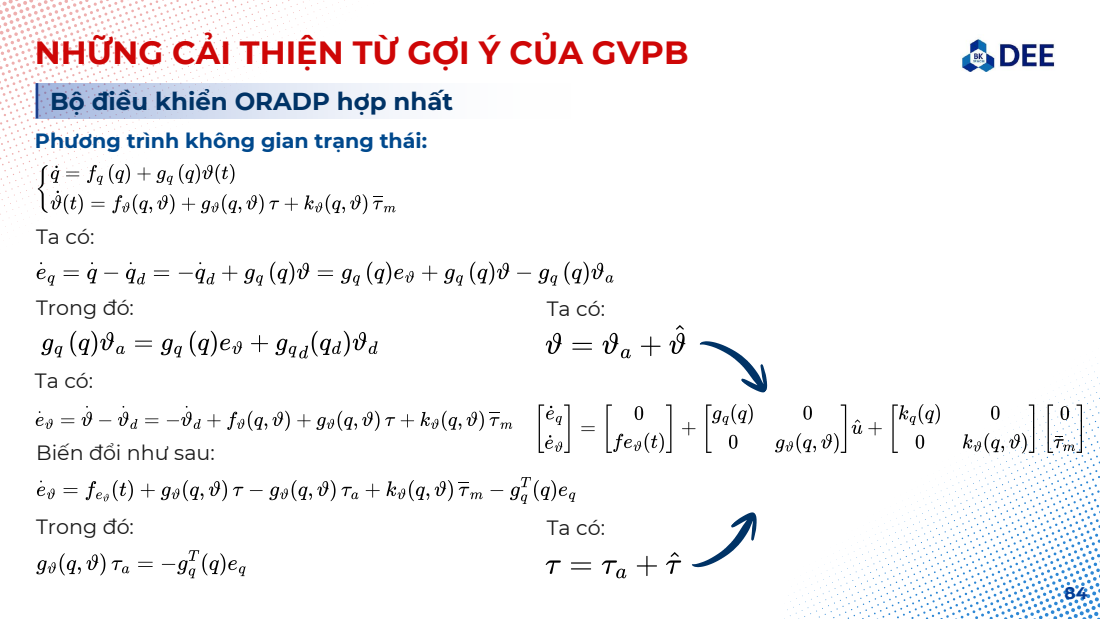
[picture p164: page 84]
Trong đó:

Bộ điều khiển ORADP hợp nhất
Phương trình không gian trạng thái:

Biến đổi như sau:

## NHỮNG CẢI THIỆN TỪ GỢI Ý CỦA GVPB

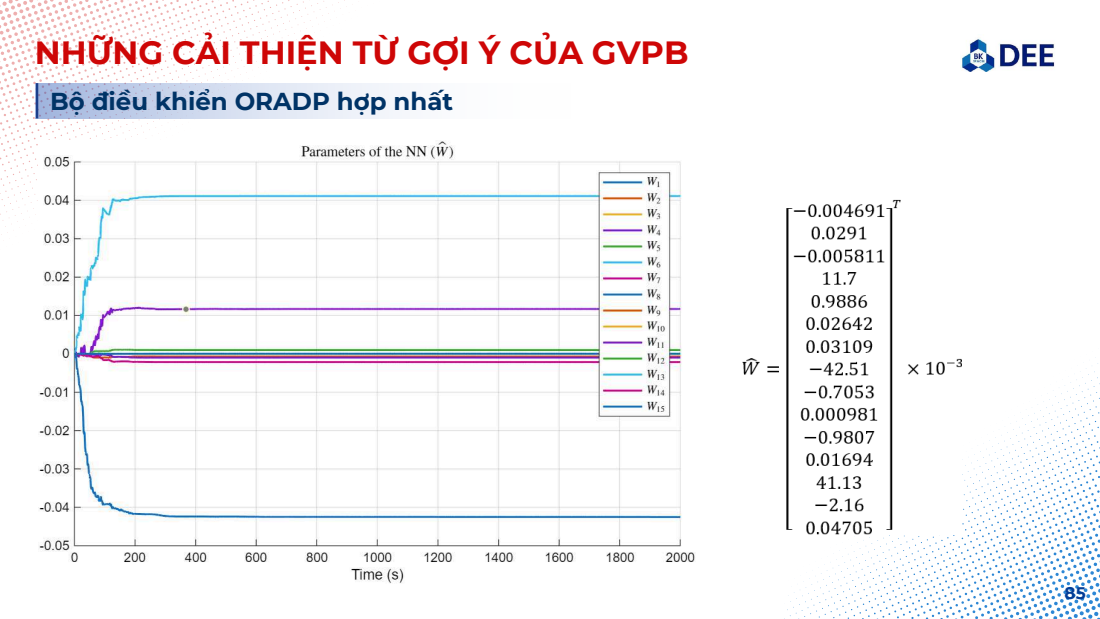
[picture p165: page 85]

Bộ điều khiển ORADP hợp nhất

## NHỮNG CẢI THIỆN TỪ GỢI Ý CỦA GVPB

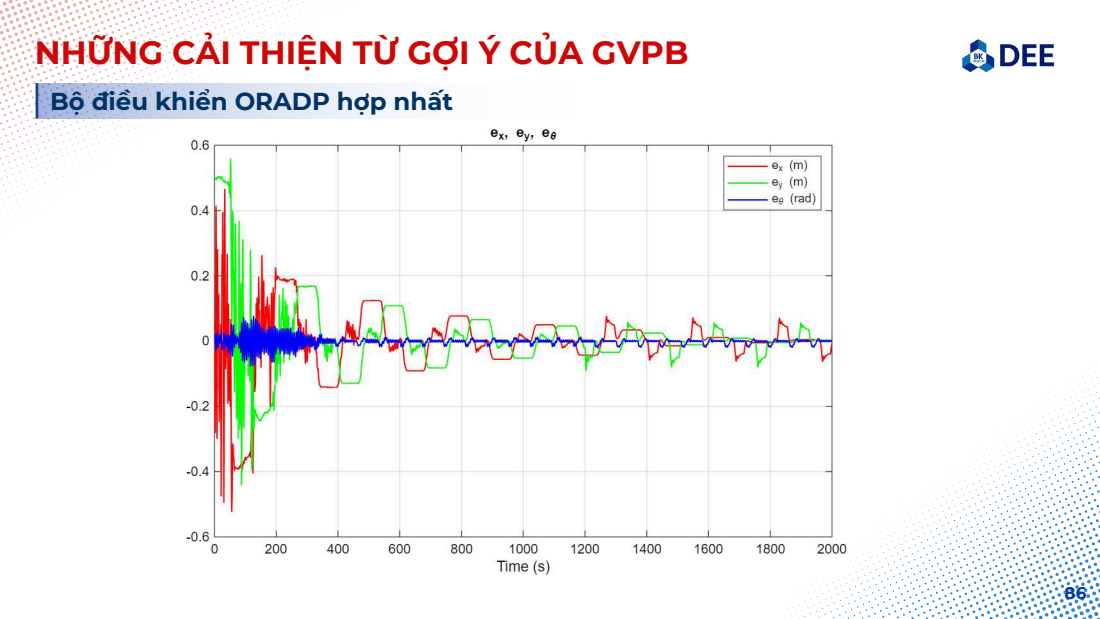
[picture p166: page 86]

Bộ điều khiển ORADP hợp nhất

## NHỮNG CẢI THIỆN TỪ GỢI Ý CỦA GVPB

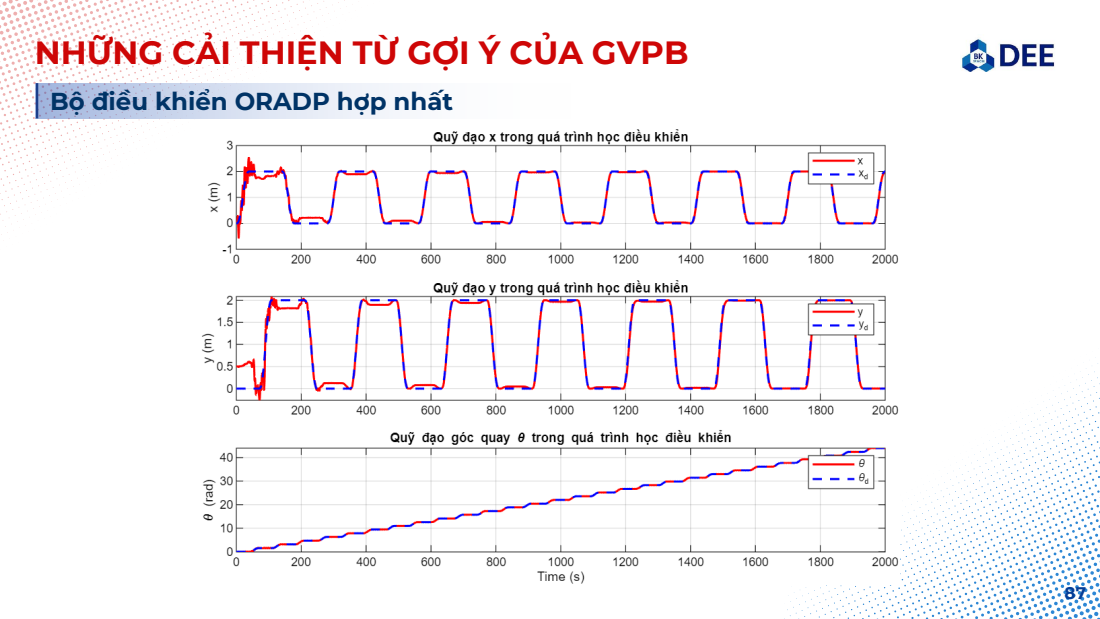
[picture p167: page 87]

Bộ điều khiển ORADP hợp nhất

## NHỮNG CẢI THIỆN TỪ GỢI Ý CỦA GVPB

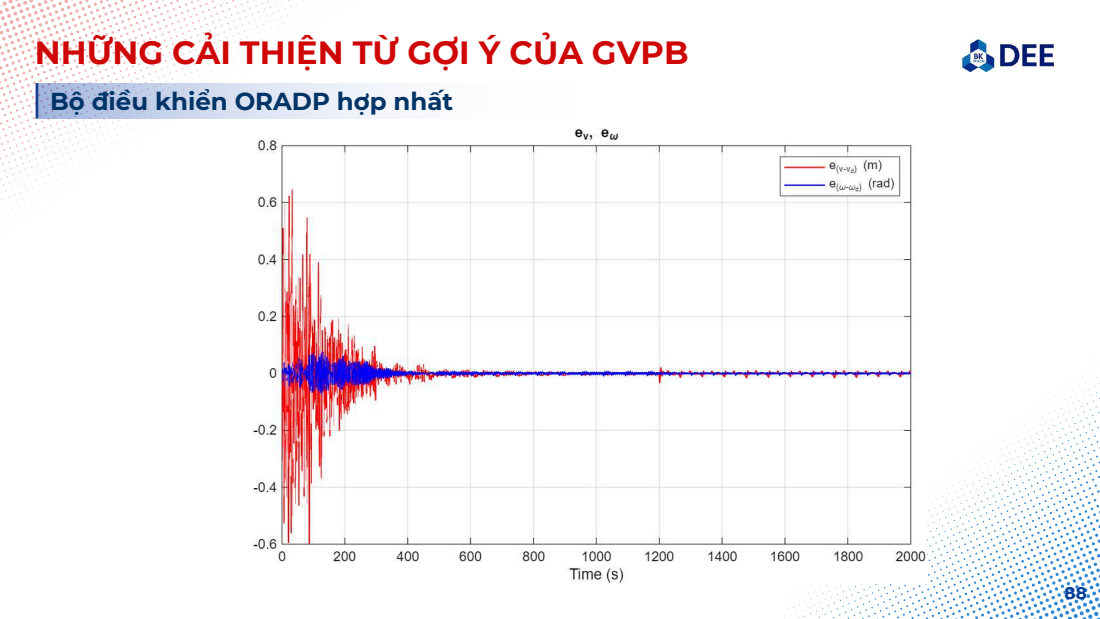
[picture p168: page 88]

Bộ điều khiển ORADP hợp nhất

## NHỮNG CẢI THIỆN TỪ GỢI Ý CỦA GVPB

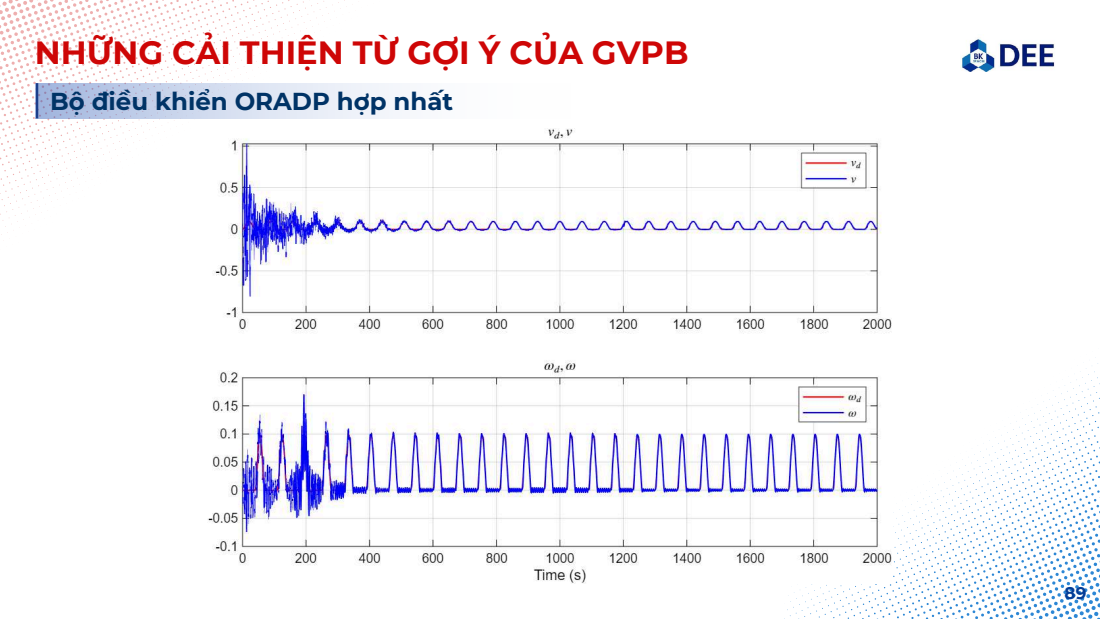
[picture p169: page 89]

Bộ điều khiển ORADP hợp nhất

## NHỮNG CẢI THIỆN TỪ GỢI Ý CỦA GVPB

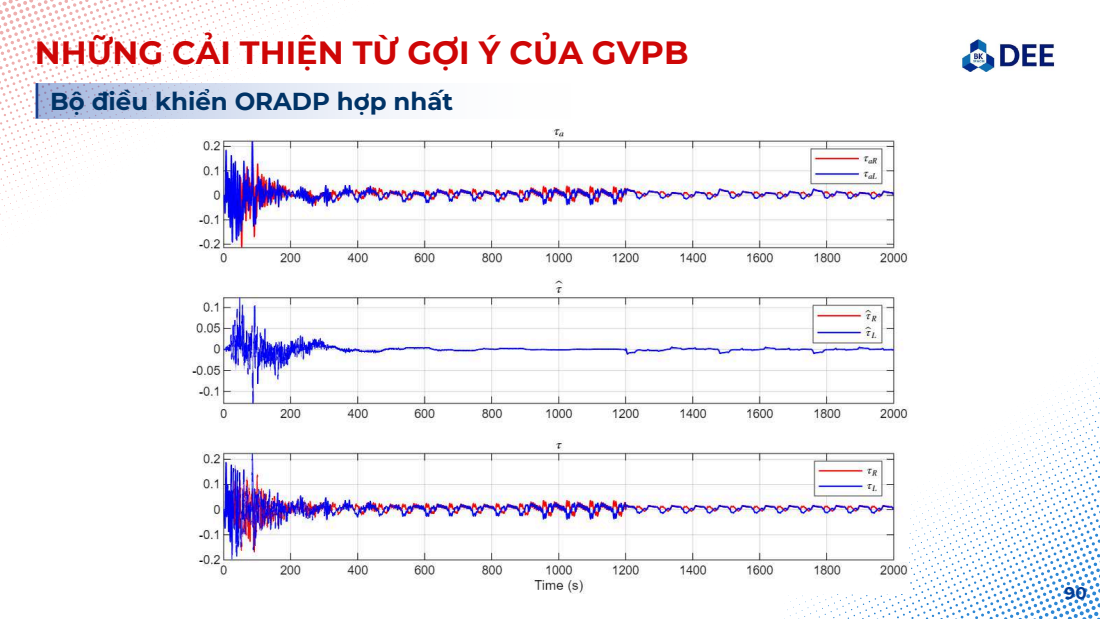
[picture p170: page 90]

Bộ điều khiển ORADP hợp nhất

## NHỮNG CẢI THIỆN TỪ GỢI Ý CỦA GVPB

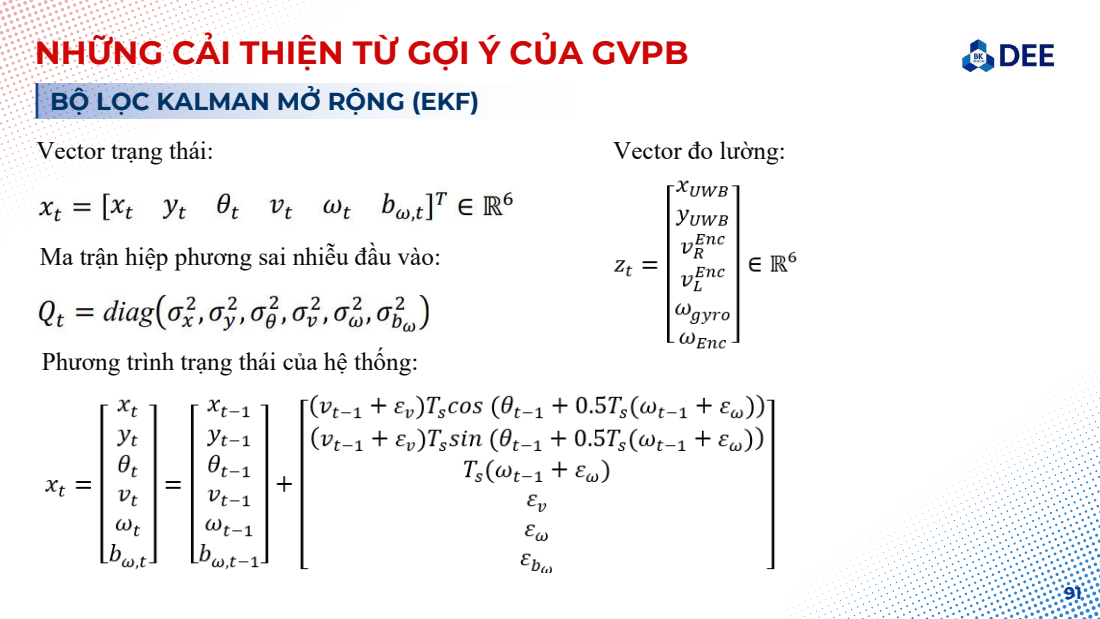
[picture p171: page 91]

BỘ LỌC KALMAN MỞ RỘNG (EKF)
Vector trạng thái:

Vector đo lường:

Ma trận hiệp phương sai nhiễu đầu vào:

Phương trình trạng thái của hệ thống:

## NHỮNG CẢI THIỆN TỪ GỢI Ý CỦA GVPB

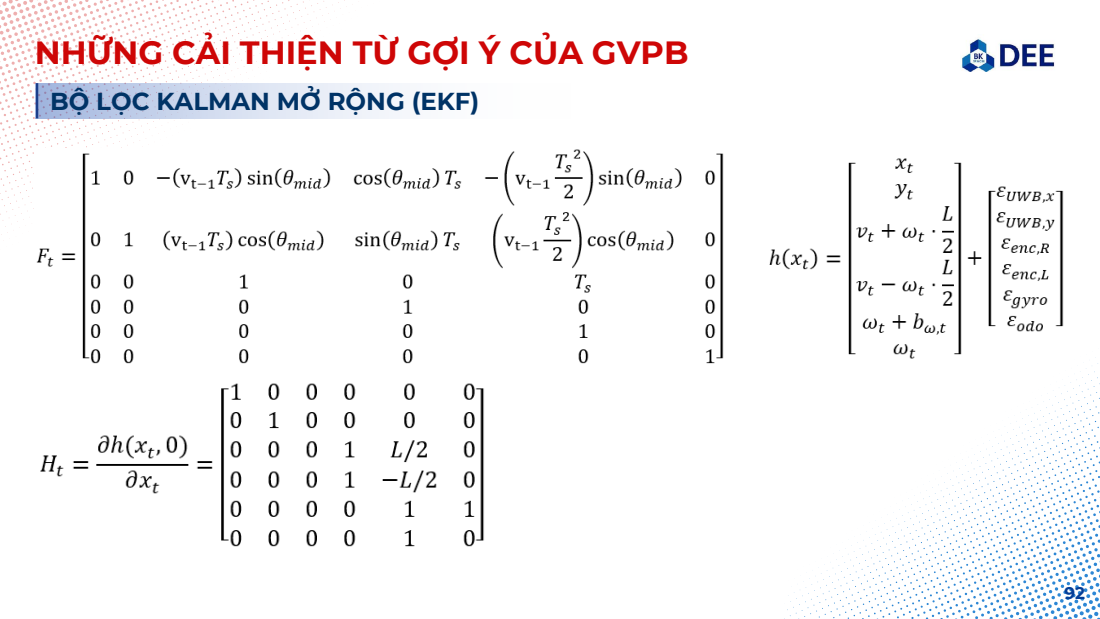
[picture p172: page 92]

BỘ LỌC KALMAN MỞ RỘNG (EKF)

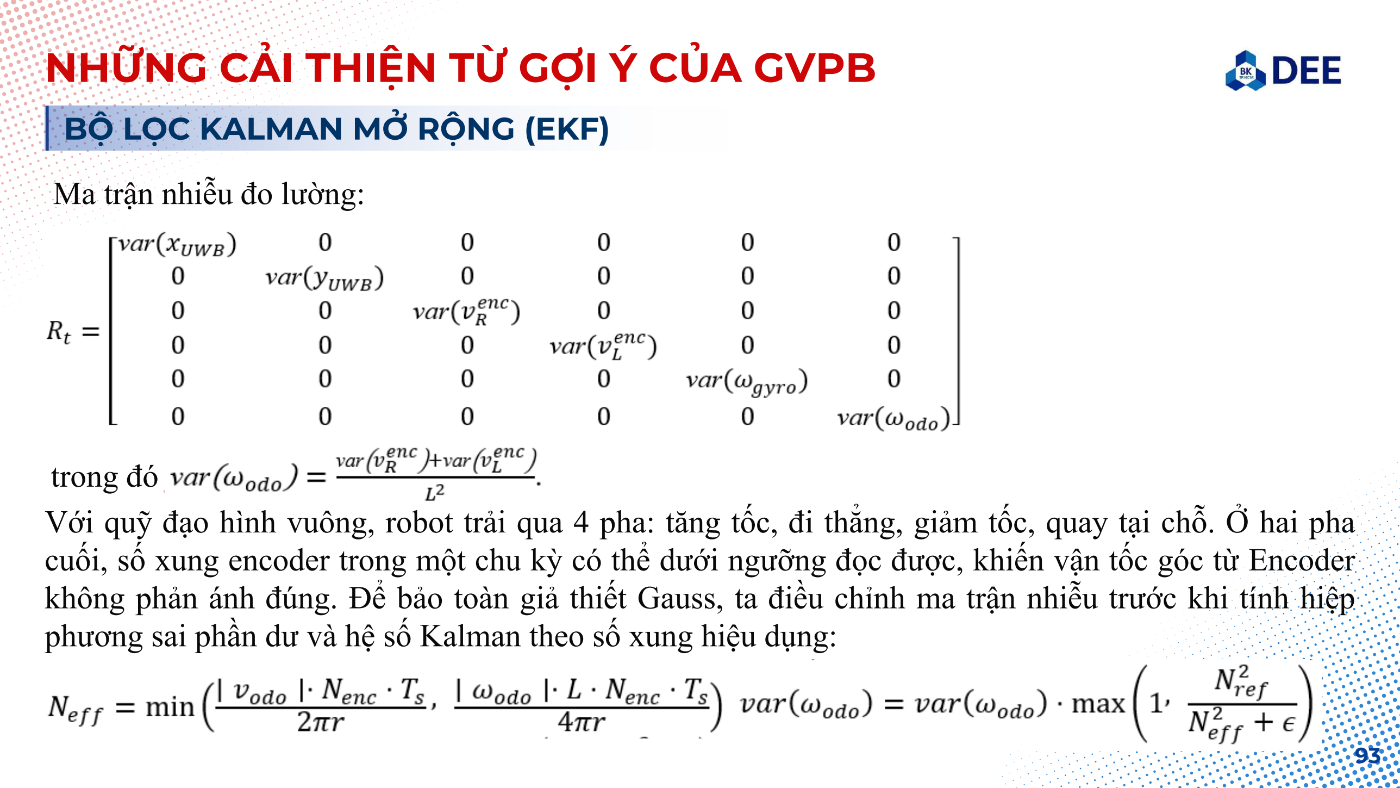
[picture p173: figure]
NHỮNG CẢI THIỆN TỪ GỢI Ý CỦA GVPB; BỘ LỌC KALMAN MỞ RỘNG (EKF); Ma trận nhiễu đo lường:; trong đó

Với quỹ đạo hình vuông, robot trải qua 4 pha: tăng tốc, đi thẳng, giảm tốc, quay tại chỗ. Ở hai pha cuối, số xung encoder trong một chu kỳ có thể dưới ngưỡng đọc được, khiến vận tốc góc từ Encoder không phản ánh đúng. Để bảo toàn giả thiết Gauss, ta điều chỉnh ma trận nhiễu trước khi tính hiệp phương sai phần dư và hệ số Kalman theo số xung hiệu dụng:

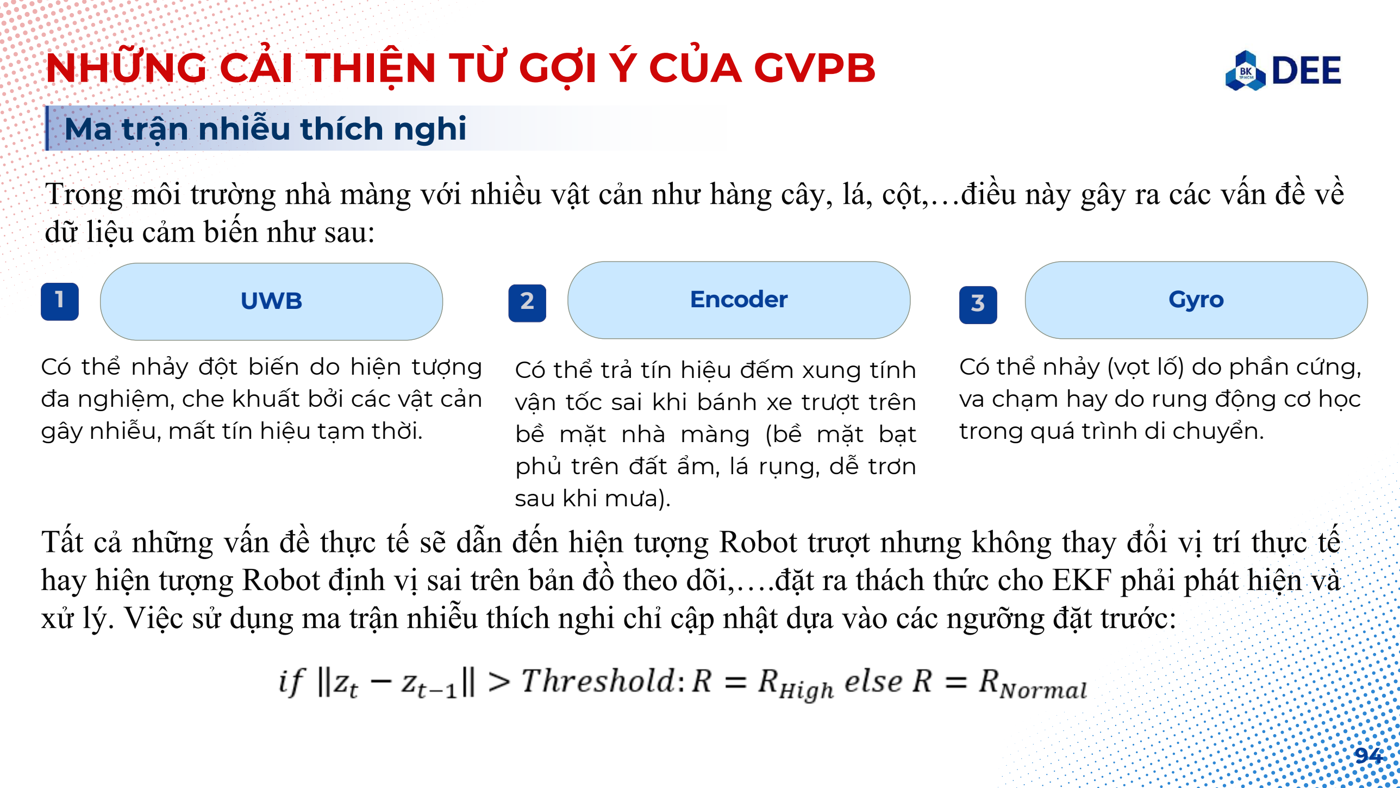
[picture p174: figure]
NHỮNG CẢI THIỆN TỪ GỢI Ý CỦA GVPB; Ma trận nhiễu thích nghi; UWB; Encoder; Gyro; Có thể trả tín hiệu đếm xung tính vận tốc sai khi bánh xe trượt trên bề mặt nhà màng (bề mặt bạt phủ trên đất ẩm, lá rụng, dễ trơn sau khi mưa).; Có thể nhảy đột biến do hiện tượng đa nghiệm, che khuất bởi các vật cản gây nhiễu, mất tín hiệu tạm thời.; Có thể nhảy (vọt lố) do phần cứng, va chạm hay do rung động cơ học trong quá trình di chuyển.; dữ liệu cảm biến như sau:

Trong môi trường nhà màng với nhiều vật cản như hàng cây, lá, cột,…điều này gây ra các vấn đề về

Tất cả những vấn đề thực tế sẽ dẫn đến hiện tượng Robot trượt nhưng không thay đổi vị trí thực tế hay hiện tượng Robot định vị sai trên bản đồ theo dõi,….đặt ra thách thức cho EKF phải phát hiện và xử lý. Việc sử dụng ma trận nhiễu thích nghi chỉ cập nhật dựa vào các ngưỡng đặt trước:

## NHỮNG CẢI THIỆN ĐÃ ĐẠT ĐƯỢC TỪ GỢI Ý CỦA GVPB

Ma trận nhiễu thích nghi

Điều này rõ ràng cho thấy việc ngưỡng được đặt thủ công, không có cơ sở thống kê, không xét đến hiệp phương sai dự đoán , khi hai mốc UWB cùng bị nhiễu đồng thời dẫn đến các điều kiện rẽ nhánh đều bỏ qua lúc này bộ lọc EKF mất toàn bộ tham chiếu và khi robot xoay nhanh, sai lệch tự nhiên lớn cũng dẫn đến điều kiện rẽ nhánh dễ báo sai. Đồ án sử dụng thuật toán khoảng cách Mahalanobis để cập nhật liên tục ma trận nhiễu trong quá trình di chuyển Robot.
Định nghĩa khoảng cách Mahalanobis bình phương như sau:

95

1

## NHỮNG CẢI THIỆN TỪ GỢI Ý CỦA GVPB

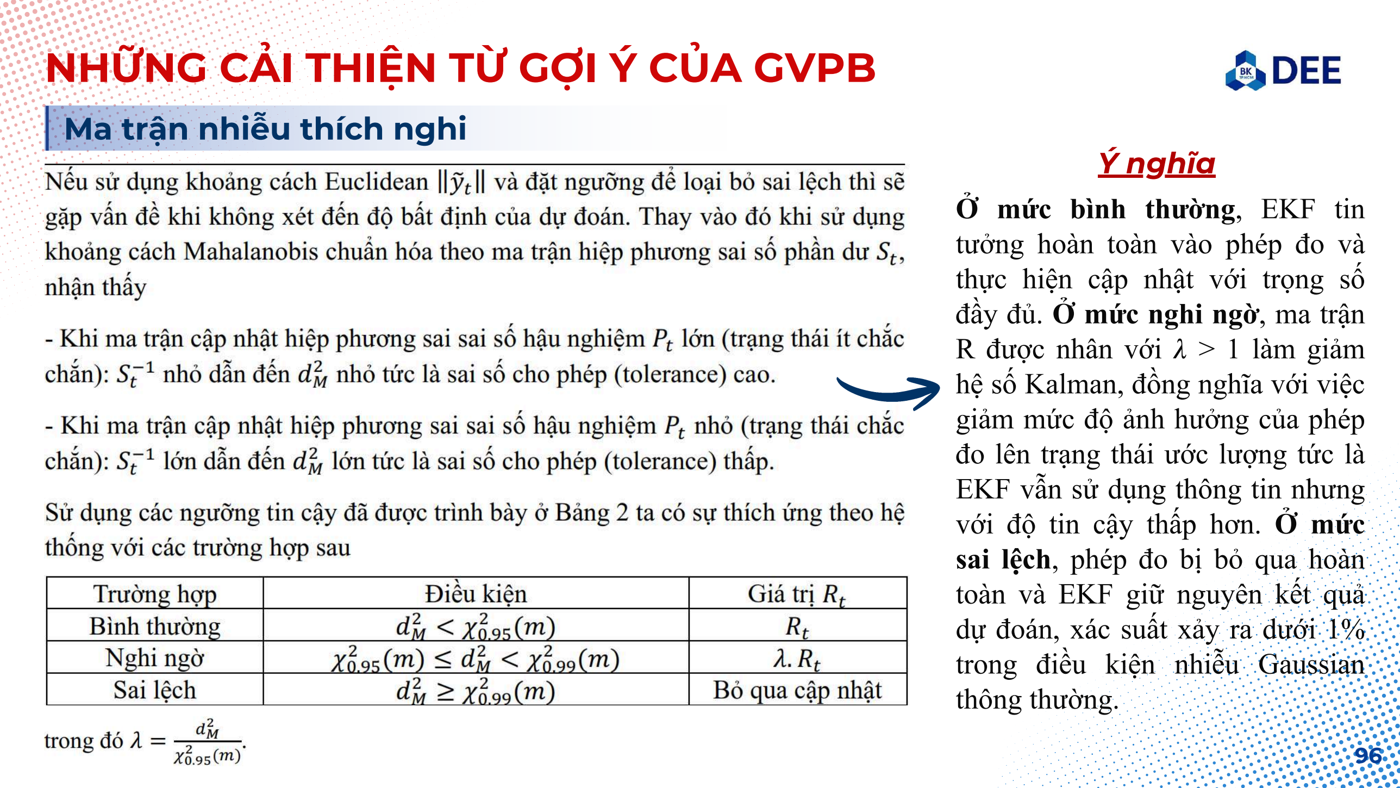
[picture p175: page 96]

Ma trận nhiễu thích nghi

96

Ý nghĩa
Ở mức bình thường, EKF tin tưởng hoàn toàn vào phép đo và thực hiện cập nhật với trọng số đầy đủ. Ở mức nghi ngờ, ma trận R được nhân với λ > 1 làm giảm hệ số Kalman, đồng nghĩa với việc giảm mức độ ảnh hưởng của phép đo lên trạng thái ước lượng tức là EKF vẫn sử dụng thông tin nhưng với độ tin cậy thấp hơn. Ở mức sai lệch, phép đo bị bỏ qua hoàn toàn và EKF giữ nguyên kết quả dự đoán, xác suất xảy ra dưới 1% trong điều kiện nhiễu Gaussian thông thường.

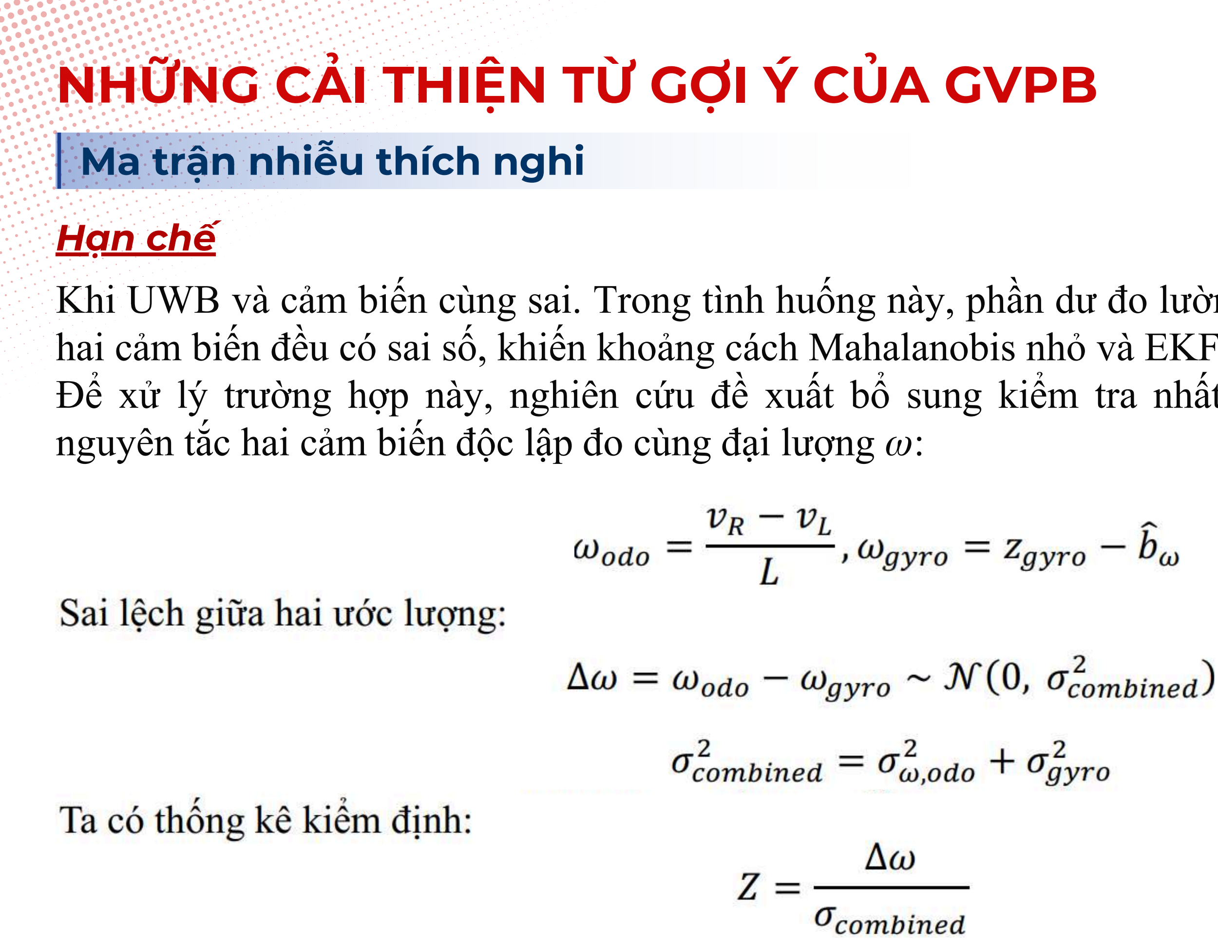
[picture p176: figure]
NHỮNG CẢI THIỆN TỪ GỢI Ý CỦA GVPB; Ma trận nhiễu thích nghi; Hạn chế

Khi UWB và cảm biến cùng sai. Trong tình huống này, phần dư đo lường UWB tiến về 0 mặc dù cả hai cảm biến đều có sai số, khiến khoảng cách Mahalanobis nhỏ và EKF không nhận ra bất thường. Để xử lý trường hợp này, nghiên cứu đề xuất bổ sung kiểm tra nhất quán vận tốc góc dựa trên nguyên tắc hai cảm biến độc lập đo cùng đại lượng ω:

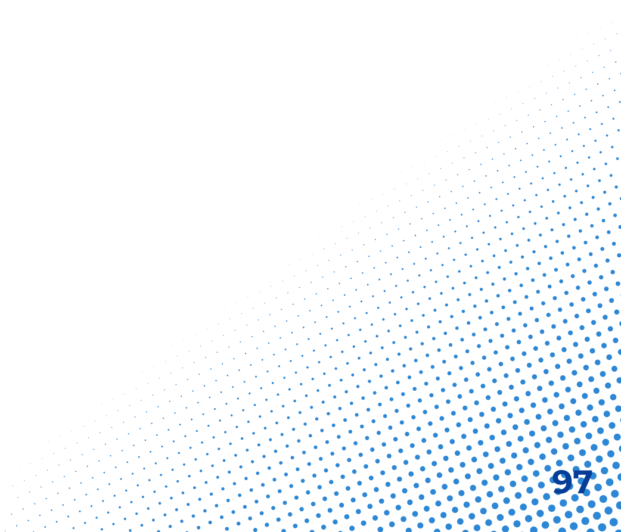
[picture p177: figure]

## NHỮNG CẢI THIỆN TỪ GỢI Ý CỦA GVPB

Ma trận nhiễu thích nghi

98

Áp dụng quy tắc 3 Sigma với mức tin cậy 99.7%, nếu ∣ Z ∣> 3 điều này nghĩa là có ít nhất một trong hai cảm biến có sai số bất thường.
Khi phát hiện không nhất quán, hệ thống chạy song song hai dự đoán: một dự đoán sử dụng ω_odo và một dự đoán sử dụng ω_gyro, sau đó so sánh khoảng cách Mahalanobis của mỗi dự đoán với UWB để xác định cảm biến nào phù hợp hơn và loại bỏ cảm biến còn lại. Với 2 lớp xử lý bộ lọc EKF có thể phát hiện các trường hợp sau

Khi hai bánh xe trượt đều với cùng một vận tốc, đồng thời tín hiệu UWB cũng bị nhiễu và nhảy vọt một khoảng cách khớp đúng với quãng đường trượt ảo đó. Lúc này, phương trình ω_odo tự triệt tiêu, và khoảng cách Mahalanobis của UWB đánh giá sai lệch này là "Bình thường".

Hạn chế

## NHỮNG CẢI THIỆN ĐÃ ĐẠT ĐƯỢC TỪ GỢI Ý CỦA GVPB

Ma trận nhiễu thích nghi
Để giải quyết triệt để trường hợp tồi tệ nhất này mà không làm tăng chi phí phần cứng, nghiên cứu đề xuất tận dụng cảm biến gia tốc tịnh tiến dọc trục X (a_x) có sẵn từ module IMU để làm lớp bảo vệ thứ ba (Layer 3). Nguyên lý của lớp bảo vệ này dựa trên định luật II Newton: Bất kỳ sự thay đổi vận tốc tuyến tính nào (từ bánh xe trượt) cũng đòi hỏi một gia tốc tương ứng. Gọi a_odo là gia tốc tuyến tính tức thời tính toán từ phép vi phân vận tốc encoder:

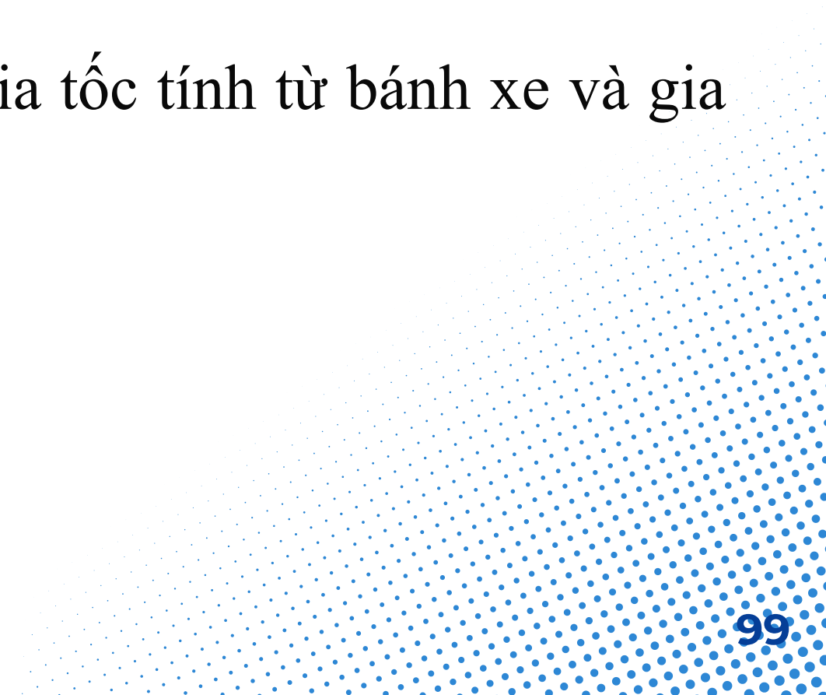
[picture p178: figure]

Đại lượng phần dư gia tốc Δa được xác định bằng độ chênh lệch giữa gia tốc tính từ bánh xe và gia tốc thực tế đo được từ IMU:

Ta có thống kê kiểm định Z cho lớp bảo vệ thứ 3 được định nghĩa:

## NHỮNG CẢI THIỆN TỪ GỢI Ý CỦA GVPB

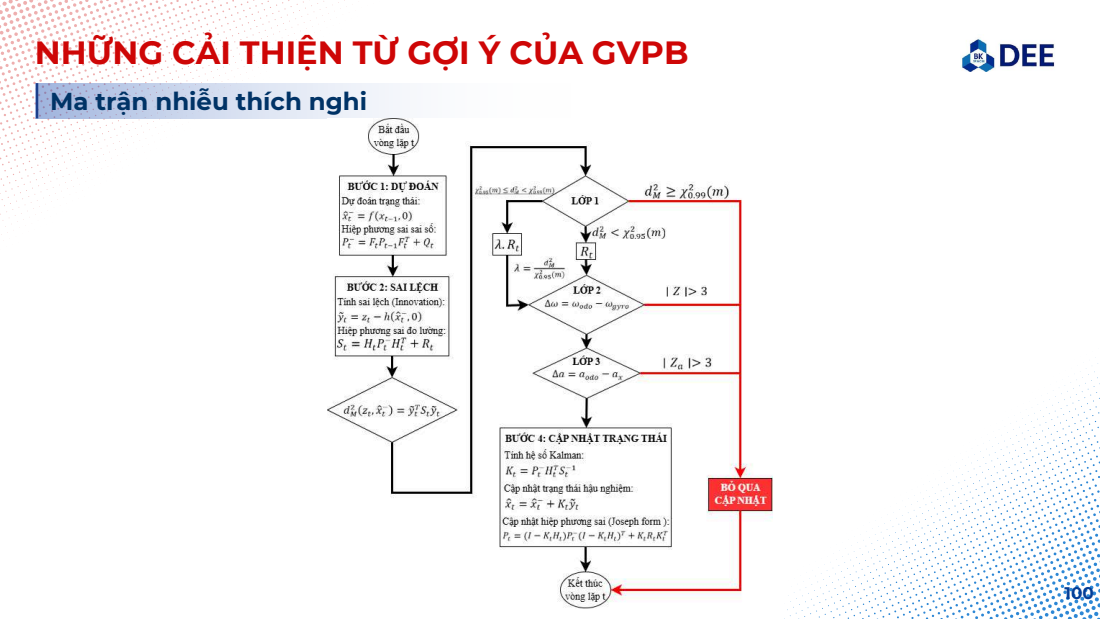
[picture p179: page 100]

Ma trận nhiễu thích nghi
