Minh-Nguyen-CEAA/Optimal-Control-Of-A-Pesticide-Spray-Robot-Operating-In-A-Greenhouse/PCB_Capstone/PCB_Capstone.kicad_pcb

## KiCad design PCB_Capstone/PCB_Capstone.kicad_pcb (2026-05-14)

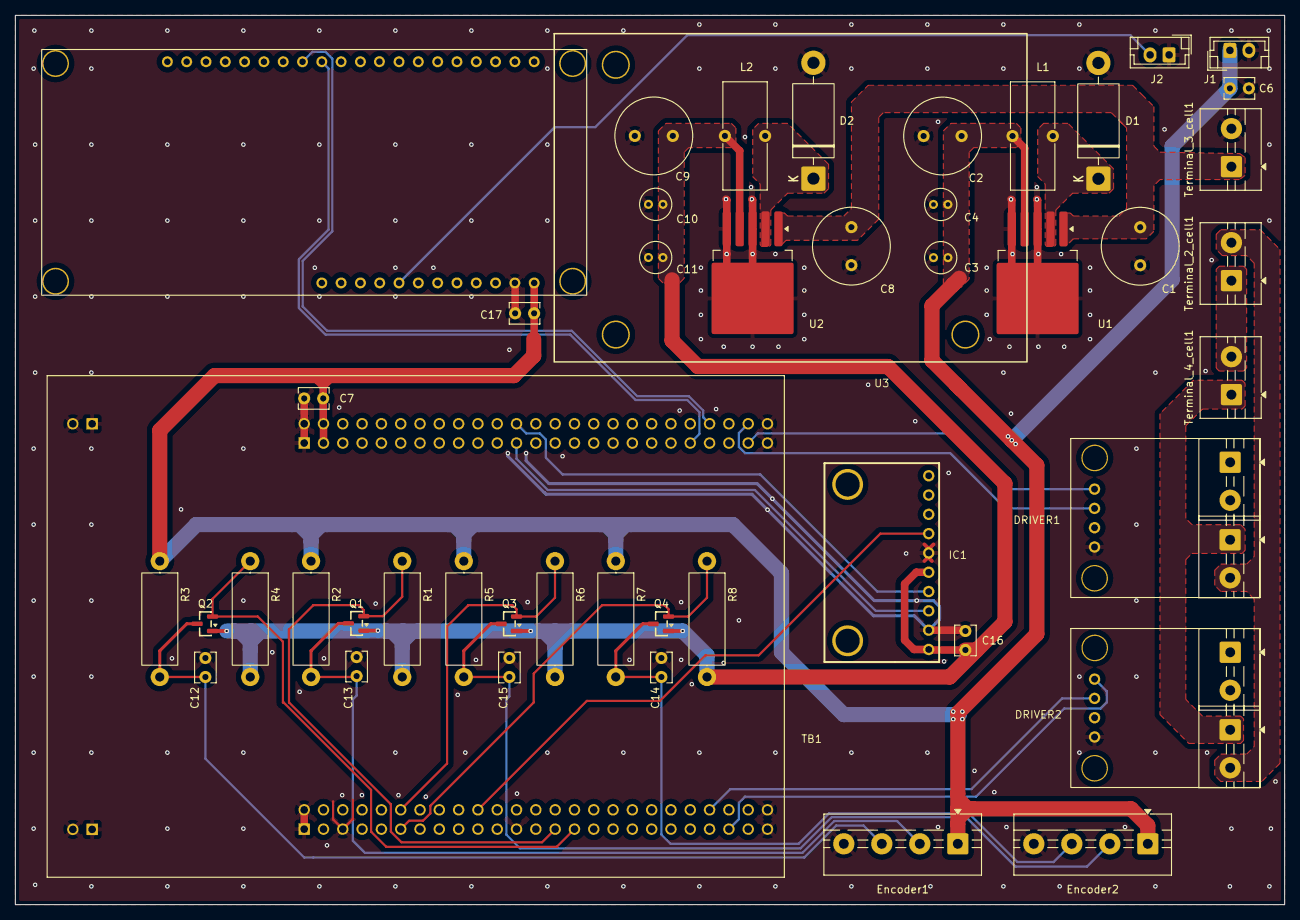
[picture p180: board PCB_Capstone.kicad_pcb from above]

Board: 2 copper layers, 167.0 x 117.0 mm, 47 parts (0 on the bottom side), 27 nets.

Parts:
C1, C8: 100uF; C_Radial_D10.0mm_H20.0mm_P5.00mm
C2, C9: 220uF; C_Radial_D10.0mm_H12.5mm_P5.00mm
C3, C10: 10uF; C_Radial_D4.0mm_H7.0mm_P1.50mm
C4, C11: 0.1uF; C_Radial_D4.0mm_H7.0mm_P1.50mm
C6, C7, C16, C17: 0.1uF; C_Disc_D3.8mm_W2.6mm_P2.50mm
C12, C13, C14, C15: 1nF; C_Disc_D3.8mm_W2.6mm_P2.50mm
D1, D2: 1N5822; D_DO-201AD_P15.24mm_Horizontal
DRIVER1: MOTOR 1; Module Driver 8871
DRIVER2: MOTOR 2; Module Driver 8871
ESP32_UWB1: ESP32 UWB
Encoder1, Encoder2: Screw_Terminal_01x04; TerminalBlock_MaiXu_MX126-5.0-04P_1x04_P5.00mm
IC1: *; ICM-20948
J1, J2: Conn_01x02_Socket; JST_EH_B2B-EH-A_1x02_P2.50mm_Vertical
L1, L2: 33uH; L_Toroid_Vertical_L14.0mm_W5.6mm_P5.30mm_Bourns_5700
Q1, Q2, Q3, Q4: BSS138; SOT-23
R1, R2, R3, R4, R5, R6, R7, R8: 10K; R_Axial_DIN0414_L11.9mm_D4.5mm_P15.24mm_Horizontal
TB1: STM32F4DISCOVERY; STM32F411E-DISCO
Terminal_2_cell1, Terminal_3_cell1, Terminal_4_cell1: Screw_Terminal_01x02; TerminalBlock_MaiXu_MX126-5.0-02P_1x02_P5.00mm
U1: LM2596S-5; TO-263-5_TabPin3
U2: LM2596S-3.3; TO-263-5_TabPin3
U3: DWM

Connections:
+3.3V: C9.1, C10.1, C11.1, C16.2, IC1.1 (VCC), IC1.5 (NCS), L2.1, Q1.1 (G), Q2.1 (G), Q3.1 (G), Q4.1 (G), R1.2, R4.2, R6.2, R8.2, U2.4 (FB)
+5V: C2.1, C3.1, C4.1, C6.2, C7.2, C17.2, ESP32_UWB1.21 (5V0), Encoder1.1, Encoder2.1, J1.1, L1.1, R2.1, R3.1, R5.1, R7.1, TB1.P2_3 (5V), TB1.P2_4 (5V), U1.4 (FB)
+11.1V: C1.1, C8.1, Terminal_3_cell1.1 (+), U1.1 (VIN), U2.1 (VIN)
+24V: DRIVER1.7 (VM), DRIVER2.7 (VM), Terminal_4_cell1.1 (+)
/INT: IC1.7 (INT), TB1.P1_20 (PC4)
/RX: ESP32_UWB1.12 (IO25), TB1.P2_41 (PA10)
/SCL: IC1.3 (SCL), TB1.P2_23 (PB6)
/SDA: IC1.4 (SDA), TB1.P2_24 (PB7)
/Sig A_Encoder1: C13.1, Encoder1.2, Q1.3 (D), R2.2
/Sig A_Encoder2: C15.1, Encoder2.2, Q3.3 (D), R5.2
/Sig B_Encoder1: C12.1, Encoder1.3, Q2.3 (D), R3.2
/Sig B_Encoder2: C14.1, Encoder2.3, Q4.3 (D), R7.2
/TIM1_CH1: Q1.2 (S), R1.1, TB1.P1_27 (PE9)
/TIM1_CH2: Q2.2 (S), R4.1, TB1.P1_29 (PE11)
/TIM2_CH1: Q3.2 (S), R6.1, TB1.P1_12 (PA0-WKUP)
/TIM2_CH2: Q4.2 (S), R8.1, TB1.P1_11 (PA1)
/TIM3_CH1: DRIVER1.1 (IN2), TB1.P2_47 (PC6)
/TIM3_CH2: DRIVER1.2 (IN1), TB1.P2_48 (PC7)
/TIM4_CH1: DRIVER2.2 (IN1), TB1.P1_44 (PD12)
/TIM4_CH2: DRIVER2.1 (IN2), TB1.P1_45 (PD13)
/TX: ESP32_UWB1.13 (IO26), TB1.P2_44 (PA9)
/TX_RX UWB_ESP32: ESP32_UWB1.28 (IO16), J2.2
GND: C1.2, C2.2, C3.2, C4.2, C6.1, C7.1, C8.2, C9.2, C10.2, C11.2, C12.2, C13.2, C14.2, C15.2, C16.1, C17.1, D1.2 (A), D2.2 (A), DRIVER1.4 (GND), DRIVER2.4 (GND), ESP32_UWB1.22 (GND), Encoder1.4, Encoder2.4, IC1.2 (GND), IC1.6 (ADO), J1.2, J2.1, TB1.P1_1 (GND), TB1.P1_2 (GND), TB1.P1_5 (GND), TB1.P1_23 (GND), TB1.P1_49 (GND), TB1.P1_50 (GND), TB1.P2_1 (GND), TB1.P2_2 (GND), TB1.P2_49 (GND), TB1.P2_50 (GND), Terminal_3_cell1.2 (-), U1.3 (GND), U1.5 (~ON/OFF), U2.3 (GND), U2.5 (~ON/OFF)
GNDDC: DRIVER1.8 (GND), DRIVER2.8 (GND), Terminal_2_cell1.2 (-)
unnamed: D1.1 (K), L1.2, U1.2 (OUT)
unnamed: D2.1 (K), L2.2, U2.2 (OUT)
unnamed: Terminal_2_cell1.1 (+), Terminal_4_cell1.2 (-)
